nagyadam979/bee_scale/wireless_scaling/experiments/H2_hx711_power_path/meresi_setup.md

# H2 — Mérési setup (HX711 power-path / excitation-lekapcsolás)

Ez a doksi a **konkrét mérési elrendezést** írja le: bekötés, pinkiosztás, hol és hogyan
mérj, milyen alvariánsokat, és mit csinálj, ha túl nagy az áram / nem kapcsol le az
excitation. A firmware: lásd `main/h2_hx711_power_path.c` (a hangolható paraméterek a fájl
tetején). Eredmények: `mereseredmenyek.csv`. Cél/küszöbök: `README.md` pass/fail tábla.

> **A H2 LÉNYEGE — két mérés (lásd 3. szakasz):**
> **(A)** a HX711 modul nyugalmi árama a modul SAJÁT VCC ágában (NEM a teljes node tápjában!),
> **(B)** a load cell excitation feszültsége az E+/E− pontok között (alvásban cél ~0 V).
> A pass CSAK akkor áll, ha az áram < ~5 µA ÉS az excitation ~0 V ÉS nincs LED/szivárgás.

> **Pinout / modul-tények (webről ellenőrizve, 2026-06-28)** — források a 6. szakaszban:
> ESP32-C3 SuperMini pinout: espboards.dev / mozelectronics / lastminuteengineers. A
> klasszikus zöld/piros HX711 breakout-on **NINCS power/státusz LED**, és **NINCS külön
> LDO/regulátor** — a VCC közvetlenül a chipre megy (2.6–5.5 V), a hídgerjesztést a HX711
> **chipen belüli AVDD-regulátora** adja (a zöld boardon R12/R13 osztó állítja, gyárilag
> ~4.3 V, ami 5 V VCC-t feltételez; 3.3 V-ról kisebb E+, de jól megy). Datasheet power-down
> áram ~1 µA (akár ~70 nA a chipre). **A te darabodon ellenőrizd.**

---

## 1. Pinkiosztás

| Funkció | ESP32-C3 SuperMini | Megjegyzés |
|---|---|---|
| HX711 `PD_SCK` (SCK) | **GPIO5** | a firmware MAGASra húzza (power-down), alvás alatt GPIO-hold tartja HIGH-on |
| HX711 `DOUT` (DT) | **GPIO6** | a firmware bemenetnek hagyja, nem olvassa |
| HX711 `VCC` | 3V3 (LDO-ról szűrt 3.3V) | **a mérés alatt a modul VCC ágába kerül a DMM** sorba — lásd 3.(A) |
| HX711 `GND` | GND | közös föld |
| Load cell `E+` | HX711 `E+` | gerjesztés + (excitation, B mérés egyik pontja) |
| Load cell `E−` | HX711 `E−` | gerjesztés − (excitation, B mérés másik pontja) |
| Load cell `A+` | HX711 `A+` | jel + (itt nem olvassuk) |
| Load cell `A−` | HX711 `A−` | jel − (itt nem olvassuk) |
| Kék user LED | GPIO8 | a firmware kikapcsolva tartja (mérés alatt sötét) |
| Vörös power LED | — (nem GPIO) | a node „rejtett fogyasztója"; a HX711-modulon tipikusan NINCS LED |

A `PD_SCK`/`DOUT` GPIO-k a firmware tetején (`HX711_PD_SCK_GPIO`, `HX711_DOUT_GPIO`) — a
H1 pin-terv, NE változtasd. Strapping lábakat (GPIO2/8/9) kerülj általános IO-nak.

---

## 2. Bekötési diagram (ASCII)

Load cell 4 vezeték (HBS-SCL-50; a színek a cella adatlapja dönti el, de gyakorlatilag
univerzális): **piros=E+, fekete=E−, zöld=A+, fehér=A−** (sárga = árnyékolás, ha van).
A jel-vezetékek (zöld/fehér) felcserélése csak a mért érték előjelét fordítja.

```
              ESP32-C3 SuperMini                         HX711-M modul                 load cell
           +----------------------+                   +----------------+              (HBS-SCL-50)
           |                      |    (A) DMM uA      |                |
           |                  3V3 |---[ µA ]---------->| VCC            |
           |                  GND |------------------->| GND            |
           |   GPIO5 (PD_SCK) o---|------------------->| PD_SCK / SCK   |
           |   GPIO6 (DOUT)   o<--|-------------------| DOUT / DT      |
           |   GPIO8 (kek LED) .  |                   |                |
           |   [piros power LED]  |                   |  E+ ---------- piros  (E+)
           +----------------------+                   |  E- ---------- fekete (E-)
                                                       |  A+ ---------- zold   (A+)
           (A) µA a HX711 VCC agaban SOROSAN           |  A- ---------- feher  (A-)
                                                       +----------------+
                                                          ^   ^
                                                          |   |
                                          (B) DMM V ----[ V ]----  a load cell E+/E- koze
                                                  (excitation: ebren > 0 V, alvasban ~0 V = PASS)
```

A node kék LED (GPIO8) a firmware-ben kikapcsolva; a vörös power LED a SuperMinin tápra mindig
világít (a HX711-modulon tipikusan nincs LED). A két DMM-bekötést (A és B) **külön** mérd.

---

## 3. A KÉT MÉRÉS — ez a H2 lényege

### (A) HX711 modul nyugalmi árama — a modul SAJÁT VCC ágában

A DMM-et (DC áram, **µA tartomány**) **SOROSAN a HX711 modul VCC ága közé** kösd: a board
**3V3** lába és a modul **VCC** lába közé. **NEM** a teljes node tápjába!

> **Miért a modul VCC ágában, és nem a teljes node tápjában?** A node maga ~185 µA-t vesz fel
> (H1-ben mért alapszám: AMS1117 LDO + GPIO/RTC). E mellett a HX711 ~1–5 µA-ja
> **differenciál-méréssel** (teljes node HX711-gyel mínusz HX711 nélkül) elveszne a zajban
> (185 vs 186 µA — leolvashatatlan). Ezért a HX711-modul áramát **KÜLÖN**, a saját VCC
> ágában mérjük: így közvetlenül a modul nyugalmi árama jön ki, ez hasonlítható a < ~5 µA
> küszöbhöz.

- DMM-beállítás: DC áram, µA tartomány (auto-range esetén várj a stabil értékre). A piros
  vezeték a műszer **A/µA hüvelyébe** (külön bemenet az árammérésnek), különben rövidre zárod.
- Olvasd le a stabil deep-sleep értéket, és írd a CSV `hx711_aram_uA` oszlopába.

### (B) Excitation feszültség — a load cell E+/E− pontjai között

A DMM-et (**V tartomány**) a load cell **E+ és E−** pontjai közé kösd (a HX711 modul E+/E−
kivezetésére).

> **FONTOS — az "ébren" referencia kell:** a firmware alapból a boot legelején AZONNAL
> power-downba teszi a HX711-et, így nincs ablak, amikor a chip aktív. A puszta ~0 V alvásban
> egy szakadt/rosszul bekötött cellánál is teljesülne → az önmagában NEM bizonyít
> *lekapcsolást*. Ezért a (B) méréshez kell egy "be" referencia, amit az `EXCITATION_PROBE_MS`
> paraméter ad (lásd a firmware tetején). **A két mérés KÉT KÜLÖN flasheléssel történik:**
>
> - **(A) áram-mérés:** `EXCITATION_PROBE_MS = 0` (a tiszta, azonnali power-down).
> - **(B) excitation-mérés:** `EXCITATION_PROBE_MS = 30000` (30 s) — vagy amennyi a méréshez
>   kell —, majd **flashelj újra**. Boot után a firmware ennyi ms-ig AKTÍVAN tartja a HX711-et
>   (PD_SCK LOW, órajel-impulzus nélkül), és a logban kiírja:
>   `EXCITATION PROBE: HX711 AKTIV ... mERd most az E+/E-...`.

- **A probe-ablakban (HX711 aktív, a log jelzi):** a chip ad gerjesztést. 3.3 V-os VCC-nél a
  gyári R12/R13 osztóval kisebb (~2–3 V nagyságrend) — a lényeg, hogy **NEM nulla**. Ezt mérd
  az E+/E− között → ez a "be" referencia (> 0 V).
- **Alvásban** (a probe lejárt → power-down → deep sleep, PD_SCK magas): a chipen belüli
  AVDD-regulátor leáll → a cél **~0 V**. Mérd újra az E+/E−-t.
- **Várt eredmény:** probe-ablakban > 0 V, alvásban ~0 V → az excitation lekapcsol = **PASS**
  (a B feltétel). Az "ébren" (probe) mért E+/E− értéket a CSV `megjegyzes` oszlopába jegyezd fel.

---

## 4. Mérési menet

> **A két mérés két külön flashelés** (külön `EXCITATION_PROBE_MS` értékkel a firmware tetején):
> az (A) áram-méréshez `0`, a (B) excitation-méréshez `> 0` (pl. `30000`).

1. **Flashelés.** Állítsd be az `EXCITATION_PROBE_MS`-t az aktuális méréshez (lásd fent), majd
   `idf.py set-target esp32c3 && idf.py build`, és `idf.py -p <PORT> flash monitor` (vagy
   `pio run -t upload -t monitor`).
   - **Tartós deep sleepnél (`DEEP_SLEEP_WAKEUP_SEC` == 0):** a board alvásban NEM enumerál
     USB-n → nincs port. **Download mód kell:** BOOT gomb nyomva + USB ki/be (vagy reset) →
     download mód, majd BOOT elengedése, és flashelj.
   - Ciklikus méréshez `DEEP_SLEEP_WAKEUP_SEC` > 0 megkerüli (periodikusan ébred → enumerál).
2. **(A) áram-mérés — `EXCITATION_PROBE_MS = 0`.** A boot-log kiírja: `Deep sleepbe lepunk...`
   — **innentől** van a modul power-downban, a multiméter ettől mutat nyugalmi áramot. Olvasd
   le a HX711 VCC ágában (3.(A)), és írd a CSV `hx711_aram_uA` oszlopába. (A monitor
   lecsatlakoztatása nem ébreszti fel; tartós alvásnál csak RESET ébreszt.)
3. **(B) excitation-mérés — `EXCITATION_PROBE_MS = 30000`, újraflash.** Boot után a log kiírja:
   `EXCITATION PROBE: HX711 AKTIV ...` — **a probe-ablakban** (HX711 aktív) mérd az E+/E−-t
   (várt > 0 V = "be" referencia). Amikor a probe lejár és `Deep sleepbe lepunk...` jön
   (power-down → deep sleep), mérd újra az E+/E−-t (várt ~0 V) → a lekapcsolás igazolva.
   A "be" értéket a CSV `megjegyzes`-be, az alvásbeli ~0 V-ot az `excitation_V` oszlopba.

---

## 4b. Kiegészítő mérés: HX711 AKTÍV (üzemi) fogyasztás — aktív-ciklus mód

Az (A)/(B) a HX711 *nyugalmi* (power-down) oldalát méri. Ha a HX711 **aktív (powered-up)**
üzemi fogyasztására vagy kíváncsi (mennyit visz a modul mérés közben), a firmware
`H2_MEASURE_MODE = 1` (aktív-ciklus) módja erre való:

- Az **ESP ÉBREN marad** (NINCS deep sleep, NINCS USB-JTAG pad off → a soros log végig él,
  `pio device monitor`-ral nézhető), és a HX711-et a végtelenségig ciklusolja:
  **`HX711_POWERUP_MS`** (alap 10 000 ms) powered-up (PD_SCK LOW, excitation BE) →
  **`HX711_POWERDOWN_MS`** (alap 10 ms) power-down (PD_SCK HIGH).
- **Mérés:** a **teljes node-áramot** (overall fogyasztás) figyeld a szokásos táp-ágban
  (5V vagy 3V3). A powered-up ablakok idejére az áram megugrik; a **powered-up vs.
  power-down szint különbsége ≈ a HX711 aktív üzemi árama** (tipikusan ~1–1.5 mA).
- A 10 ms power-down ablak DMM-en **nem** olvasható le (csak gyors átkapcsolás). Ha a
  power-down szintet is stabilan le akarod olvasni, növeld a `HX711_POWERDOWN_MS`-t
  másodperces értékre, és fordíts/flashelj újra.
- Flashelés: ha a board épp a deep-sleep módban (MODE 0) alszik, előbb download mód
  (BOOT + USB ki/be). MODE 1-ben a board nem alszik → utána végig enumerál.

> A `H2_MEASURE_MODE = 0` adja vissza az alap deep-sleep/excitation mérést (A + B).
> A két mód KÜLÖN flasheléssel váltható (a paraméter a firmware tetején).

---

## 4c. Data-monitor mód (`H2_MEASURE_MODE = 2`) — bekötés-ellenőrzés / nyers ADC

Szanity-eszköz a HX711 + load cell bekötésének ellenőrzésére és a nyers mérleg-adat
monitorozására (NEM fogyasztás-mérés):

- Az **ESP ÉBREN**, a HX711 powered-up; a firmware `HX711_MONITOR_PERIOD_MS`-onként (alap 500 ms)
  kiolvassa a **nyers 24-bit ADC** értéket (bit-bang: vár a DOUT LOW-ra, 25 SCK-impulzus, A
  csatorna gain 128, `HX711_MONITOR_AVG` minta átlaga), és a soros logra írja: `HX711 raw=...`.
- **Nézés:** a saját termináldban `pio device monitor -p <PORT> -b 115200`. **Terheld a cellát** →
  a `raw` értéknek érdemben változnia kell. NINCS kalibráció → az érték nyers ADC, nem kg.
- **Hibajelek:** `HX711 DOUT timeout` → DOUT(GPIO6)/SCK(GPIO5) vagy a HX711 tápja; konstans
  telített érték (±teljes skála) → cella híd / E+/E−/A+/A− bekötés (pl. félhíd→teljes híd
  kiegészítés a 953R 0,1% ellenállásokkal). A HX711-olvasó kód az Sz1 / kalibráció alapja.

---

## 5. Hibakeresés (sorrendben — a modulcsere a VÉGE, nem az eleje)

1. **Áram 100+ µA ÉS a cellán nem 0 V → szinte biztos, hogy a `PD_SCK` nem marad magasan
   deep sleepben** (az ESP elengedte a lábat). Ez a leggyakoribb valós ok — **NEM modulhiba**
   (lásd kohacraft). Ellenőrizd, sorban:
   - (i) a boot-log kiírta-e: `GPIO hold: PD_SCK(GPIO5) HIGH es LED(GPIO8) megtartva...`?
   - (ii) mérd meg DMM-mel a `PD_SCK` (GPIO5) lábat **alvásban** — tényleg HIGH (~3.3 V)?
   - (iii) **biztonsági háló:** tegyél **10–50 kΩ felhúzót a PD_SCK-ra 3.3 V-ra**
     (a 47–50 kΩ energiatakarékosabb), hogy a láb akkor is magasan maradjon, ha a hold elengedne.
2. **Ha a `PD_SCK` bizonyítottan magasan van (>60 µs), de a modul mégis 100+ µA-t visz ÉS a
   cellán feszültség marad → atipikus modul** (rossz klón chip, vagy egy külön, mindig-
   bekapcsolt LDO a hídon, ami a chip power-downja ellenére táplálja). **EKKOR indokolt a
   modulcsere** ismert jó, dokumentált schematic-ú darabra (SparkFun / Soldered).
3. **LED.** Ha mA-es fogyasztást látsz: ellenőrizd, van-e LED a modulon. A tipikuson NINCS
   (SparkFun + Soldered nyílt referenciaterv LED nélküli). Ha mégis → atipikus/hibás variáns,
   modulcsere.
4. **3.3 V-os üzem megjegyzése.** A gyári R12/R13 osztó **5 V-ra** van hangolva → 3.3 V-on
   kisebb az E+ (ezért láthatsz ébren ~2–3 V-ot, nem ~4.3-at). A H2 méréshez ez **nem baj**
   (úgyis a *lekapcsolást* igazoljuk), de a HW-pontossághoz (Sz1, mérési pontosság) később
   **R12-csere** kellhet (Hackaday „Honeybee hive monitoring" R12/R13 módosítás).

---

## 6. Mérési napló — kitöltésre

> Ide a tényleges mérés napján írd be a setupot és az eredményt (modul, PD_SCK ellenőrzés,
> (A) áram, (B) excitation ébren/alvásban, pass/fail). A számokat a `mereseredmenyek.csv`-be is.

### 2026-06-28 — aktív-ciklus mérés (MODE 1)

ESP32-C3 SuperMini, HX711-M (olcsó breakout) + load cell (HBS-SCL-50) bekötve. Mérés a node
**overall áramában**, a HX711 tápjának le-/felvételével (differenciál). Először 10 s / 10 ms
ciklus (a power-down nem látszott — a 0,1% duty miatt a DMM átlagolta), majd **szimmetrikus
10 s / 10 s** ciklus → a leesés tisztán látszik.

| Lépés | Mérés | Érték | Megjegyzés |
|---|---|---|---|
| HX711+cella AKTÍV (PD_SCK LOW, powered-up) | overall áram / HX711-táp diff | **~5 mA** | a HX711 + load cell híd üzemi árama |
| HX711 POWER-DOWN (PD_SCK HIGH) | overall áram | **~0-ra esik** | a lekapcsolás IGAZOLVA aktív ESP mellett is |
| HX711 nyugalmi (deep-sleep, MODE 0, korábbi (A)) | overall node-áram | nincs észlelhető növekedés | a power-down áram elhanyagolható (< pár µA) |
| (B) excitation E+/E− [V] | — | (V-ben külön nem mérve) | közvetve igazolt: power-down ~0 mA → a híd nem kap gerjesztést |
| **Összesítés** | pass/fail | **PASS** | power-down ~0, nyugalmi elhanyagolható, nincs LED/szivárgás |

**Tanulságok:**
- A HX711 power-down (PD_SCK=HIGH) rendesen **~0-ra viszi** a modul+cella áramát — aktív ESP
  mellett is. A „nem kapcsol le" kezdeti észlelés a **10 ms / 10 s duty cycle műterméke** volt
  (a DMM a 0,1%-os power-down ablakot átlagolta); szimmetrikus 10 s / 10 s ciklusban már tiszta.
- A HX711+cella **aktív árama ~5 mA** — ennyit kell a node-nak adnia a tényleges méréskor;
  deep sleepben gyakorlatilag 0. A modulon nincs LED / szivárgó tápút (egybevág a kutatással).
- Az excitation feszültséget V-ben külön nem mértük; a power-down ~0 mA híd-áram közvetve
  igazolja, hogy a gerjesztés lekapcsol. (Ha explicit V-kontroll kell: MODE 0 + EXCITATION_PROBE_MS.)

---

## 7. Források (webről, 2026-06-28)

- **HX711 modul (LED, LDO, AVDD-regulátor, R12/R13):**
  Soldered HX711 hardware docs — https://docs.soldered.com/hx711/hardware/ ;
  SparkFun HX711 breakout (nyílt schematic, PowerTest 70 nA) ;
  Hackaday „Honeybee hive monitoring — Modifying the HX711 Breakout Board for 3.3V" (R12/R13).
- **Power-down áram / PD_SCK magasan tartás (a fő valós ok):**
  kohacraft — https://en.kohacraft.com/archives/esp32-reduced-current-consumption-during-deepsleep-by-putting-hx711-into-power-down-mode.html (~120 µA, fő ok: PD_SCK nem maradt magasan) ;
  Arduino Forum „Reducing current consumption of HX711" ; Hiveeyes community.
- **ESP32-C3 SuperMini pinout:** espboards.dev/esp32/esp32-c3-super-mini/ ;
  mozelectronics.com ; lastminuteengineers.com ESP32-C3 Super Mini pinout.
