nagyadam979/bee_scale/prototype/experiments/board_12/board_12.ino

#include <Arduino.h>
#include <HX711.h>
#include <Wire.h>
#include <Adafruit_AHTX0.h>
#include <Adafruit_BMP280.h>
#include <WiFi.h>
#include <ArduinoOTA.h>
#include <WiFiServer.h>
#include <WiFiClient.h>
#include <Preferences.h>
#include <time.h>

#include "secrets.h"
#include "config.h"
#include "rtdb_writer.h"

// Board "12" — MAC …31:50
// HW-csere után (2026-06-08): a régi board_12 HX711-e hibás volt (raw ~-1000 random
// zaj, majd a modul cseréje után raw=0 stuck). Végül TELJES csere: új ESP32-C3 + új
// HX711 → stabil raw ~-233k. Az új board bekötése DOUT=2/SCK=1 (= board_21 mappingje).
#define HX711_DOUT    2
#define HX711_SCK     1
// AHT20+BMP280 I2C busz (2026-06-08, board_12-re kötve). Az ESP32-C3 GPIO-mátrixa
// tetszőleges láboszt enged I2C-re; a HX711 a 2/1-en, az I2C az 5/6-on van.
#define I2C_SDA       6
#define I2C_SCL       5
#define BMP280_ADDR_A 0x76   // kínai AHT20+BMP280 kombómodulok tipikus címe
#define BMP280_ADDR_B 0x77   // Adafruit-breakout alapcím (fallback)
#define TELNET_PORT   23
#define STREAM_MS     500
#define TARE_SAMPLES  64    // ~6.4 s @ 10 SPS
#define CAL_SAMPLES   64

HX711          scale;
Adafruit_AHTX0 aht;     // hőmérséklet + páratartalom
Adafruit_BMP280 bmp;    // nyomás (+ hőmérséklet, nem használt)
bool           ahtOk = false;
bool           bmpOk = false;
WiFiServer  telnetSrv(TELNET_PORT);
WiFiClient  telnetClient;
Preferences prefs;

enum Mode { STREAM, MENU, CAL_INPUT };
Mode   tMode = STREAM;
String inputBuf;

// --- dual output ----------------------------------------------------------
static void out(const char* s) {
  Serial.print(s);
  if (telnetClient && telnetClient.connected()) telnetClient.print(s);
}
static void outln(const char* s = "") {
  Serial.println(s);
  if (telnetClient && telnetClient.connected()) {
    telnetClient.print(s); telnetClient.print("\r\n");
  }
}

// --- NVS ------------------------------------------------------------------
static void calibSave() {
  prefs.begin("hx711", false);
  prefs.putLong ("offset", scale.get_offset());
  prefs.putFloat("factor", scale.get_scale());
  prefs.end();
  outln(">> Mentve NVS-be.");
}
static void calibLoad() {
  prefs.begin("hx711", true);
  long  off = prefs.getLong ("offset", 0);
  float fac = prefs.getFloat("factor", 1.0f);
  prefs.end();
  scale.set_offset(off);
  scale.set_scale(fac > 0.0f ? fac : 1.0f);
  Serial.printf("[NVS] offset=%ld  factor=%.4f\n", off, fac);
}

// --- menü -----------------------------------------------------------------
static void showMenu() {
  char buf[48];
  outln("\r\n+---------------------------+");
  outln("|    bee_scale  12  menu    |");
  outln("+---------------------------+");
  snprintf(buf, sizeof(buf), "| offset=%-7ld  factor=%-6.1f|",
           scale.get_offset(), scale.get_scale());
  outln(buf);
  outln("+---------------------------+");
  outln("|  [t]  tara (nulláz)       |");
  outln("|  [c]  kalibráció (kg)     |");
  outln("|  [s]  aktuális érték      |");
  outln("|  [r]  raw ADC             |");
  outln("|  [e]  env (t/h/p)         |");
  outln("|  [b]  I2C busz scan       |");
  outln("|  [i]  info / IP           |");
  outln("|  [q]  vissza streamingbe  |");
  outln("+---------------------------+");
  out("> ");
}

static void doTare() {
  char buf[64];
  snprintf(buf, sizeof(buf), "\r\nTara (%d minta, ~%.0f s)...",
           TARE_SAMPLES, TARE_SAMPLES / 10.0f);
  outln(buf);
  scale.tare(TARE_SAMPLES);
  snprintf(buf, sizeof(buf), "Kész — offset=%ld", scale.get_offset());
  outln(buf);
  calibSave();
}

static void doCal(float kg) {
  char buf[80];
  snprintf(buf, sizeof(buf), "Kalibráció (%d minta, ~%.0f s)...",
           CAL_SAMPLES, CAL_SAMPLES / 10.0f);
  outln(buf);
  float val = scale.get_value(CAL_SAMPLES);
  if (val == 0.0f) { outln("!! Nulla tared érték — előbb tara!"); return; }
  float fac = val / kg;
  scale.set_scale(fac);
  snprintf(buf, sizeof(buf), "Kész — factor=%.4f  (%.3f kg)", fac, kg);
  outln(buf);
  calibSave();
}

static void handleMenuKey(char ch) {
  char buf[128];
  switch (ch) {
    case 't': doTare(); showMenu(); break;
    case 'c':
      outln("\r\nReferencia súly kg-ban (pl. 20.5), Enter:");
      out("> ");
      inputBuf = "";
      tMode = CAL_INPUT;
      break;
    case 's':
      if (scale.wait_ready_timeout(500)) {
        long  r  = scale.read();
        float kg = (float)(r - scale.get_offset()) / scale.get_scale();
        snprintf(buf, sizeof(buf), "\r\n  → %.3f kg  (raw=%ld)", kg, r);
        outln(buf);
      } else outln("\r\n  → HX711 TIMEOUT");
      showMenu();
      break;
    case 'r':
      if (scale.wait_ready_timeout(500)) {
        long r = scale.read();
        snprintf(buf, sizeof(buf),
                 "\r\n  raw=%ld  offset=%ld  tared=%ld  factor=%.4f  => %.3f kg",
                 r, scale.get_offset(), r - scale.get_offset(),
                 scale.get_scale(),
                 (float)(r - scale.get_offset()) / scale.get_scale());
        outln(buf);
      } else outln("\r\n  → HX711 TIMEOUT");
      showMenu();
      break;
    case 'e': {
      Reading re;
      uint32_t ep = (uint32_t)time(nullptr);
      if (readEnv(ep, re)) {
        snprintf(buf, sizeof(buf),
                 "\r\n  t=%.2f °C  h=%.2f %%RH  p=%.2f hPa", re.t, re.h, re.p);
      } else {
        snprintf(buf, sizeof(buf),
                 "\r\n  env olvasás SIKERTELEN (AHT20=%s BMP280=%s)",
                 ahtOk ? "ok" : "fail", bmpOk ? "ok" : "fail");
      }
      outln(buf);
      showMenu();
      break;
    }
    case 'b': {
      outln("\r\nI2C scan (0x08..0x77)...");
      int found = 0;
      for (uint8_t addr = 0x08; addr <= 0x77; addr++) {
        Wire.beginTransmission(addr);
        if (Wire.endTransmission() == 0) {
          snprintf(buf, sizeof(buf), "  found 0x%02X", addr);
          outln(buf);
          found++;
        }
      }
      snprintf(buf, sizeof(buf), "  osszesen: %d eszkoz", found);
      outln(buf);
      showMenu();
      break;
    }
    case 'i':
      snprintf(buf, sizeof(buf),
               "\r\n  IP=%s  RSSI=%ddBm\r\n  offset=%ld  factor=%.4f\r\n  rtdb pending=%u",
               WiFi.localIP().toString().c_str(), WiFi.RSSI(),
               scale.get_offset(), scale.get_scale(),
               (unsigned)rtdbPending());
      outln(buf);
      showMenu();
      break;
    case 'q':
      outln("\r\nStreaming... (bármely billentyű = menü)");
      tMode = STREAM;
      break;
    default: showMenu(); break;
  }
}

static void handleCalInput(const String& line) {
  float kg = line.toFloat();
  if (kg > 0.0f) {
    doCal(kg);
    tMode = MENU;
    showMenu();
  } else {
    outln("Érvénytelen — próbáld újra (pl. 20.5):");
    out("> ");
    inputBuf = "";
  }
}

// --- RTDB mintavétel ------------------------------------------------------
// 5 percenként (és az első érvényes NTP-időnél azonnal) átlagolt kalibrált
// súlymintát vesz, és a FIFO-ba teszi. NEM blokkol (millis()-alapú), és a
// telnet módtól FÜGGETLENÜL fut (a loop a streaming early-return ELŐTT hívja).
static uint32_t g_lastSampleMs    = 0;
static bool     g_firstSampleDone = false;

static bool timeValid(uint32_t &epochOut) {
  const time_t now = time(nullptr);
  if ((uint32_t)now < VALID_EPOCH_MIN) return false;  // óra még nincs szinkronban
  epochOut = (uint32_t)now;
  return true;
}

// AHT20 (t,h) + opcionálisan BMP280 (p) → env Reading. Az AHT20 a kötelező mag:
// ha az nincs / nem ad adatot → nincs env minta (false). A nyomás OPCIONÁLIS —
// ha a BMP280 nem elérhető vagy hibázik, p = NAN, és a push kihagyja a p mezőt.
static bool readEnv(uint32_t epoch, Reading &r) {
  if (!ahtOk) return false;                      // AHT20 nélkül nincs env minta
  sensors_event_t hum, tmp;
  if (!aht.getEvent(&hum, &tmp)) return false;
  r.ts   = epoch;
  r.type = REC_ENV;
  r.t    = tmp.temperature;                      // °C
  r.h    = hum.relative_humidity;                // %RH
  r.p    = NAN;                                  // nyomás csak ha a BMP280 él
  if (bmpOk) {
    const float pa = bmp.readPressure();         // Pa
    if (pa > 0.0f) r.p = pa / 100.0f;            // hPa
  }
  return true;
}

static void sampleMaintain() {
  uint32_t epoch;
  if (!timeValid(epoch)) return;   // ts nélkül nem tűzünk rekordot

  const bool due = !g_firstSampleDone ||
                   (millis() - g_lastSampleMs >= SEND_INTERVAL_MS);
  if (!due) return;

  if (!scale.is_ready()) return;   // ha az ADC nem kész, később újrapróbáljuk

  Reading rw;
  rw.type = REC_WEIGHT;
  rw.ts   = epoch;
  rw.w    = scale.get_units(WEIGHT_AVG_SAMPLES);  // átlagolt kg: (avg-offset)/scale
  rtdbEnqueue(rw);

  // Env minta ugyanabban az ütemben (külön RTDB ágra). Ha a szenzor nem elérhető,
  // a súly attól még megy — az env egyszerűen kimarad ebből a ciklusból.
  Reading re;
  if (readEnv(epoch, re)) {
    rtdbEnqueue(re);
    Serial.printf("[SAMPLE] ts=%lu w=%.2f t=%.2f h=%.2f p=%.2f (pending=%u)\n",
                  (unsigned long)epoch, rw.w, re.t, re.h, re.p,
                  (unsigned)rtdbPending());
  } else {
    Serial.printf("[SAMPLE] ts=%lu w=%.2f env=SKIP (pending=%u)\n",
                  (unsigned long)epoch, rw.w, (unsigned)rtdbPending());
  }

  g_lastSampleMs    = millis();
  g_firstSampleDone = true;
}

// -------------------------------------------------------------------------
void setup() {
  Serial.begin(115200);
  delay(500);
  Serial.println("\n[bee_scale] board-12  HX711+AHT20+BMP280+WiFi+OTA+Telnet");

  scale.begin(HX711_DOUT, HX711_SCK);
  calibLoad();
  Serial.println("[HX711] OK");

  // I2C környezeti szenzorok (AHT20 + BMP280) — SDA=6, SCL=5.
  Wire.begin(I2C_SDA, I2C_SCL);
  ahtOk = aht.begin(&Wire);
  Serial.printf("[AHT20] %s\n", ahtOk ? "OK" : "FAIL");
  // A kombómodulok 0x76-on, az Adafruit-breakout 0x77-en ül — mindkettőt próbáljuk.
  bmpOk = bmp.begin(BMP280_ADDR_A) || bmp.begin(BMP280_ADDR_B);
  if (bmpOk) {
    // Időszakos, alacsony zajú mérés: ×2 hőm, ×16 nyomás oversampling, IIR ×16.
    bmp.setSampling(Adafruit_BMP280::MODE_NORMAL,
                    Adafruit_BMP280::SAMPLING_X2,
                    Adafruit_BMP280::SAMPLING_X16,
                    Adafruit_BMP280::FILTER_X16,
                    Adafruit_BMP280::STANDBY_MS_500);
  }
  Serial.printf("[BMP280] %s\n", bmpOk ? "OK" : "FAIL");

  WiFi.mode(WIFI_STA);
  WiFi.setAutoReconnect(true);
  WiFi.persistent(true);
  WiFi.begin(WIFI_SSID, WIFI_PASSWORD);
  Serial.printf("[WiFi] %s", WIFI_SSID);
  for (int i = 0; i < 40 && WiFi.status() != WL_CONNECTED; i++) {
    delay(500); Serial.print(".");
  }
  Serial.println();

  if (WiFi.status() != WL_CONNECTED) {
    Serial.println("[WiFi] FAIL");
    return;
  }
  Serial.printf("[WiFi] OK  IP=%s  RSSI=%ddBm\n",
                WiFi.localIP().toString().c_str(), WiFi.RSSI());

  // NTP-szinkron (UTC, offset 0) + Firebase RTDB init — WiFi UTÁN.
  configTime(0, 0, "pool.ntp.org");
  Serial.println("[NTP] time sync requested");
  rtdbBegin();

  ArduinoOTA.setHostname("bee-scale-12");
  ArduinoOTA.setPassword(OTA_PASSWORD);
  ArduinoOTA.onStart([]()   { Serial.println("[OTA] start"); });
  ArduinoOTA.onEnd([]()     { Serial.println("[OTA] kész"); });
  ArduinoOTA.onProgress([](unsigned int p, unsigned int t) {
    Serial.printf("[OTA] %u%%\r", p * 100 / t);
  });
  ArduinoOTA.onError([](ota_error_t e) { Serial.printf("[OTA] hiba %u\n", e); });
  ArduinoOTA.begin();

  telnetSrv.begin();
  telnetSrv.setNoDelay(true);
  Serial.printf("[Telnet] →  nc %s %d\n", WiFi.localIP().toString().c_str(), TELNET_PORT);
}

static uint32_t lastStreamMs = 0;

void loop() {
  ArduinoOTA.handle();

  if (!telnetClient || !telnetClient.connected()) {
    WiFiClient nc = telnetSrv.available();
    if (nc) {
      telnetClient = nc;
      tMode = STREAM;
      inputBuf = "";
      outln("bee_scale-12  —  bármely billentyű = menü");
    }
  }

  while (telnetClient && telnetClient.available()) {
    char ch = (char)telnetClient.read();
    if (tMode == STREAM) {
      if (ch == '\r' || ch == '\n') continue;
      tMode = MENU;
      showMenu();
    } else if (tMode == MENU) {
      handleMenuKey(ch);
    } else if (tMode == CAL_INPUT) {
      if (ch == '\n' || ch == '\r') {
        if (inputBuf.length()) handleCalInput(inputBuf);
      } else if (ch == 127 || ch == 8) {
        if (inputBuf.length()) { inputBuf.remove(inputBuf.length() - 1); out("\b \b"); }
      } else {
        inputBuf += ch; char e[2] = {ch, 0}; out(e);
      }
    }
  }

  // RTDB feltöltés + mintavétel: MINDEN loopban, a telnet módtól FÜGGETLENÜL
  // (a streaming early-return ELŐTT) — különben menü módban leállna a feltöltés.
  rtdbLoop();
  sampleMaintain();

  if (tMode != STREAM) return;
  if (millis() - lastStreamMs < STREAM_MS) return;
  lastStreamMs = millis();

  if (!scale.is_ready()) return;
  long  r  = scale.read();
  float kg = (float)(r - scale.get_offset()) / scale.get_scale();
  char  buf[32];
  snprintf(buf, sizeof(buf), "%.3f kg\r\n", kg);
  out(buf);
}
