nagyadam979/bee_scale/wireless_scaling/firmware/master/main/wifi_config.example.h

#pragma once

/* A helyi statusz oldalhoz hasznalt WiFi. Ez a fajl szandekosan nem tartalmaz
 * Firebase vagy mas felho-konfiguraciot. Masold wifi_config.h neven, es azt
 * ne commitold. A router 2.4 GHz-es csatornaja egyezzen MASTER_ESPNOW_CHANNEL-lel. */
#define MASTER_WIFI_SSID "my-wifi-ssid"
#define MASTER_WIFI_PASS "my-wifi-password"
