nagyadam979/bee_scale/wireless_scaling/firmware/master/main/cloud_config.example.h

#pragma once

#define MASTER_WIFI_SSID "my-wifi-ssid"
#define MASTER_WIFI_PASS "my-wifi-password"

#define MASTER_FIREBASE_API_KEY "firebase-web-api-key"
#define MASTER_FIREBASE_DATABASE_URL "https://project-default-rtdb.region.firebasedatabase.app"
#define MASTER_FIREBASE_EMAIL "esp32@beescale.local"
#define MASTER_FIREBASE_PASSWORD "device-user-password"
#define MASTER_FIREBASE_HIVE_ID "hive1"
