nagyadam979/bee_scale/(commit log)

2026-05-31 feat(firmware): ESP32→Firebase RTDB súly-feltöltő modul (Feladat 01) + éles teszt
    MI KÉSZÜLT
    - Arduino-ESP32 firmware kommunikációs modul, ami 5 percenként egy súlymérési
    rekordot tölt fel a Firebase RTDB-be, hitelesítve és hibatűrően.
    - Fájlok:
    - firmware/bee_scale_rtdb/bee_scale_rtdb.ino — fő sketch: WiFi, NTP, 5 perces
    millis()-mintavétel (nem delay), orchestráció.
    - config.h — nem-titkos konfig (HIVE_ID, intervallum, buffer-cap, backoff, NTP).
    - secrets.h.example — titok-sablon; a valós secrets.h GITIGNORE-olt (nincs commitolva).
    - weight_source.h — getWeights() → {w_total, w1, w2} absztrakció.
    - weight_source_mock.cpp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
2026-05-31 feat(web): read-only kaptármérleg dashboard (Firebase Hosting + RTDB) — Feladat 02
    MIT
    - Statikus, build-lépés nélküli web app a public/-ban: index.html + app.js + style.css.
    Firebase JS SDK 12.4.0 (modular, gstatic CDN) + Chart.js 4.4.6 + chartjs-adapter-date-fns 3.0.0 (jsDelivr CDN).
    - Login gate (Firebase Auth email/jelszó), kijelentkezés gomb. onAuthStateChanged vezérli a nézetváltást.
    - Adatlekérés indexelt query-vel: ref('hives/hive1/readings') + orderByChild('ts') +
    startAt(now - ablak) ill. "összes"-nél limitToLast(ALL_LIMIT=10000). SOHA nem húzza le a teljes ágat.
    - Élő frissítés: onChildAdded startAt(betöltési baseline)-nal → csak az ÚJ pushokra t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
2026-05-31 feat(web): bejelentkezés nélküli dashboard — anonim Firebase Auth (login gate kivezetve)
    - A korábbi email/jelszós login gate helyett az app most ANONIM Auth-tal csatlakozik
    automatikusan (signInAnonymously az onAuthStateChanged null-ágában).
    - index.html: a #login-view (email/jelszó form) helyett egyszerű "Csatlakozás…" splash
    (#splash-view) hibaüzenet-mezővel; a topbarból kivettem a user-email + Kilépés gombot.
    - app.js: signInWithEmailAndPassword/signOut import → signInAnonymously; showLogin→showSplash,
    showDashboard már nem kér user-emailt; barátságos splash-hibaüzenet operation-not-allowed esetén.
    - README: viewer-user szekció helyett "Anonymous A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
2026-06-07 chore(experiments): experiments/ mappa létrehozva — firmware újraírás sandbox
    Mit: Üres experiments/ mappa (.gitkeep) a repo gyökerében.
    Miért: Az HX711 valós olvasó firmware fejlesztéséhez elkülönített munkakörnyezet,
    hogy a meglévő firmware/bee_scale_rtdb/ (kommunikációs modul + mock) érintetlen maradjon
    a kísérletek alatt.
    Branch: dev_01 (main-ből leágaztatva).
    Nyitott: experiments/ belső struktúra (projekt mappa neve, .ino / platformio.ini)
    még nem döntött — következő lépésben.
2026-06-07 fix(experiments): HX711 pin definíciók javítva — GPIO2 DT, GPIO1 SCK
    Mit: HX711_DATA_PIN_A 0→2, HX711_DATA_PIN_B 2→4, HX711_SCK_PIN marad 1.
    Miért: GPIO0 ESP32-C3-on boot-strapping pin → nem megbízható DOUT-nak.
    A bekötött HX711 DOUT=GPIO2, SCK=GPIO1 → ez lett az "A" csatorna.
    DATA_PIN_B=4 placeholder a második HX711-nek (még nincs bekötve);
    ha B bekötésekor timeout-ol, az várható és helyes viselkedés.
    Tesztelve: még nem (fordítás + valós hw szükséges) — következő lépés.
    [hx117_exp.cpp]
2026-06-07 feat(experiments): hx711_exp sketch — single HX711 probe, GPIO2/GPIO1, CDCOnBoot
    Mit: Egyszerzős HX711 probe sketch (experiments/hx711_exp/hx711_exp.ino).
    Érintett fájlok: hx711_exp.ino (új), hx117_exp.cpp (pin javítás korábban).
    Miért: Az eredeti dual-HX711 kód scaleB.set_gain() hívása (GPIO4, bekötetlen)
    blokkolva tartotta a setup()-ot → Serial output sosem jött ki.
    A bogde HX711 lib begin()/set_gain() belsőleg wait_ready()-t hív, ami végtelen
    ciklus, ha a DOUT nem húz le. Megoldás: egyetlen HX711 (A, GPIO2), B elhagyva.
    CDCOnBoot=cdc: az arduino-esp32 3.x esp32c3 target alapból UART0-ra
    (GPIO20/21) rakja a Serial-t, nem a USB-JTAG bridge-re. CDCOnBoot=cdc
    átirán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
2026-06-07 fix(experiments): DOUT/SCK felcserélve — GPIO1=DOUT, GPIO2=SCK, valós raw értékek
    Mit: HX711_DATA_PIN_A 2→1, HX711_SCK_PIN 1→2. Banner dinamikus printf-re cserélve.
    Miért: GPIO2=DOUT / GPIO1=SCK kiosztásnál TIMEOUT jött (DOUT soha nem ment LOW).
    Felcserélve (DOUT=GPIO1, SCK=GPIO2) azonnal valós értékek jöttek.
    Mi működött (valós hw log):
    HX711 begin done → raw értékek: -2972 → ... → ~1700 (stabilan)
    Nem-nulla, zajló értékek = HX711 él, load cell olvas.
    Nyitott: tara + scale_factor kalibráció, majd dual HX711 visszaadása.
    [hx711_exp.ino]
2026-06-07 fix(experiments): HX711 probe működik — DOUT=GPIO2, SCK=GPIO1, raw ~358k stabil
    Mit: Diagnosztika eltávolítva (gpioReport() setup()-ból), pinek visszaállítva
    DOUT=GPIO2, SCK=GPIO1. Sketch letisztítva.
    Gyökérok a raw:0 hibára: a gpioReport() hívás begin() UTÁN mindkét pint
    INPUT módba állította — ezzel az SCK pin OUTPUT módja elveszett, a HX711
    nem kapott órajelet, 24 db 0-t olvasott a lib → raw = 0.
    Diagnosztikából tanult: HX711 DOUT a GPIO2-n van (INPUT_PULLUP=0 mutatta),
    GPIO1 az SCK. Fordított kiosztás (GPIO1=DOUT) a második gpioReport() nélkül
    megzavarta volna az SCK-t is.
    Mi működött (valós hw log, load cell bekötve):
    raw: 358271 / 358304 / 358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
    [hx711_exp.ino]
2026-06-08 feat(experiments): WiFi + OTA + Telnet + tara/kalibráció hozzáadva
    Mit: hx711_exp.ino teljes átírás, új fájlok: secrets.h.example, MEMORY.md update.
    Érintett modulok: hx711_exp sketch, NVS (Preferences), ArduinoOTA, WiFiServer (Telnet).
    Funkciók:
    - WiFi (WIFI_STA, auto-reconnect, 20s timeout)
    - OTA: ArduinoOTA, hostname=bee-scale-exp, jelszóvédett (secrets.h)
    - Telnet szerver (port 23): dual output Serial+Telnet, nem-blokkoló char-by-char input
    - HX711 tara: scale.tare(10), offset NVS-be mentve
    - Kalibráció: cal <kg> → scale_factor számítás + NVS mentés
    - Parancsok: tare | cal <kg> | factor <val> | raw | info | save | help
    Perzisztencia: Preferences (NVS) — offset +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
2026-06-08 feat(experiments): Telnet menü UI — streaming / menu mód váltás
    Mit: hx711_exp.ino — interaktív Telnet UI állapotgéppel.
    Érintett: hx711_exp.ino (sketch), nincs más változás.
    - STREAM mód: folyamatos "xx.xxx kg" output, bármely bil. → menübe lép
    - MENU mód: keretezett menü, egyérintéses parancsok (t/c/s/r/i/q)
    [t] tara (10 minta, NVS-be ment)
    [c] kalibráció — sub-prompt kg értékért, backspace támogatás, NVS mentés
    [s] azonnali egyedi mérés a menüből
    [r] raw + offset + tared + factor + kg kiírás
    [i] IP + RSSI + kalibráció info
    [q] vissza streaming módba
    - CAL_INPUT mód: char-by-char echo, backspace, Enter → doCal()
    - Álla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
2026-06-08 fix(experiments): q után ghost \r\n visszadobta streaming → menu módba
    Gyökérok: handleMenuKey('q') → tMode=STREAM, de a while loop
    következő iterációjában a 'q'+Enter miatti \r vagy \n olvasódott,
    ami STREAM módban menu-triggert okozott → sosem maradt STREAM-ben.
    Javítás: \r és \n ignore STREAM módban (continue).
    [hx711_exp.ino]
2026-06-08 feat(experiments): board-12 pinout — DOUT=GPIO1, SCK=GPIO2
    Board "12" (MAC …31:50) felflashozva.
    Pin csere: HX711_DOUT 2→1, HX711_SCK 1→2.
    Boot log: IP=192.168.1.111, RSSI=-59dBm, HX711 olvas, WiFi+OTA+Telnet OK.
    Tara/kalibráció még szükséges (NVS üres, factor=1.0).
2026-06-08 feat(experiments): board_21 + board_12 önálló kódbázisok, 64 mintás tara/cal
    Mit: experiments/board_21/board_21.ino + experiments/board_12/board_12.ino
    (+ secrets.h.example mindkettőhöz). hx711_exp/ megmarad legacy-ként.
    Különbségek a két kódbázis között:
    - board_21: HX711_DOUT=2, HX711_SCK=1, hostname=bee-scale-21
    - board_12: HX711_DOUT=1, HX711_SCK=2, hostname=bee-scale-12
    Közös változtatás: TARE_SAMPLES=64, CAL_SAMPLES=64 (~6.4 s @ 10 SPS),
    a korábbi 10 mintás átlag helyett. Menüben kiírja a várható időt is.
    Flash: mindkét board OTA-val felflashozva:
    - board_21 → 192.168.1.110 (bee_scale-21)
    - board_12 → 192.168.1.111 (bee_scale-12)
    Mindkettő fut, T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
2026-06-08 fix: wait_ready_timeout(400) → is_ready() — OTA broken pipe javítva
    Gyökérok: a blokkoló wait_ready_timeout(400ms) megakadályozta hogy
    ArduinoOTA.handle() időben lefusson → OTA sender timeout → broken pipe.
    is_ready() non-blokkoló: ha nincs kész minta, loop() azonnal visszatér,
    ArduinoOTA.handle() minden iterációban meghívódik.
    HX711 10 SPS-en, STREAM_MS=500ms → kihagyott minta nem okoz gondot.
    [board_12.ino, board_21.ino]
2026-06-08 feat(experiments): Firebase RTDB feltöltés board_21 + board_12 firmware-be
    - Beemeltem a bizonyított RTDB feltöltő modult (firmware/bee_scale_rtdb)
    mindkét éles boardba, a HX711+WiFi+OTA+Telnet funkciók megtartásával.
    Boardonként ÖNÁLLÓ feltöltés, nincs board-közi kommunikáció.
    - Új fájlok boardonként: rtdb_writer.{h,cpp} (auth + szinkron/await push +
    retry/backoff + 64-es FIFO ring buffer) és config.h.
    * Reading struct egyszerűsítve: { uint32_t ts; float w; } — boardonként
    EGYETLEN súlyérték (nem w_total/w1/w2).
    * tryPushFront() most { "ts": <szám>, "w": number_t(w,2) } JSON-t push-ol.
    * Az írási út config.h-ban, board-specifikus READIN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
2026-06-08 feat(firebase): rods/{w1,w2} RTDB rules élesítve + database deploy-target
    - firebase.json: hozzáadott "database" szekció (rules: firebase/database.rules.json),
    enélkül a `firebase deploy --only database` nem találja a szabályfájlt.
    - database.rules.json: eltávolítva a "//" JSON-kulcsos kommentek — az RTDB rules
    parser nem string-értékű kulcsokat vár ("Expected '{'" deploy-hiba), child-node-ként
    értelmezte őket. A szabály-logika változatlan (régi /readings + új /rods/$rod/readings).
    MIÉRT
    - A két board ÖNÁLLÓAN tölt fel a /hives/hive1/rods/w1 (board_21) és /w2 (board_12)
    ágba; a deploy nélkül a régi rules elutasította volna az írást a rods á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
2026-06-08 feat(web): dashboard a rods/{w1,w2} {ts,w} modellre — w_total párosítással
    - public/app.js adatréteg átírva: a régi egy-ágas /hives/hive1/readings
    {w_total,w1,w2} helyett MINDKÉT rúd-streamet olvassa:
    /hives/hive1/rods/w1/readings (board_21)
    /hives/hive1/rods/w2/readings (board_12)
    rekord-séma {ts, w}.
    - Két külön pont-Map (w1/w2), párhuzamos query (Promise.all), rúdankénti
    indexelt ts-query + startAt, két live onChildAdded listener.
    - w_total: legközelebbi-szomszéd párosítás kétmutatós merge-dzsel, ±180s
    toleranciával (a két board külön millis-fázisban mintáz → fix epoch-bin
    szétvágná a párokat; a nearest-neighbor robusztusabb)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
2026-06-08 fix(board_12): HW-csere — új ESP32-C3 + új HX711, pinout DOUT=2/SCK=1
    Mi: a board_12 (192.168.1.x) HX711 láncának hibakeresése és HW-csere
    utáni firmware-igazítás. Pinout: DOUT=GPIO1/SCK=GPIO2 → DOUT=GPIO2/SCK=GPIO1.
    Érintett: experiments/board_12/board_12.ino (HX711_DOUT/SCK + komment).
    Miért / tünet→gyökérok→megoldás:
    - Tünet: tara/kalibráció után is értelmetlen, random kg (±néhányszáz),
    raw ~-1000 körül véletlenül ugrált; tara sosem állt be (offset -653→-779→
    -710 minden 64-mintás átlagnál más) → nincs valódi differenciális jel.
    - Diagnózis: a HX711 KOMMUNIKÁLT (is_ready ok, 24-bit szót adott), de a
    raw nullához közeli zaj volt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
    [board_12.ino]
2026-06-08 feat(board_12): AHT20+BMP280 I2C env-szenzor + /hives/hive1/env RTDB ág
    - board_12-re fizikailag bekötve egy AHT20+BMP280 I2C szenzor: SDA=6, SCL=5
    (a HX711 a 2/1-en marad; az ESP32-C3 GPIO-mátrixa szabad lábkiosztást enged).
    - Hőm/pára/nyomás KAPTÁR-szintű (nem rúd-specifikus) adat → külön RTDB ág:
    /hives/hive1/env/readings: { ts, t, h, p } (°C, %RH, hPa).
    Ugyanaz az 5 perces ütem, FIFO és retry/backoff, mint a súlynál.
    HOGYAN (érintett fájlok)
    - config.h: ENV_READINGS_PATH "/hives/hive1/env/readings".
    - rtdb_writer.h: Reading struct bővítve RecType {REC_WEIGHT, REC_ENV} típussal +
    t/h/p mezőkkel. A két típus EGY közös FIFO-ban utazik, beérkezé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
2026-06-08 feat(board_12): [b] I2C busz-scan menüpont + HW-diagnózis: BMP280 nincs a buszon
    - Új [b] telnet-menüpont: végigpásztázza a 0x08..0x77 I2C címtartományt és
    kiírja az élő eszközöket (Wire.beginTransmission/endTransmission == 0).
    Diagnosztikai eszköz a BMP280=FAIL kivizsgálásához.
    - Az előző OTA után az env olvasás SIKERTELEN volt: AHT20=ok, BMP280=fail.
    Tisztázni kellett, hogy chip-ID gond (pl. BME280 0x60 a panelen), rossz cím,
    vagy fizikai hiány. A busz-scan ezt egyértelműen eldönti.
    MI MŰKÖDÖTT / MI NEM (élő teszt, OTA flash 192.168.1.116)
    - Fordítás OK (flash 95%, 1245775 B). OTA sikeres (a vég flaky: 'Unexpected
    response 736' wa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
    [board_12.ino]
2026-06-08 feat(board_12,firebase): env feltöltés nyomás nélkül — p opcionális (AHT20-only)
    - A BMP280 fizikailag nincs a buszon (lásd ef6be82), de a hőm+pára (AHT20)
    értékes. Ezért az env feltöltés mostantól nyomás (p) NÉLKÜL is felmegy:
    a p OPCIONÁLIS mező lett, a kötelező mag {ts,t,h}.
    HOGYAN
    - board_12.ino readEnv(): a feltétel ahtOk||bmpOk helyett CSAK ahtOk (AHT20 a
    kötelező mag). p = NAN alapból; ha a BMP280 él és érvényes, p = pa/100 (hPa).
    Vagyis ha a BMP280 később bekerül, a p magától visszajön — kódváltás nélkül.
    - rtdb_writer.cpp tryPushFront() REC_ENV ág: ha isnan(r.p) → {ts,t,h} (3 mező),
    különben {ts,t,h,p} (4 mező). NaN-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
2026-06-08 feat(web): env (hőm/pára) megjelenítés — fejléc-chip + külön env-chart
    - A dashboard mostantól olvassa és megjeleníti a /hives/hive1/env/readings ágat
    ({ts,t,h[,p]}), a board_12-re kötött AHT20[+BMP280] adatát.
    - Fejléc-chip (kék, a kg-érték mellett): aktuális t/h (+ p ha van) + időbélyeg.
    - Külön "Hőmérséklet / páratartalom" Chart.js panel a súly-chart alatt: t a bal
    (°C), h a jobb (%RH) Y-tengelyen — a kg-skálát nem zsúfolja.
    - index.html: topbar-meta wrapper (env-chip + súly-latest); env-chart canvas +
    section-title + env-empty-state.
    - style.css: .topbar-meta (margin-left:auto a régi .latest helyett), .env-chip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
2026-06-08 fix(web): no-cache Cache-Control header a Hostingra — friss deploy azonnal látszik
    TÜNET
    - A felhasználó böngészőjében a frissített dashboard (env hőm/pára) "nem jelent
    meg", miközben a friss app.js/index.html bizonyítottan kint volt élesben.
    GYÖKÉROK
    - A firebase.json semmilyen Cache-Control-t nem állított → a böngésző heurisztikusan
    cache-elte a korábbi (env nélküli) app.js-t, és a régit szolgálta ki.
    BIZONYÍTÉK (headless Playwright/chromium, friss cache nélküli session, élő URL)
    - súly-chip: -0.40 kg (w1+w2); env-chip: 31.2 °C · 30 %; env-empty-state: rejtve.
    - console hibák: NINCS. Screenshot: mindkét chart renderel — a súly reális ská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
2026-06-08 feat(board_21): DS18B20 OneWire kaptár-hőmérő (GPIO4) + /hives/hive1/temp ág
    Mit: a board_21-re kötött DS18B20 OneWire hőmérő (DQ=GPIO4) integrálása a
    firmware-be, a board_12 env-mintázatát követve. A kaptár belső hőmérséklete
    KAPTÁR-szintű adat → külön RTDB ágra megy, nem a rúd-súly ágba.
    Változások:
    - config.h: TEMP_READINGS_PATH = /hives/hive1/temp/readings (új ág).
    - rtdb_writer.h: RecType enum {REC_WEIGHT, REC_TEMP} + Reading bővítve type+t
    mezővel (a board_12 REC_WEIGHT/REC_ENV megoldásának tükre). Egy közös FIFO,
    típus szerint dől el a célútvonal és a JSON-payload.
    - rtdb_writer.cpp: tryPushFront() típus-szerinti elágazás — REC_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
2026-06-08 feat(firebase,web): kaptár-hőm (/hives/hive1/temp) Rules + dashboard-megjelenítés
    Mit: a board_21 DS18B20 új /hives/hive1/temp/readings ágához backend-szabály
    és frontend-megjelenítés. (A firmware-oldal külön commitban: f37ffba.)
    Security Rules (firebase/database.rules.json):
    - Új "temp" ág az "env" mintájára: olvasás auth != null, írás csak a
    esp32@beescale.local device-user. .indexOn ["ts"]. Validáció: {ts,t}
    kötelező (ts > 1700000000 epoch-guard), minden más gyerek tiltva ($other).
    Dashboard (public/app.js):
    - TEMP_PATH konstans + tempPoints Map + tempLiveQuery.
    - Az env-chart kap egy 3. dataset-et ("Kaptár-hőm (szonda, °C)", piros) a bal
    (°C) tengelye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
2026-06-08 feat(board_21): DS18B20 GPIO4→GPIO3 + [w] 1-wire busz-diagnosztika
    Mit:
    - ONEWIRE_PIN 4 → 3 (a szenzor fizikailag a GPIO3-on van, nem a 4-en).
    - Új [w] menüpont: teljes 1-Wire busz-diagnosztika reboot nélküli újra-
    detektálással (frissíti a dsOk-t is, így huzalozás-javítás után azonnal
    visszajelez, OTA/reboot nélkül). Lépései:
    0) idle-vonalszint: INPUT (lebegő) és INPUT_PULLUP (belső ~45k) olvasás —
    megkülönbözteti a "vonal szabad / hiányzó külső felhúzó" (pullup=1) és a
    "GND-re húzva / rövidzár / parazita-terhelés" (pullup=0) hibamódot.
    1) reset/presence pulzus (oneWire.reset()).
    2) ROM-search: family-kód + CRC eszköz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
    [board_21.ino]
2026-06-11 docs(memory): hiányzó projekt-memóriafájlok pótlása (boards + wifi)
    Mit: a MEMORY.md két nem létező fájlra hivatkozott — most létrehozva.
    - project_boards.md: board_21 (w1, DS18B20 GPIO3) és board_12 (w2, AHT20 I2C
    6/5) MAC, pinout, RTDB-ágak, HW-történet. Rögzíti, hogy a "21"/"12" név a
    HX711 EREDETI DOUT/SCK sorrendjéből ered, de a board_12 HW-cseréje (2026-06-08)
    óta MINDKÉT board DOUT=2/SCK=1 — a "12" név csak történeti azonosító.
    - project_wifi_test.md: AMS-TP-2.4GHz teszt-háló (SSID, sáv, jelleg). Titok
    NÉLKÜL — a credentialök a gitignore-olt secrets.h-ban; itt csak a struktúra.
    Miért: a MEMORY.md 8. szakasza lógó linkekre mutatott;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
2026-06-11 docs(wifi): telephelyi háló TP-Link_4448-ra állítva (secrets.h)
    Mit: mindkét board secrets.h-jában WIFI_SSID/WIFI_PASSWORD átírva a telephelyi
    TP-Link_4448 (2.4 GHz) hálózatra. A project_wifi_test.md megjegyzése frissítve:
    a teszt-háló (AMS-TP-2.4GHz) már csak historikus referencia.
    Miért: kitelepítés előtti fő nyitott pont volt a helyszíni WiFi (MEMORY 5/#... +
    kitelepítési checklist). A telephelyi háló és jelszó megvan.
    Mi nem: a secrets.h gitignore-olt → a tényleges credential NEM kerül a repóba
    (ellenőrizve: git check-ignore mindkét fájlra illeszkedik, status tiszta).
    Nyitott: a credential fordítási idejű → mindkét boardot ÚJRA KELL FLASHELNI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
2026-06-22 feat(enclosure): parametrikus vízálló ház build123d-vel + ocp-vscode élő nézet
    MIT:
    - wireless_scaling/enclosure.py: parametrikus, ~IP65 kültéri ház a méhkaptár-mérleg
    node-hoz (ESP32-C3 SuperMini + HX711 + DS18B20 + 18650). build123d 0.11.0 algebra API.
    3 nyomtatandó alkatrész: housing, bottom_lid, battery_door. Minden méret a fájl tetején,
    kommentált modul-szintű változó. Futáskor STL + STEP export (export/) + assembly.step.
    - watch.py: mentésre újrafuttatja a modellt (subprocess, hibatűrő) → ocp-vscode viewer frissül.
    - requirements.txt, README.md (VS Code/ocp-vscode setup lépések), .gitignore (.venv, export, __pycache__).
    ARCHITEKTÚRA-DÖNTÉSEK (k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
2026-06-22 feat(enclosure): valós alkatrész-méretek átvezetése (PCB szorítóbordák, 18650 holder, DS18B20)
    MIT: web-kutatással (5 párhuzamos ágens, forrásolt) megszerzett fizikai paramétereket
    vezettem át az enclosure.py-ba, a felhasználói döntések szerint.
    VÁLTOZÁSOK:
    - PCB-rögzítés ÚJRAGONDOLVA: a korábbi heat-set standoff-koncepció helyett SZORÍTÓBORDÁS,
    csavar nélküli fészkek (pcb_nests). Ok: a SuperMini és a TP4056 furat NÉLKÜLI panel, a
    HX711 sarokfurat-osztása klón-/gyártófüggő és bizonytalan → mindhárom panelt becsúsztatós
    sarok-oszlopok (oldalfogás) + sarok-padok (forrasztás-hézag) közé fogjuk.
    Valós befoglalók: HX711 34x21, ESP32-C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
2026-06-22 docs(enclosure): node-koncepció tisztázás + teljes alkatrész-spec + HANDOFF doksi
    - HANDOFF.md: átfogó tervezési státusz + átadási dokumentum a wireless_scaling node-házhoz.
    Tartalom: tisztázott node-koncepció, forrásolt alkatrész-specifikációk (mind a 6 kutatás),
    mérőcella szerelési elv, jelenlegi modell-állapot, döntések, nyitott pontok, következő lépések.
    - datasheets/cell_SC902/: a négyzetes fél-hidas mérőcella datasheet-rajzai (plan/side/mech),
    a scratchpadből a repóba mentve (furat-középvonal + offset szerelés referenciája).
    TISZTÁZOTT KONCEPCIÓ (felhasználói input, 2026-06-22):
    - 1 node = 1 önálló egység (1 négyzetes fél-hida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
2026-06-22 feat(enclosure): 1-node dobozméret + besüllyesztett mérőcella + 3-furatos furatkép
    - Dobozméret újrahangolva 1-node-ra: inner_x=60 (rövid, X), inner_y=80 (hosszú, Y),
    inner_z=45. Koordináta-konvenció kommentben rögzítve: a 18650 holder (74.5) ∥ Y a
    hosszú él mentén; a két HOSSZÚ fal (±X) hordozza majd az akku-ajtót (+X) és az USB-C-t (−X).
    - Tető: a régi MEGEMELT pad + 2×2 single-point furatkép HELYETT BESÜLLYESZTETT cella-pocket
    (cell_size_xy=34, cell_recess_d=2.5 a perem vastagsága) + 3 furat egy középvonalon (X mentén):
    1 nagy KÖZÉP terhelő (átmenő, a dóm/terhelt vég szabad hajlásterének) + 2 kis FIX (M4 heat-set),
    a fix furatokhoz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
2026-06-22 feat(enclosure): süllyesztett (flush) akku-ajtó a +X hosszú falon
    - A két HOSSZÚ fal (±X) külön vastagsága: long_wall_th=5.0 (a rövid ±Y falak maradnak wall=3).
    A doboz KIFELÉ nő X-ben (outer_x = inner_x+2*long_wall_th = 70), a belső holder-strip
    VÁLTOZATLAN (a 2.5 mm X-tartalék megmarad). Frissítve: outer_x, groove_half_x.
    - Akku-ajtó overlap→SÜLLYESZTETT (flush): a +X külső falba rebate-pocket (bat_recess_d=door_th=3
    mély) → az ajtó síkban ül a fallal; a rebate-fenéktől átmenő nyílás a kavitásba; 4 sarok-boss
    + heat-set betét a rebate-fenéktől befelé.
    - Nyílás: bat_open_y 50→68 (> 18650 cella 65, hogy kivehető legyen), bat_open_z 24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
2026-06-22 feat(enclosure): süllyesztett USB-C ×2 a −X falon + fejléc-dok frissítés
    - 2 KÜLÖN süllyesztett USB-C port a −X HOSSZÚ falon (TP4056 töltés + SuperMini firmware/töltés).
    Portonként: (1) rebate-pocket a −X külső faltól befelé (usb_recess_d=2) a vízálló dugónak/
    sapkának (flush); (2) átmenő nyílás a rebate-fenéktől a kavitásba a csatlakozóhoz.
    - Új paraméterek (mind a fájl tetején, PLACEHOLDER-rel jelölve): usb_open_w/h, usb_recess_w/h/d,
    usb_ports lista (y,z pozíciók a SuperMini/TP4056 fészkek felé igazítva, y=±26).
    - A dugó maga off-the-shelf szilikon bung / kis nyomtatott sapka → geometriát nem modellezünk
    hozzá (kommentben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
2026-06-22 feat(enclosure): USB-C nyílás a connector VALÓS stadion-profiljához igazítva
    - Új stadium_x(depth,width,height) helper: STADION (obround) keresztmetszet a Y–Z síkban,
    X mentén extrudálva — két teljes körív-vég (sugár=height/2) + középső egyenes. Ez az USB-C
    connector valódi profilja (nem a korábbi durva négyszög).
    - Az USB-portok átmenő nyílása + recess-pocketje a négyszög helyett STADION-alakú lett.
    - A nyílás mérete az USB-IF Type-C spec R2.0 (2019) plug-kótáihoz igazítva:
    plug fém héj ~8.4 SZÉLES × 2.56 MAGAS, lekerekített végek (sugár ≈ 1.28).
    → usb_open_w=9.0 (8.4 + ~0.3/oldal), usb_open_h=3.0 (2.56 + hézag), végsugár h/2=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
2026-06-22 feat(enclosure): PCB-fészkek a bottom_lid-ről a housing-ba (tető alá lógatva) + boardok beljebb
    - A szorítóbordás PCB-fészkek (sarok-oszlop + támasztópad) átkerültek a build_bottom_lid-ből a
    build_housing-ba: a panelok a TETŐ PLATÓ ALÁ lógatva ülnek (a lid csak zár). A bottom_lid
    ezzel SÍK záró lap lett (csak a 4 sarok csavarfurattal), vastagsága/bbox 11→3 mm.
    - A fészkek Z-szintje úgy hangolva, hogy NE ütközzön a tető alatti elemekkel:
    board felső lapja pcb_seat_z=32 → a board ~z[26..32] sávban van, ami a merevítő BORDÁK
    (z=33..45) és a CELLA-FIX-BOSSOK (z≈38.5..49.5) ALÁ, a fő-fedél SAROK-BOSSOK (z≤22) FÖLÉ esik.
    Új paraméte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
2026-06-22 feat(enclosure): cella-furatok a süllyesztésen kívülre + gland-lyukak törlése
    MIT (mind user kérés):
    - A cella POCKET alól eltávolítva a 3 furat: a nagy KÖZÉP terhelő furat + a 2 kis FIX furat
    + a hozzájuk tartozó lefelé lógó bossok. A pocket FENEKE most TÖMÖR → felülről teljesen vízálló.
    - Helyettük 2 db M4 heat-set rögzítőfurat a süllyesztésen KÍVÜL, a HOSSZÚ (Y) középvonalon (x=0),
    a recess pereme mellett cell_screw_clearance=3 mm-re (furat-közép y=±23.25). FELÜLRŐL BLIND
    (a lefelé lógó boss tömör anyagba zárja a furat fenekét → vízálló marad). Ide egy áthidaló
    leszorító bracket csavarozható, ami a cellát a pocketben ta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
2026-06-22 fix(enclosure): PCB-boardok középre húzva (Y-ban a HX711 köré, szoros réssel)
    - SuperMini és TP4056 Y-pozíciója ±28 → ±21, szorosan a középen lévő HX711 fölé/alá
    (~1.5 mm rés). Az USB-portok y-ja utánuk igazítva (±28 → ±21).
    MIÉRT:
    - User: "a boardok még mindig a szélén vannak, tedd középre őket (ne érjenek egybe)."
    A korábbi ±28 fölöslegesen nagy (8.5 mm) hézagokat hagyott a Y-szélek felé. Behúzva a stack
    most ±30 mm-en belül van (a 3 board össz-magassága 21+18+17.3 ≈ 56 mm ezt fizikailag adja).
    - X-ben már középen vannak: a +X felet az akku foglalja (strip x>6), így az elektronika a
    x[−30,6] sávba esik (közép ~−12),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
2026-06-22 feat(enclosure): teljes magasság minimalizálva (inner_z 45→36, kívül 52→43)
    - inner_z 45 → 36 (külső magasság housing_h 52 → 43, −9 mm).
    - Függő magasság-paraméterek a minimumra húzva:
    * boss_h (alsó-fedél sarok-boss) 22 → 14 (= M5 insert_depth 9 + tartalék).
    * bat_open_z 22 → 20 (18650 Ø18.5 + 1.5 kivételi hézag).
    * pcb_seat_z 32 → 22 (a tető alá lógatott boardok a bordák z=24 / cella-boss z=25 ALATT).
    * usb_ports z 29 → 19 (az új, lejjebb lévő board-szinten).
    MIÉRT / A KÖTŐ KORLÁT (ezért nem lehet még alacsonyabb az OLDALAJTÓVAL):
    - A legmagasabb fix alkatrész a 18650 holder = 17.7 mm, de NEM ez a korlát.
    - Az oldalsó AKKU-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
2026-06-22 refactor(enclosure): falak a spec-minimumra vékonyítva + merevítő bordák eltávolítva
    KONTEXTUS: a user végzi a statikai tervezést → a házból minden TISZTÁN-MEREVÍTŐ (nem
    funkcionális) tömeg eltávolítva, a falak a spec-feature minimumára húzva, a funkcionális
    geometria (tömítés, rebate, pocket, bossok, portok, fészkek, válaszfal) SÉRTETLEN.
    - MEREVÍTŐ BORDÁK ELTÁVOLÍTVA: rib_x_positions / rib_y_positions → üres lista (a build_housing
    rib-ciklusai nem adnak hozzá semmit). Tisztán merevítő, nem spec → kivéve.
    - top_th 7 → 3.5 (a cella-pocket 2.5 + ~1 fenék minimuma). A fölös load-merevítő vastagság kivéve.
    - long_wall_th 5 → 4 (az a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
2026-06-22 feat(enclosure): akku-ajtó csavarozás kivéve — marad a sima süllyesztett fedő
    MIT (user kérés):
    - Eltávolítva az akku-ajtó CSAVAR-rendszere:
    * a házból a 4 sarok-boss + heat-set betétfurat (a +X rebate mögül),
    * az ajtóból (battery_door) a 4 sarok csavar-clearance furat.
    - MEGMARAD: a süllyesztett rebate-pocket + az átmenő nyílás a házon, és a sima fedőlap +
    a tömítőhorony az ajtóban ("csak a fedő maradjon, a hátlap mint eddig").
    - bat_boss_inset így használaton kívül (a geometriából kikerült).
    MI MŰKÖDÖTT (validate.py + python enclosure.py):
    - Mindhárom part 1 összefüggő solid; külméret változatlan (68×86×39.5); export lefut.
    NYITO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
2026-06-22 feat(layout): alkatrész-pakolás vizualizáció (layout.py) a dobozon belül
    - Új layout.py: az enclosure.py build-függvényeit újrahasználva betölti a HÁZAT (átlátszón),
    az alsó fedelet, az akku-ajtót, ÉS az alkatrész-maketteket színes blokként az ocp-vscode
    viewerbe (port 3939, headless is fut).
    - Alkatrész-makettek valós befoglaló méretekkel (HANDOFF/MEMORY spec):
    HX711 34×21, SuperMini 24×18, TP4056 29×17.3, DS18B20 TO-92 4.6×4.6×3.9, 18650 holder
    21.5×74.5×17.7, 18650 cella Ø18.5×65, mérőcella 34×34×7.8.
    - A pozíciók a COMPONENTS táblában PAKOLHATÓK (pos/axis); a defaultok a jelenlegi enclosure-
    elrendezéshez igazítva (panelok a tet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
2026-06-22 fix(layout): panelok az alaplap-vastagsággal (PCB_TH=1.6) a komponens-burok helyett
    - Bevezetve PCB_TH=1.6 (FR4 alaplap). Mindhárom panel (HX711, SuperMini, TP4056) magassága
    a korábbi becsült komponens-burok (12/6/5) helyett a PCB-vastagság 1.6.
    - A panelok a FELSŐ lapjukkal SEAT_Z=22-n maradnak → z[20.4, 22.0].
    - User: "a HX711 nem ilyen vastag, számoljunk mindegyik boardnál az alaplap-vastagsággal."
    MEGJEGYZÉS:
    - A komponensek (header, USB-C, HX711 sorkapocs) kilógása NINCS modellezve — ha a pakolásnál
    számolni kell vele, panelenként külön hozzáadható.
    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
2026-06-22 fix(layout): 18650 holder a TETŐ ALÁ lógatva (le a bottom_lid-ről) — kikerüli a sarok-csavarokat
    - A 18650 holder + cella mockja átkerült a bottom_lid-ről (z[0,17.7]) a TETŐ ALÁ lógatva:
    felső lapja az inner_z-n → z[18.3, 36]. Így a sarok-csavar-bossok (z[0,14]) FÖLÖTT van.
    - STRIP_CX a válaszfal UTÁNI hasznos strip-középre igazítva (partition_th figyelembevételével)
    → holder x[8.0, 29.5], elválik a válaszfaltól (x≤7.5) és a +X faltól (x=30).
    - Komment: a holder NYITOTT/behelyező oldala a +X akku-ajtó felé (kifelé) néz.
    - A +X stripben az alján a holder (74.5 ∥ Y) ütközött a sarok-lid-csavar-bossokkal (y=±31),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
2026-06-22 fix: valós panel-méretek — TP4056 18×14, SuperMini 24×18.4 (user-mért)
    - TP4056: 29×17.3 → 18×14; ESP32-C3 SuperMini: 24×18 → 24×18.4 (user lemérte).
    - Frissítve mindkét helyen: layout.py COMPONENTS (makettek) + enclosure.py pcb_nests
    (a szorítóbordás fészkek mérete → a klampek a valós panelre passzolnak).
    MI MŰKÖDÖTT (validate.py + layout.py):
    - Mindhárom part 1 solid; külméret változatlan; komponens-átfedés nincs.
    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
2026-06-22 feat(layout): HX711 élére forgatva (vertikális, slotba) + a másik 2 board beljebb
    MIT (user, packing):
    - HX711 a hosszanti (X) tengelye körül 90°-kal elforgatva → ÁLLÓ panel (34 X × 1.6 Y × 21 Z),
    z[6, 27]: alatta 6 mm hézag (NEM ér le az aljáig), egy kis slotba csúszna.
    - SuperMini y 21 → 11, TP4056 y −21 → −9 (beljebb húzva; a HX711 most vékony Y-ban, így van hely).
    MI MŰKÖDÖTT (layout.py):
    - Nincs komponens-átfedés. HX711 (y≈0, vékony) és a két flat panel (y=11 / −9) elválik.
    NYITOTT (enclosure.py-ba átvezetendő, ha a pakolás végleges):
    - A HX711-hez a házban SLOT (vezető-horony / sín-pár) kell a mostani szorítóbordás fészek helyett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
2026-06-22 feat(layout): USB-C connectorok a panelokra + nagyobb hézag a HX711-től
    MIT (user):
    - SuperMini y 11→13, TP4056 y −9→−11 → ~3 mm hézag a vertikális HX711-től mindkét oldalon
    (előbb csak ~1 mm volt).
    - USB-C connector makett (7×9×3.2) hozzáadva mindkét panel −X éléhez, a −X fal felé kilógva
    (z[17.2,20.4], a panel alatt) → látszik, merre néz és hova kell a fali port.
    MI MŰKÖDÖTT (layout.py): nincs komponens-átfedés; a HX711–panel hézag ~3 mm.
    NYITOTT: az enclosure.py usb_ports (most y=±21, z=29) a connectorokhoz resyncelendő
    (y=+13 / −11, z≈18.8) a házba átvezetéskor.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
2026-06-22 fix(enclosure): USB-C fali LYUKAK a connectorok alá igazítva (y=−11/+13, z=18.8)
    - usb_ports átrakva a régi (y=±21, z=29) helyről a tényleges USB-C connector-pozíciókhoz:
    TP4056 y=−11, SuperMini y=+13, mindkettő z≈18.8 (a layout.py board/connector elrendezése).
    - A connector-maketteket a layoutban már áthelyeztem, de a HÁZ stadion-nyílásai a régi helyen
    maradtak → a lyuk nem a connector előtt volt. Most igazodnak.
    MI MŰKÖDÖTT: a −X falban mindkét port-helyen van nyílás (ellenőrizve); mindhárom part 1 solid;
    layout átfedés-mentes.
    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
2026-06-22 docs(handoff): HANDOFF.md felülírva a FRISS állapottal
    - A HANDOFF.md (eddig a session előtti, elavult állapotot írta: 100×80×55, single-point cella,
    2×2 furatkép, PG7 gland, PCB a bottom_lid-en) teljesen átírva a mostani állapotra:
    60×80×36 külső 68×86×39.5; vékonyított falak (spec-minimum) + bordák kivéve; besüllyesztett
    cella tömör fenékkel + külső M4 rögzítés; csavar nélküli süllyesztett akku-fedő; stadion USB-C
    nyílások az új pozíción; PCB-k a tető alá lógatva; layout.py pakoló-eszköz.
    - Kiemelve a fő nyitott munka: enclosure.py ↔ layout.py eltérés (HX711 vertikális slot,
    SuperMini/TP4056 y=+13/−11, holder-clamp a tet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
2026-06-22 feat(enclosure): cella-pocket sekélyebb (recess 2.5→1.0) + PCB-tartók kivéve
    Két user-döntés ebben a commitban (mindkettő az enclosure.py-t érinti):
    1) CELLA-POCKET — cell_recess_d 2.5 → 1.0 mm.
    MIÉRT: a SC902 cella csak ~1 mm-re süllyedjen a tető plató pocketjébe. Mellékhatás:
    a TÖMÖR FENÉK 3.5−1.0=2.5 mm-re vastagszik (eddig 1.0 mm) → erősebb teherbevivő fenék.
    HATÁS: load_cell makett z[37.0,44.8] → z[38.5,46.3] (magasabb pocket-fenéken ül).
    2) PCB-TARTÓK ELTÁVOLÍTVA a build_housing-ból (szorítóoszlopok + támasztópadok).
    MIÉRT: user minden komponenst EGY közös alaplapra forraszt, a board-tartást ő oldja meg.
    A régi tartók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
2026-06-22 feat(enclosure): sarokcsavar M5 sárgaréz heat-set → M2.5 önmetsző MŰANYAG, betét nélkül
    MIT: a fő (alsó) fedél 4 sarok-rögzítése átállítva. M5 sárgaréz heat-set betét + fém
    csavar HELYETT M2.5 önmetsző MŰANYAG (nylon) csavar, heat-set betét NÉLKÜL.
    - heat-set betét ELHAGYVA → a bossba ÖNMETSZŐ PILOT furat megy (nem betétfurat)
    - insert_dia 6.4 / insert_depth 9.0 → pilot_dia 2.1 / pilot_depth 6.0
    - screw_clear_dia 5.5 → 2.9 (M2.5 átmenő a fedélben)
    - boss_dia 11.6 → ~5.8 (pilot+2×1.85 fal) ; boss_h 14.0 → 7.0 (mind ~FELE)
    - új: screw_nom_dia=2.5 (M2.5 névleges)
    MIÉRT (user): fele átmérőjű/hosszúságú MŰANYAG csavar. A nylo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
2026-06-22 fix(enclosure): tömítőhorony szélesség 2.5→2.0 — egységesen ~2 mm körbe (ajtó + fő zárás)
    MIT: gasket_groove_w 2.5 → 2.0. A tömítőhorony így 2.0 (szél) × 2.0 (mély), egységes
    ≤2 mm körbe — a battery_door hornyán ÉS a fő (alsó) ZÁRÁS körbefutó hornyán is (közös param).
    MIÉRT (user): az akku-ajtó tömítőhornya túl nagynak tűnt; "mindenhol ~2 mm max, egységesen".
    ELLENŐRIZVE: a door horony a modellben MÁR egyenletes volt (2.5 körbe, szimmetrikus, perem→
    horony táv 1.45 mm felül=alul=oldalt — számszerűen igazolva) → a "felső szakasz magasabb"
    benyomás render-perspektíva, nem geometria. A valós túlméret a 2.5 szélesség volt →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
2026-06-22 fix(enclosure): sarok-boss gusset csak a ±Y falhoz — nem lóg az akku-ajtó rebate-be
    TÜNET (user, képpel): a +X fő-fedél sarok-csavar boss GUSSETJE belógott az akku-ajtó
    rebate terébe / az ajtó tömítőhornyának síkjába.
    GYÖKÉROK: a gusset eddig MINDKÉT belső falig nyúlt (X és Y), boss_dia/2 ráhagyással
    (L-blokk). A +X (hosszú) falban viszont az akku-ajtó REBATE van (bat_recess_d=3 mély),
    így a fal a rebate mögött csak ~1 mm tömör → a gusset X-ága átlógott a rebate-be (a régi
    +X gusset max X≈31.45 > rebate-határ 31). A −X falban USB recess van (ugyanaz a kockázat).
    MEGOLDÁS: a gusset CSAK a ±Y (rövid) fal felé nyúlik, a boss szélességében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
2026-06-22 feat(enclosure): sarok-bossok kivíve a szélre — boss széle 2 mm a falsíktól (corner_inset 9→4.9)
    MIT: corner_inset 9.0 → boss_dia/2 + 2.0 (=4.9). A 4 fő-fedél sarok-boss közelebb a sarokhoz:
    közép (±25.1, ±35.1), boss SZÉLE 2 mm-re a belső falsíktól mindkét irányban. Több szabad
    belső tér középen (a user közös alaplapjának).
    MIÉRT (user): "kijjebb viheted majdnem egészen a szélére (2mm elég)".
    MI MŰKÖDÖTT (számszerű ellenőrzés): boss széle X=±28 / Y=±38 → falsíktól 2.00 mm hézag;
    a TÖMÍTŐHORONY belső élétől X=3.00 mm, Y=2.50 mm → a boss/gusset NEM éri a hornyot (IP65
    a z=0 peremen sértetlen). Bónusz: a +X boss y=±35.1 most az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
2026-06-22 feat: magasság 39.5→33.5 (−6mm) — akku-rekesz a bossok fölé, ajtó a sávhoz igazítva, 1mm karima
    MIT (user kérés): a doboz ~6 mm-rel alacsonyabb. Az akku-rekesz (18650 holder+cella) a sarok-
    bossok TETEJE fölé ült, az akku-ajtó/nyílás EHHEZ a felső sávhoz igazodik (nem a doboz közepéhez),
    a karima 1 mm-re csökkent.
    VÁLTOZÁSOK (enclosure.py):
    - inner_z 36 → 30 (ház 39.5 → 33.5).
    - új: holder_gap=2.0 (boss teteje → akku-rekesz alja hézag), batt_z0=boss_h+holder_gap=9.
    - bat_open_z 20 → 19.5 (18650 Ø18.5 + 1 hézag, oldalra húzás; holder 17.7 is átfér).
    - bat_open_y 68 → 76 (a HOLDER hossza 74.5 is bedugható az ajtón, nem csak a cella).
    -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
2026-06-22 feat(enclosure): akku-ajtó LE majdnem az aljáig — ajtó alja z=5.3 ("fél centi" perem)
    TÜNET (user): az akku-ajtó nem ért le, alatta ~7-8 mm tömör fal maradt (ajtó alja z≈7.8).
    MIT: a nyílás aljat leengedtem, hogy az AJTÓ alja ~5 mm-re ("fél centi") legyen a doboz aljától,
    csak annyi perem maradjon alul, amennyi az alsó körbefutó tömítőhoronynak (z[0,2]) kell.
    - új: bat_floor_margin=5.0 (ajtó alja a doboz aljától) → bat_open_z0 = margin+karima = 6.0.
    - bat_open_z 19.5 → 22.0 (a nyílás teteje változatlanul a 18650 tetejét fedi, z=28; csak az
    alja ment lejjebb). bat_cz 18.25 → 17.0.
    MIÉRT MEHET LE: a sarok-bossok (z[0,7]) X-ben BELJEBB vannak (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
2026-06-22 feat(enclosure): válaszfal 2mm hátrébb + 1mm vastagabb; load-cell csavar = alsó (M2.5 műanyag)
    KÉT user-kérés:
    1) AKKU-REKESZ HÁTFALA (válaszfal): 2 mm-rel hátrébb + 1 mm-rel vastagabb.
    - bat_w 24 → 26 (a válaszfal belső lapja x=6 → x=4, azaz 2 mm −X = nagyobb rekesz).
    - partition_th 1.5 → 2.5.
    - Eredmény: a rekesz hasznos szélessége a vastagabb fal mellett is 23.5 mm (volt 22.5) →
    a 18650 holder (21.5) kényelmesen befér; az elektronika-tér x<4-re szűkült (user az alaplapon).
    2) LOAD-CELL rögzítőcsavarok = "olyan mint az alján": M2.5 ÖNMETSZŐ MŰANYAG, pilot furat,
    heat-set betét NÉLKÜL (eddig M4 sárgaréz heat-set volt a tetőn).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
2026-06-22 feat: akku-ajtó TÖRÖLVE (alulról szervizelhető) + 8 fedél-csavar (4 sarok L-gusset + 4 oldal-közép)
    USER-DÖNTÉS: "hagyjuk a battery doort, úgyse cseréljük sűrűn; csak az alján lesz nyílás".
    1) AKKU-AJTÓ TELJESEN ELTÁVOLÍTVA:
    - build_battery_door() + a build_housing rebate/nyílás szekció törölve → a +X HOSSZÚ FAL TÖMÖR
    (vízálló). A 18650-hez ALULRÓL (bottom_lid levételével) férsz hozzá; az alja amúgy is nyitott.
    - bat_open_*/bat_door_overlap/bat_floor_margin/door_th/bat_recess_d/bat_boss_inset/bat_cz törölve.
    MARADT: bat_w, partition_th, bat_cable_dia (válaszfal+rekesz), holder_gap, batt_z0.
    - main/layout/validate: már csak 2 par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
2026-06-22 feat(enclosure): cella-támasztás (karima + dent a lehajláshoz) + válaszfal kivéve
    USER: a fél-hidas mérőcella terhelés alatt LEHAJLIK — a SZÉLE megtámasztva, a KÖZEPE szabadon
    hajlik le. Ehhez karima (megvastagított talp) + középső dent (üreg) kell. Plusz a válaszfal ki.
    1) KARIMA a cella-pocket alá (+5 mm körbe, 3 mm-rel lejjebb):
    - új param: cell_flange_margin=5, cell_flange_drop=3.
    - a pocket alatti fenék 34.8→44.8 négyzetre szélesítve ÉS a fenék alja inner_z(30)→27-re
    lelógatva a kavitásba → a cella alatti teherviselő talp 2.5 → 5.5 mm vastag.
    2) DENT a cella KÖZEPE alá (a lehajláshoz):
    - új param: cell_dent_margin=3 (a pocketn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
2026-06-22 feat(enclosure): cella-karima −1mm + Y-alakú támasztó OSZLOP a hosszanti középvonalon
    USER kérések a cella-platformhoz:
    1) KARIMA −1 mm: cell_flange_margin 5 → 4 ("majdnem túl sok, vegyél vissza 1mm-t"). A
    megvastagított talp most 42.8×42.8 (volt 44.8).
    2) CELLA-TÁMASZTÓ OSZLOP a hosszanti (Y) középvonalon (x=0):
    - Y-ban a platform teljes hosszán fut (42.8), a 2 cella-fix csavar (y=±21.4) köti a végeit.
    - Lefelé "Y" FORMÁBA szélesedik: SZÁR cell_col_w_top=8 mm (X) felül (z[14,29.5]), lefelé
    a TALP cell_col_w_base=12 mm-re szélesedik (z[0,14]). (Plane.XZ Polygon + extrude.)
    - Z: a platform aljától (a dent feneke, z=29.5) a doboz aljáig (z=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
2026-06-22 fix(enclosure): cella-támasztó oszlop ÁLLÓ Y-ra fordítva (a két ág FELÜL, egyesül alul)
    TÜNET (user): az előző oszlop FORDÍTVA volt — felül keskeny szár, lefelé szélesedő talp (fordított
    Y / V). A user ÁLLÓ Y-t kért: "fentről indul a két ág a load cell ágyától, és lefelé az alján
    csatlakozik".
    JAVÍTÁS: a Plane.XZ Polygon profil áttervezve igazi ÁLLÓ "Y"-ra:
    - a két ÁG FELÜL, a load-cell ágy (pocket) két szélén indul (x=±arm_out=±17.4, z=col_top=29.5),
    ág-vastagság cell_col_w_top=8 mm (arm_in=9.4);
    - lefelé a két ág a V-CSÚCSBAN egyesül (cell_col_junction_z=14, x=0);
    - onnan közös SZÁR/TALP a doboz aljáig (z=0), szélesség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
2026-06-22 revert(enclosure): cella-támasztó oszlop TÖRÖLVE (rossz orientáció — másik agent építi újra)
    A user szerint az oszlop orientációja rossz volt (az "Y" 90°-kal elforgatva kellene: a két ág a
    HOSSZANTI/Y irányban szétnyílva, X-ben vékonyan a középvonalon — különben az ágak (x±17.4) az
    akku-holderbe (x≥7.5) érnek, "el se fér"). A user másik agenttel építteti újra.
    TÖRÖLVE: a build_housing 3) oszlop-szekciója, a cell_col_* paraméterek, a Polygon/extrude/Plane
    import. MARADT (a user nem kifogásolta): cella-pocket, KARIMA (margin 4, drop 3), DENT (3×3mm),
    a 2 cella-fix csavar (M2.5 önmetsző).
    validate.py: mindkét part 1-1 solid, ház 68×86×33.5. enc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
2026-06-22 feat(enclosure): cella-támasztó ÁLLÓ "Y" OSZLOP a HOSSZANTI (Y-Z) síkban — orientáció javítva
    MIT: a tetőplató cella-platformja alá teherviselő ÁLLÓ "Y" oszlop, az X-középvonalon (x=0). A két ÁG
    FELÜL a cella-ágy (pocket, ±17.4) Y-szélein indul a dent fenekétől (z=col_top=29.5), lefelé a V-csúcsban
    (jz=14) egyesül, onnan közös szár/talp a doboz aljáig (z=0). Érintett: enclosure.py — import (Polygon/
    extrude/Plane), param-blokk (cell_col_w_top/_w_base/_junction_z + ÚJ cell_col_thick_x), build_housing 3) szekció.
    MIÉRT / ORIENTÁCIÓ (két korábbi agent ezt rontotta el):
    - A 40f73cf profil JÓ volt, de Plane.XZ-ben → a két ág X-ben nyílt szét (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
2026-06-22 feat(enclosure): fedél-bossok félkör (D) collar-ra cserélve + furatok közelebb a falhoz
    MIT (user kérés): "hozzuk közelebb a falhoz a csavar furatokat, csak egy félkör merevítés kelljen
    köréjük". A 8 fedél-rögzítő boss (4 sarok + 4 oldal-közép) körüli téglalap-GUSSET (sarkon L-alak)
    lecserélve FÉLKÖR (D) merevítő COLLAR-ra. Érintett: enclosure.py — boss param-blokk + build_housing
    boss-szekció.
    HOGYAN:
    - corner_inset 3.0 → 2.8: a boss-közép közelebb a falhoz, a boss SZÉLE épp a falsíkba ér
    (x_edge=30.1 / y_edge=40.1). KORLÁT: a +Y fal tömítőhornya (belső él 40.5) pinneli a ~2.8 minimumot
    — ennél közelebb a horony sérülne (IP65)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
2026-06-22 feat(enclosure): fedél-furatok a falhoz húzva (egyenletes rés) + ±Y fal 4mm-re (befelé) + kisebb ráhagyás
    MIT (user, 4 kérés egy körben):
    1) "a furat majdnem érintse a falat" → a boss-behúzást NEM fix számra állítjuk, hanem a boss SZÉLÉT a
    tömítőhorony belső éle elé húzzuk groove_clear=0.3 réssel. Eredmény: a pilot-furat széle 0.5 mm-re
    a belső falsíktól (volt ~1.75). A behúzás SZÁRMAZTATOTT (inset_x/inset_y), fal-típusonként számolt.
    2) "kisebb ráhagyás körülötte" → boss_wall 1.85→1.2 (boss Ø5.8→4.5); collar_ring 1.6→0.8 (collar Ø→6.1).
    3) "nem egyenletes körben a távolság" → GYÖKÉROK: a ±Y fal (3 mm) vékonyabb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
2026-06-22 feat(enclosure): +X oldali 3 fedél-csavar KÜLSŐ FÜLRE — a holder helyét felszabadítja
    MIT (user): "a csavarokat kívülre" a +X oldalon — a holder nem fért el a +X belső sávban a 3 fedél-boss
    miatt (a középső y=0 pont az akku közepe alatt). A 3 +X boss (2 sarok + 1 oldal-közép) helyett most
    KÜLSŐ FÜL (lug): a +X külső falsíkról kifelé lógó tömör fül (z[0,boss_h]), alulról pilot furattal; a
    fedél egy-egy nyúlvánnyal ér ki alá + clearance furat. A többi 5 csavar BENT marad (−X 2 sarok +
    −X/+Y/−Y oldal-közép), félkör-collarral. Érintett: enclosure.py — ear param-blokk, derived (corner/
    side_positions a +X kivéve + ext_ear_positions), build_h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
2026-06-22 feat(enclosure): doboz alacsonyítva −5mm + cella-fix boss tail levágva + Y-oszlop középcsavar (1/2)
    Több részes user-kérés ELSŐ fele (a fedél megemelt rács a 2. commitban jön):
    1) ALACSONYÍTÁS (user: "egy jó fél centivel"): inner_z 30→25. Lehetővé tette, hogy a +X bossok kikerültek
    a holder alól (előző commit) → a holder lejjebb ülhet: batt_z0 9→3 (decoupled a boss_h-tól). A 18650
    (Ø18.5) teteje így ~21.5 < inner_z=25 (≥3 mm margó). housing_h 33.5→28.5. bbox Z 33.5→28.5.
    2) CELLA-FIX BOSS TAIL LEVÁGVA (user: "a furaton túlnyúló szegmenst levágni"): cell_fix_boss_h
    9.0 → cell_fix_depth−top_th+1 = 3.5. A boss eddig 6.5 mm tömör tai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
2026-06-22 feat(enclosure): bottom_lid megemelt belső DUGÓ — perem tömör + diagonális rács (2/2)
    MIT (user, a többrészes kérés MÁSODIK fele): a fedél belső része ~1 mm-rel megemelve, hogy a doboz
    NYÍLÁSÁBA illeszkedjen (centrálás + labirintus-szigetelés a gasket-en belül → jobb illeszkedés/tömítés).
    A megemelt réteg PEREME TÖMÖR keret (egy falvastagság), KÖZEPE DIAGONÁLIS (45°) négyzetrács (anyagspórlás
    + merevítés). Érintett: enclosure.py — lid-dugó param-blokk + build_bottom_lid.
    - dugó-footprint = inner_x−2*lid_plug_gap × inner_y−2*lid_plug_gap (59.4×77.4) → 0.3 mm rés a
    kavitásfalhoz (csúszó illesztés). Magasság lid_rise=1.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
2026-06-22 feat(enclosure): nyomtatás-erősítő él-kezelés — nem-kontakt élek lekerekítve/kónuszolva
    MIT (user): "az összes sarkot, élet, ami nem kontakt illesztés ... kónuszosíts, kerekíts, hogy a 3D
    nyomtatást erősítsük". A nem-kontakt éleket lágyítjuk (kevesebb feszültséggyűjtő, jobb rétegtapadás,
    nincs sérülékeny éles sarok); a KONTAKT felületek ÉLESEK maradnak.
    ÉLESEN HAGYVA (kontakt/illesztés, szándékosan NEM érintve): USB-nyílások, furatok belseje (pilot/
    clearance), cella-ágy (pocket/dent/karima), fedél↔ház érintkező felület + tömítőhorony, a fedél tető-
    síkja (z=0) és a megemelt dugó (nesting).
    LEKEREKÍTVE / KÓNUSZOLVA (most):
    - H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
2026-06-22 feat(enclosure): agresszív kónusz a csavar-foglalatok körül — fokozatos besüllyedés a falba
    MIT (user): "a csavar foglalat körívek körül sokkal agresszívebb kónusz kell, főleg a külsőknél, sokkal
    fokozatosabban süllyedjen a falba — oldalirányban és felfelé is". A korábbi kis (0.8) fül-kónusz helyett
    a fül↔fal CSATLAKOZÁST rámpázzuk meg, és a belső collarok tetejét is kónuszoljuk.
    HOGYAN (enclosure.py, build_housing él-kezelő szakasz + param-blokk):
    - KÜLSŐ FÜLEK (a +X lugok), a falba-süllyedés két irányban:
    * FELSŐ csatlakozó él (z=boss_h, falsík, Y-mentén) → chamfer ear_wall_cham_top=3.5 → rámpa FELFELÉ
    a falba (a fü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
2026-06-22 feat(enclosure): Y-oszlop nem-kontakt profil-sarkai lekerekítve (weak-point megszüntetés)
    MIT (user, rajzzal): "ahol nincs érintkezés valamivel, ne maradjon éles sarok, mert az csak weak-point" —
    a Y-oszlop profil-sarkaira berajzolt ívekkel. A két ÁG-TŐ (±wb, jz) és a V-CSÚCS (0, jz) lekerekítve.
    HOGYAN: a fillet a 2D PROFILON (Polygon vertices), MIELŐTT extrudálnánk — robusztus (az OCCT a 2D-sarkot
    megbízhatóan kerekíti; az extrude hengeres átmenetet ad X-ben). 3D-él vágás helyett. col_fillet_r=4.0.
    ÉLESEN marad (kontakt): a TETŐ (col_top, a karimával fúzió, teherbevitel) és az ALJ (z=0, fedél-kontakt
    + középcsavar). Csak a z=jz szintű, szabad belső s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
2026-06-22 feat(enclosure): karima-lightening a cella-fix bossok körül — felesleges anyag kivágva
    MIT (user, rajzzal + választással): "a cella-fix boss környékét nagyon le kéne gyalulni, csak zabálja a
    filamentet de semmit nem tesz hozzá". Felmérés: a KARIMA (42.8×42.8 tömör talp, z[22,25]) a cella-
    felfekvésen (pocket-perem, ±17.4) KÍVÜL nem támaszt cellát — a cella-fix bossok (y=±21.4) ott ülnek,
    a karima ott csak őket tartja. Ezt a PEREMET (teljes ±X/±Y keret a felfekvésen túl) kivágtuk.
    MEGTARTVA (érintetlen): a belső cella-támasztó négyzet (±band_in = ±17.9: a felfekvő gyűrű 14.4–17.4 +
    tartalék) + az oszlop-út (közép) + a 2 cella-fix boss körül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
2026-06-23 docs(handoff): HANDOFF.md lerövidítve + frissítve + munkafolyamat-tanulságok dokumentálva
    MIT (user): rövidebb hand-off a következő ágensnek, a munkafolyamattal; nem dokumentált tanulságok rögzítése.
    A régi HANDOFF.md ELAVULT volt (session előtti állapot: battery_door, M4 heat-set, inner_z=36, már
    megoldott layout↔enclosure eltérések). Teljesen átírva, rövidebbre, FRISS állapotra.
    ÚJ TANULSÁGOK (eddig sehol nem voltak leírva, a session során derültek ki):
    1. A viewer NEM frissül magától → layout.py/enclosure.py futtatása kell a push-hoz (a user többször
    emiatt "nem látott változást"; validate.py/inline szkript NEM pushol).
    2. A layout.py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
2026-06-23 feat(enclosure): cella-ágy teherúti ÍVEK — dent felfekvés-perem + karima alsó él FILLET-elve
    MIT: a cella-ágy alatti két éles, derékszögű átmenetet körívvel (fillet) váltottam ki,
    hogy a teherelosztás folytonos görbületű legyen.
    * DENT: a kivágó test FELSŐ pereme fillet-elve (cell_dent_fillet_r=1.5) → kivonás után a
    felfekvő gyűrű HOMORÚ körívvel megy az üregbe. A gyűrű FELSŐ SÍKJA (cella-felfekvés) ÉLES marad.
    * KARIMA: a hozzáadott talp ALSÓ KÜLSŐ pereme fillet-elve (cell_flange_fillet_r=1.5) → a lelógó
    perem folytonos görbülettel olvad a kavitás-térbe (nincs alávágott éles él).
    Új hangolható paraméterek: cell_dent_fi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
2026-06-23 tooling(preview): GYORS vizuális ellenőrző eszköz (preview.py) — vak iteráció megszüntetése
    MIT: új `preview.py` — egyetlen paranccsal, STL-EXPORT NÉLKÜL (közvetlenül a build123d testből
    tessellate-tel) PNG-t ír (export/preview.png): perspektív nézet (izo + felül) + tetszőleges X-síkú
    VALÓDI TÖMÖR KERESZTMETSZETEK (housing ∩ sík → tessellált Face-ek → 2D fill, mint az ocp-vscode Clip).
    python preview.py # alap: X=0, X=11
    python preview.py 0 6 11 -7.9 # tetszőleges metsző-síkok
    HANDOFF frissítve: preview.py beemelve a parancslistába + az 1. tanulság átírva ("ne dolgozz vakon").
    MIÉRT (user-visszajelzés a workflow-ról): "iszonyat s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
2026-06-23 chore(wireless_scaling): felesleges fájlok törlése — README, watch.py, layout.py
    MIT: 3 trackelt, a munkafolyamathoz nem szükséges fájl eltávolítva (user-döntés):
    - README.md: elavult (battery_door/válaszfal/PCB-standoff mind törölve a designból), a HANDOFF.md
    átfedi. A nulláról-setup (venv, pip, ocp-vscode) átmentve a HANDOFF 0. szakaszába → a HANDOFF
    mostantól az EGYETLEN belépő doksi.
    - watch.py: élő auto-frissítő viewer — redundáns (senki nem szerkeszt élőben most; a preview.py +
    enclosure.py push fedi a vizuális igényt).
    - layout.py: alkatrész-pakolás + viewer push — a COMPONENTS már csak akku+cella, a viewer-push az
    enclosure.py-ban meg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
2026-06-23 docs(handoff): token-takarékos DELEGÁLÁS szakasz — geom. munka izolált al-ágenssel
    Mit: új "1b. DELEGÁLÁS" szakasz a HANDOFF.md-ben — az orchestrátor a jól
    körülhatárolt geometriai változásokat az `enclosure-builder` al-ágensnek delegálja
    (friss/izolált kontextus), és csak a végeredményt + a végső preview.png-t ellenőrzi.
    Miért: a 3D iterációs hurok (szerkesztés → validate.py → preview.py → Read PNG → újra)
    sok tokent égetett, mert minden kör PNG-t + validate-dumpot + diffet hagyott a fő
    beszélgetésben. Izolált al-ágensnél a köztes hurok NÁLA marad, csak a tömör záró
    üzenet jön vissza → a fő kontextus tiszta marad.
    Kapcsolódó (N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
2026-06-23 revert(enclosure): cella-ágy teherúti ÍVEK visszavonva — vissza derékszögű lépcsőkre
    MIT: a 4ddc255 ("cella-ágy teherúti ÍVEK") által hozzáadott KÉT fillet teljes
    visszavonása. Az enclosure.py cella-plató szekciója visszaáll a 4ddc255 ELŐTTI,
    tiszta derékszögű lépcsős formára:
    * KARIMA (1b): a `flange` round_edges-hívás törölve → újra sima, egyenes Box.
    * DENT (1c): a `dent_cutter` round_edges-hívás törölve → újra sima, egyenes Box.
    * A két paraméter (cell_dent_fillet_r, cell_flange_fillet_r) + a hozzájuk tartozó
    komment-blokkok eltávolítva.
    Visszaállítás módja: `git checkout 4ddc255~1 -- enclosure.py` (a fájlhoz 4ddc255 óta
    senk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
2026-06-23 feat(enclosure): gasket-horony eltávolítása a housing alsó zárásáról → SÍK felfekvő perem
    MIT: a build_housing alsó (z=0) zárásán futó körbefutó tömítőhorony
    (groove_out − groove_in; `housing -= ...`) faragása kiiktatva (kikommentelve).
    Az alsó felfekvő perem így teljesen SÍK (lapos).
    MIÉRT: user-döntés — az alsó zárás IP65-je tudatosan feladva (a kaptár alatt,
    felülről zárt; a felfekvő perem sík illesztése egyszerűbb + a következő lépésben
    a lid külső kontúrja flush-ra kerül a házzal).
    KORLÁT TARTVA: csak a housing alsó hornya érintve. A lid_plug megemelt dugó,
    fit_gap/lid_plug_gap illesztés, bossok/collarok, fülek érintetlenek.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
2026-06-23 feat(enclosure): bottom_lid külső kontúr "tükrözése" a házhoz — flush footprint + sarok-fillet + 1.0 alsó chamfer
    A gasket nélküli (sík peremű) aljat referenciának véve a lid külső kontúrját a housing
    KÜLSŐ footprintjéhez igazítja, hogy összeszerelve folytonos, lekerekített doboz legyen.
    MIT (3 rész):
    (a) FLUSH külső footprint: a lid fő doboz-teste `Box(outer_x-2*fit_gap, outer_y-2*fit_gap)` helyett
    `Box(outer_x, outer_y)` → a korábbi ~0.3 mm körbefutó behúzás feladva. A fül-nyúlvány
    referenciája `lid_edge_x = outer_x/2 - fit_gap` → `outer_x/2` (flush a ház falsíkjával).
    A BELSŐ illesztő dugó (lid_plug) ÉRINTETLEN: továbbra is l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
2026-06-23 feat(enclosure): cella-fix boss-fül "kerek fej + EGYENES nyak" — homorú Pac-Man ívek kiváltva
    MIT: a 2 cella-fix boss (x=0, y=±21.4) karima-lightening füle a band_in négyzet élével eddig
    HOMORÚ ("Pac-Man") íveket adott, mert a megtartott collart egy sima Cylinder definiálta, ami
    nagyrészt a band él KÍVÜLI oldalán állt ki és csak egy keskeny húrnál csatlakozott. A user kérése:
    "kerek fej + egyenes nyak". A megtartott-anyag profilját átépítettem KÖR (fej) + KÉT ÉRINTŐ-EGYENES
    (nyak) formára.
    HOGYAN (enclosure.py):
    - import: + Circle, + math.
    - ÚJ paraméter (param-blokk, ~154. sor): cell_flange_neck_halfw = 4.0 [mm] — a nyak fél-szélessége
    a band_in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
2026-06-23 fix(enclosure): cella-fix boss-fül nyak — szélesedő trapéz-gusset (érintő-logika kidobva)
    MIT: a cell_flange_lighten blokk boss-fül nyak-profilját átépítve. Az előző
    érintő-egyenes számítás (ang_pc/ang_off/rtan=max(...)) TELJESEN kidobva — az
    befelé szűkülő hegyes csúcsot és aszimmetriát adott (a user elutasította).
    Helyette egyszerű, szigorúan szimmetrikus trapéz: KÖR (center 0,cy_b; collar_r)
    ∪ NYAK-TRAPÉZ, felső sarkok a kör OLDALSÓ pontjai (±collar_r, cy_b), alsó sarkok
    a plató-élen SZÉLESEBBEN (±nbase, band_edge). A két oldalél KIFELÉ dől a platform
    felé (szélesedő gusset), nincs homorú ív, nincs hegyes csúcs.
    PARAM: cell_flange_n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
2026-06-23 feat(lid): +X fül-nyúlványok sarok-kezelése a housing fülek TÜKRE (ear_chamfer + lid_bottom_chamfer)
    - build_bottom_lid(): a 3 +X fül-nyúlvány eddig ÉLES derékszögű Box volt (sem a 4-sarok 2D-profil
    fillet, sem a length>20 alsó-perem chamfer nem érte el) → a housing fülei alól élesen kiállt.
    - Most a fül-nyúlványok felveszik a housing +X fülek sarok-kezelésének TÜKÖRKÉPÉT:
    * KÜLSŐ (faltól távoli, x>ox+2) függőleges sarkok → ear_chamfer (=0.8), a housing :607-609 tükre,
    * a fül ALSÓ (z=−lid_th) perem-élei → lid_bottom_chamfer (=top_chamfer=1.0).
    - ÚJ paraméter NINCS: a meglévő ear_chamfer / lid_bottom_chamfer értékeket használja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
2026-06-25 feat(dashboard): median_k5 zajszűrés a render-pipeline-ban (HW-tüskék levágása)
    Mit: a public/app.js redraw() rúdankénti CENTRÁLT gördülő mediánt (k=5) futtat a
    sortedRows eredményén, a pairTotal párosítás ELŐTT. Új MEDIAN_K konstans (0/1 =
    kikapcsolva) + medianSmooth(rows,k) (ts-megőrző, edge-clamp). A fejléc
    (updateLatest) is a szűrt sorokat kapja, így a "latest kg" sem ugrik tüskére.
    Miért: a HX711/mechanikai eredetű 1-2 mintás kiugró tüskék (±pár kg) csúnyán
    ugráltak az össz-súly görbén. Több szűrőt összevetve (experiments/filtering) a
    median_k5 a legegyszerűbb, ami tisztán levágja a tüskét a valós trend + finom
    dinamika megőrzése me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
2026-06-25 chore(experiments): szűrő-összehasonlító eszközök + adat-snapshot (filtering)
    Mit: experiments/filtering/ — pair_export.py (RTDB rods/w1+w2 -> párosított
    össz-súly CSV, az app.js párosítási logika tükre), filter_compare.py (8 szűrő
    összevetése: ma/median/hampel/diff_clip/diff_mad/spike_io/hampel+ma3 + statisztika
    + static ábrák), make_explorer.py (interaktív Plotly HTML: zoom/pan/legend-toggle).
    bee_weights.csv: a kísérlet bemenő adat-snapshotja (3846 párosított minta,
    2026-06-12..06-25). .gitignore: a generált kimenetek (filtered.csv, 2 png,
    explorer.html) kizárva — a *.py-ból reprodukálhatók.
    Miért: a median_k5 választás bizonyítéka + a jövőbeli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
2026-06-26 feat(wireless_scaling): 2. fázis untracked forrásfájlok mentése — _zsection.py + enclosure-builder agent
    Mit: a wireless_scaling (2. fázis, 3D ház) két eddig sehol nem
    commitolt forrásfájlja kerül git alá a dev_3d branchen:
    - wireless_scaling/_zsection.py — célzott Z-metszet vizualizáló
    (build123d): a ±Y bossokat külön, nagyítva, a -Y-t tükrözve
    rajzolja, hogy a nyak-trapéz forma + a +Y/-Y szimmetria
    egyértelmű legyen. `import enclosure as E` → az enclosure.py
    mellé tartozik, ezért a wireless_scaling/ mappába.
    - wireless_scaling/agents/enclosure-builder.md — az enclosure-builder
    al-ágens definíciója (a geom. iterációt izolált kontextusban fut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
2026-06-26 refactor(struktura): fazis-alapu mappastruktura a main-hez
    Mit: az 1. fazis osszes kodja a prototype/ ala kerul (git mv =
    rename-history megtartva), a wireless_scaling/ (2. fazis) a gyokerben
    marad. A kozos meta (CLAUDE.md, MEMORY.md, project_boards.md,
    project_wifi_test.md, .gitignore) a gyokerben marad.
    Athelyezve a prototype/ ala: firmware, experiments, public, firebase,
    tasks, firebase.json, .firebaserc.
    Miert: a ket fejlesztesi fazis (1=meres/dashboard/firmware,
    2=wireless_scaling 3D haz) mappa-szinten is elkulonuljon a main-en,
    a branch-history (dev_01 27 + dev_3d 83 commit) megtartasaval.
    Megj.: a firebase deploy ezutan a prototype/ alol futtatando.
2026-06-26 refactor(struktura): kozos meta is a prototype/ ala (1. fazis)
    A CLAUDE.md, MEMORY.md, project_boards.md, project_wifi_test.md a
    gyokerbol a prototype/ ala kerul (git rename, history megtartva) — a
    teljes 1. fazis a dokumentaciojaval egyutt a prototype/ alatt el.
    A gyoker ezzel tisztan a ket fazis-mappat (prototype/, wireless_scaling/)
    es a .gitignore-t tartja.
2026-06-26 refactor(wireless_scaling): hosszú távú mappastruktúra — experiments / firmware / enclosure / docs / agents
    Mit: a lapos wireless_scaling/ átszervezve kategóriánkénti mappákba
    (git mv, rename-history megtartva):
    - enclosure/ — 3D modellezés: enclosure.py + validate/preview/_zsection
    (EGYÜTT, mert import enclosure) + datasheets/ + export/ + requirements.txt
    - docs/ — new_base_components.md + alkatreszek.csv (BOM, eddig untracked)
    - experiments/ — node-kísérletek (placeholder .gitkeep)
    - firmware/ — kiérlelt node-kód (placeholder .gitkeep)
    - agents/ — változatlan (enclosure-builder.md)
    - CLAUDE.md + MEMORY.md — a gyökérben (belépő), az új st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
    [alkatreszek.csv]
2026-06-28 docs(wireless_scaling): rendszerarchitektúra véglegesítése papíron + BOM bővítés + enclosure/README
    - MEMORY.md: új "7. Rendszerarchitektúra (firmware/elektronika) — papíron eldöntve"
    szekció (topológia, master vételi pipeline producer/consumer, payload_t formátum,
    perzisztencia, felhőzés, uplink, master táp 2 üzemmód, boardok) + 4 nyitott
    architektúra-kérdés. A régi "7. Mappastruktúra" -> "8.". Fejléc-dátum frissítve.
    - docs/new_base_components.md: projektösszefoglaló -> teljes projektdokumentáció.
    Kommunikációs protokollok (ESP-NOW app-ack vs. tűzz-és-felejts), adattárolás
    (PSRAM ~40 nap puffer + AT24C256 EEPROM checkpoint, SD ELHAGYV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
    [alkatreszek.csv]
2026-06-28 docs(experiments): validációs feladatbontás projektesítése — 10 chunk-mappa + index README (kód nélkül)
    - experiments/README.md: áttekintő index. Setup-szintek (0/1/2/2.5/3), három
    bizonytalanságforrás (A elektromos, B rádiós, C flotta), teljes chunk-térkép
    linkekkel, kritikus út diagram (H1→H2→Sz0→Sz1→Sz2→Sz3; drift-ág Sz3→M1→Sz4;
    Sz5 párhuzamos), iterálhatósági elvek.
    - 10 chunk-almappa, mindegyik egy README-vel, egységes sablon szerint (cél,
    setup-szint, függőségek, bemenet, megvalósítási vázlat KÓD NÉLKÜL, deliverable,
    számszerű pass/fail tábla, nyitott kérdések, hivatkozások):
    - Hardver: H1_node_board_prep (deep-s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
2026-06-28 feat(H1): node deep-sleep áram-mérő firmware + mérési setup + eredmény-CSV
    - experiments/H1_node_board_prep alá ESP-IDF projekt (ESP32-C3 target) +
    mérési dokumentáció. A H1 chunk implementációja: a node nyers nyugalmi
    (deep-sleep) áramának kiméréséhez szükséges minimális firmware és setup.
    - Új fájlok:
    - CMakeLists.txt (gyökér) + main/CMakeLists.txt + main/h1_node_board_prep.c
    - sdkconfig.defaults (kompakt log/boot, RTC-RC default meghagyva)
    - meresi_setup.md (bekötés ASCII, pinout, hol/hogyan mérj, alvariánsok, hibakeresés)
    - mereseredmenyek.csv (kézi kitöltésű eredmény-tábla a README küszöbeivel, 2 PÉLDA sor)
    - .gitignore (IDF buil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
2026-06-28 fix(H1): ESP32-C3 deep-sleep GPIO hold javítás (rtc_gpio_* nem létezik C3-on) + hiányzó esp_rom include
    - experiments/H1_node_board_prep/main/h1_node_board_prep.c:
    - `#include "driver/rtc_io.h"` ELTÁVOLÍTVA, helyette `#include "esp_rom/esp_rom_sys.h"`.
    - hold_critical_gpios_for_sleep(): a `rtc_gpio_is_valid_gpio()`/`rtc_gpio_hold_en()`
    ág kiváltva `gpio_hold_en(PD_SCK)` + `gpio_hold_en(USER_LED)` + a meglévő
    `gpio_deep_sleep_hold_en()` párossal. A LED off-szintje is befagyasztva alvásra.
    - A kommentek pontosítva (RTC GPIO hold -> GPIO hold) a HX711-leírásban, a PD_SCK
    paraméternél és a függvény fejlécében.
    Miért (gyökérok):
    - Az eredeti H1-fi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
    [h1_node_board_prep.c]
2026-06-28 build(H1): PlatformIO (framework=espidf) build hozzáadva + 2 fordítási hiba javítva — sikeres build
    - experiments/H1_node_board_prep/platformio.ini (ÚJ): PlatformIO build a tiszta ESP-IDF
    projekthez. `framework = espidf`, `board = esp32-c3-devkitm-1` (generikus C3, RISC-V
    toolchain), `src_dir = main` -> a natív ESP-IDF layout (gyökér CMakeLists.txt + main/
    komponens) változatlanul marad, a projekt idf.py-vel ÉS pio-val is fordul.
    - main/h1_node_board_prep.c: az include `esp_rom/esp_rom_sys.h` -> `esp_rom_sys.h`
    (az esp_rom komponens INCLUDE_DIRS-e már tartalmazza az esp_rom-ot; a path-prefix hibás volt).
    - sdkconfig.defaults:
    - `CONFIG_ESP_CONSOLE_USB_SERIAL_JTAG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
2026-06-28 chore(H1): a generált sdkconfig.<env> kivétele a trackingből + gitignore
    - experiments/H1_node_board_prep/.gitignore: `sdkconfig.*` ignorálva, `!sdkconfig.defaults`
    kivétellel (a defaults a FORRÁS, marad trackelve).
    - A PlatformIO/IDF által generált `sdkconfig.esp32-c3-supermini` (2225 sor) eltávolítva a
    git trackingből (git rm --cached).
    Miért:
    - A board-specifikus sdkconfig generált artefakt, a `sdkconfig.defaults`-ból bármely build
    újraállítja. A projekt elvével konzisztens (forrás = kommentált defaults; generált kimenet
    gitignore-olt, mint az enclosure export/). Az előző commitba (659ddb2) tévedésből bekerült.
    Mi működött / mi nem:
    - Tisztán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
2026-06-28 fix(H1): USB-Serial-JTAG pad lekapcsolása deep sleep előtt — 731 µA -> ~185 µA (mérve)
    - main/h1_node_board_prep.c: deep sleep előtt (a log kiírása UTÁN) meghívjuk az IDF
    `sleep_console_usj_pad_backup_and_disable()` helperét (esp_private/sleep_console.h),
    ami lekapcsolja a USB-Serial-JTAG padot. Új include: soc/soc_caps.h + a private header;
    a hívás `#if SOC_USB_SERIAL_JTAG_SUPPORTED` guard alatt. A záró log a pad-off ELŐTT megy ki.
    Miért (tünet -> gyökérok -> megoldás):
    - TÜNET: 3.3V-ról táplált board deep sleepben 1 mA, a power-LED ellenállás leszedése után
    ~731 µA — a cél <50 µA. Domináns rejtett fogyasztó.
    - GYÖKÉROK: a korábban ál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
    [h1_node_board_prep.c]
2026-06-28 docs(H1): mérési eredmények + napló rögzítése (731→185 µA), elavult log-hivatkozás javítva
    - mereseredmenyek.csv: a 2 PÉLDA sor lecserélve a 2026-06-28-i VALÓS mérésekre
    (ESP32-C3 SuperMini, 3.3V a 3V3 lábra, HX711 modul nélkül):
    1 mA (eredeti fw, LED-del) -> 731 µA (LED leszedve) -> 185 µA (USB-JTAG fw fix).
    - meresi_setup.md:
    - Hibakeresés #2: elavult log-szöveg javítva ("RTC hold" -> "GPIO hold: PD_SCK(GPIO5)
    HIGH ... megtartva"), összhangban a C3-ra átírt gpio_hold_en megoldással.
    - Új hibakeresési pont (#7): USB-Serial-JTAG pad deep-sleep fogyasztása + a fw-fix.
    - Új "6. Mérési napló — 2026-06-28": lépésenkénti áram-tábla +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
2026-06-28 docs(MEMORY): node deep-sleep alapszám felvétele (H1) — új 8. szakasz
    - MEMORY.md új "8. Kísérleti eredmények / mérések" szakasz: a H1 node deep-sleep
    alapszáma (~185 µA elérve), a USB-JTAG pad fix (731→185), a maradék ~185 µA ≈
    AMS1117 LDO + GPIO/RTC, és a döntés (LDO-leszedés prodra halasztva). Firmware-stack
    (ESP-IDF + PlatformIO) és HX711 pin-terv (SCK=GPIO5, DT=GPIO6) rögzítve.
    - A korábbi "8. Mappastruktúra" -> "9."; az experiments/ leírás frissítve (már nem üres,
    chunk-struktúra + H1 kész). Fejléc-dátum 2026-06-28.
    - A felhasználóval egyeztetve (orchestrátor frissíti a MEMORY.md-t). A node-energiamérleg
    alapszáma tart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
2026-06-28 feat(H2): HX711 power-path mérő firmware + setup/CSV (ESP-IDF, build zöld)
    A H2 chunk (HX711 power-path / excitation-lekapcsolás) teljes anyaga az
    experiments/H2_hx711_power_path/ mappába, a kész H1 chunk mintájára:
    - main/h2_hx711_power_path.c — ESP-IDF firmware (a H1 firmware átirata): a HX711-et
    power-downba teszi (PD_SCK=GPIO5 HIGH + GPIO-hold), a kék LED-et kikapcsolja, a
    USB-Serial-JTAG padot deep sleep előtt lekapcsolja, majd esp_deep_sleep. TAG="H2".
    - main/CMakeLists.txt, CMakeLists.txt (project h2_hx711_power_path), platformio.ini,
    sdkconfig.defaults, .gitignore — mind a H1 mintára, H2-re hangolt kommentekkel.
    - meresi_setup.md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
2026-06-28 feat(H2): aktív-ciklus mérési mód — HX711 üzemi (powered-up) fogyasztás
    A H2 firmware-be egy H2_MEASURE_MODE kapcsoló került (a paraméter-blokk tetején), ami két
    mérési üzemmódot választ:
    - H2_MEASURE_MODE == 0 : az eddigi DEEP-SLEEP mód — HX711 power-down + (opc. excitation-
    probe) + tartós deep sleep. Az (A) nyugalmi áram + (B) excitation-lekapcsolás mérése.
    - H2_MEASURE_MODE == 1 : ÚJ AKTÍV-CIKLUS mód — az ESP ÉBREN marad (nincs deep sleep, nincs
    USB-JTAG pad off → a soros log végig él), és a HX711-et a végtelenségig ciklusolja:
    HX711_POWERUP_MS (alap 10 000 ms) powered-up (PD_SCK LOW, excitation BE) → HX711_POWERD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
2026-06-28 test(H2): HX711 power-down IGAZOLVA — aktív ~5 mA, power-down ~0 (mért, 2026-06-28)
    A H2 aktív-ciklus mérés lefutott; az eredmény rögzítve a mereseredmenyek.csv-be és a
    meresi_setup.md mérési naplójába (## 6, 2026-06-28). A firmware HX711_POWERDOWN_MS 10 -> 10000
    (szimmetrikus 10 s / 10 s ciklus), hogy a power-down leesés a DMM-en is látható legyen.
    MÉRÉSI EREDMÉNY (ESP32-C3 SuperMini + HX711-M olcsó breakout + HBS-SCL-50 cella;
    overall node-áram, a HX711 tápjának le-/felvételével mért differenciál):
    - HX711+cella AKTÍV (PD_SCK LOW, powered-up): ~5 mA — a HX711 + load cell híd üzemi árama.
    - HX711 POWER-DOWN (PD_SCK HIGH): ~0-ra esik -> a lek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
2026-06-28 docs(MEMORY): H2 chunk lezárása — HX711 power-path eredmény a 8. szakaszba
    A MEMORY.md 8. szakaszába bekerült a H2 alapszám (a H1 mintájára), a 9. szakasz
    "H2 kész" jelölése, és az "Utolsó frissítés" fejléc frissítve. A felhasználóval
    egyeztetve, a H2 fázis lezárásakor.
    H2 RÖGZÍTETT TÉNYEK
    - HX711 power-down (PD_SCK=HIGH) ténylegesen lekapcsol: a modul+cella árama ~0-ra esik;
    a deep-sleep nyugalmi áram az overall node-fogyasztásban elhanyagolható (< pár µA).
    - HX711+cella AKTÍV árama ~5 mA (HX711 ~1.5 mA + cella híd ~3.3 mA @ 3.3V).
    - A firmware két módú (H2_MEASURE_MODE): 0 = deep-sleep/excitation, 1 = aktív-ciklus.
    A forrás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
2026-06-28 feat(H2): MODE 2 data-monitor — HX711 nyers 24-bit ADC olvasás (bekötés-ellenőrzés)
    Harmadik üzemmód a H2 firmware-be (H2_MEASURE_MODE == 2): az ESP ébren marad, a HX711-et
    powered-up állapotban tartja, és HX711_MONITOR_PERIOD_MS-onként (alap 500 ms) kiolvassa a
    nyers 24-bit ADC értéket bit-bang protokollal (vár a DOUT LOW-ra = adat kész, 25 SCK-impulzus
    MSB-elöl, A csatorna gain 128, 24-bit 2's complement -> előjeles 32-bit), HX711_MONITOR_AVG
    (alap 4) minta átlagával, és a soros logra írja: "HX711 raw=...". Új függvények: hx711_read_raw(),
    hx711_monitor_loop() (#if H2_MEASURE_MODE == 2 alatt -> nincs -Wunused-function). app_main:
    #elif H2_MEASURE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
2026-06-28 feat(Sz2): ESP-NOW alacsony szint — node TX + master RX + közös header, build zöld (mindkét target)
    Az Sz2 chunk (ESP-NOW send/recv callback-fegyelem) teljes firmware-e, két önálló
    PlatformIO/ESP-IDF projekt egy közös headerrel, a H1/H2 sablonra:
    experiments/Sz2_espnow_low_level/
    common/sz2_protocol.h — KÖZÖS packed wire-formátum (mindkét firmware includolja)
    node/ — TX, ESP32-C3 SuperMini (board esp32-c3-devkitm-1, USB-JTAG konzol)
    master/ — RX, classic ESP-WROOM-32 (board esp32dev, UART0 konzol)
    meresi_setup.md — 2-board flashelés + teszt-menet + PASS-feltétel + hibakeresés
    mere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
2026-06-28 fix(Sz2): C3↔classic-ESP32 ESP-NOW néma-bug — PHY-protokoll/ráta fix; 2-board teszt PASS (padon)
    A node→master ESP-NOW kommunikáció beüzemelése padon (ESP32-C3 node + classic ESP-WROOM-32
    master), a néma-vétel bug megtalálása és javítása, majd a 1000-csomag stressz-teszt PASS-ig
    vitele. Érintett: node/master wifi_espnow_init (fix), master diagnosztika + opcionális sniffer,
    doksik (meresi_setup.md 7. szakasz, README Eredmény), mereseredmenyek.csv (valós PASS-sor).
    A BUG (tünet → gyökérok → fix)
    - TÜNET: a master egészségesen elindult ("Master kesz, varja a csomagokat"), de 0 csomagot
    vett, miközben a node a saját logja szerint hibátlanul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
2026-06-28 feat(M1): drift-mérő scaffolding — node deep-sleep beacon + master logger + offline analizátor (build zöld, offline ön-teszt PASS; HW-futás hátravan)
    Az M1 chunk (node belső RC slow-clock deep-sleep DRIFT-jének hosszútávú kimérése)
    teljes mérő-apparátusa, két függetlenül implementált félből egy BEFAGYASZTOTT
    wire/log-kontraktusra építve. Új könyvtár: experiments/M1_drift_guard_window/
    - common/sz2_protocol.h az Sz2 header SZÓ SZERINTI másolata (wire-formátum változatlan)
    - node/ (m1_node_beacon.c) ESP32-C3 SuperMini deep-sleep beacon (TX)
    - master/ (m1_master_logger.c) classic ESP-WROOM-32 passzív vevő + grep-elhető logger (RX)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
    [log_master.py, m1_drift_analyze.py]
2026-06-28 fix(M1): logger no-auto-reset on open (blob 2.5MB→6KB) + meresi_setup csatorna-define javítás
    - log_master.py: a soros portot NYITATLANUL hozzuk létre, a DTR/RTS-t False-ra (deasszertált)
    állítjuk az open() előtt és után is (a CP2102/CH340 auto-reset elkerülésének bevett receptje:
    EN magas + IO0 magas = normál futás, nincs reset/download-mód).
    - meresi_setup.md: a hibakeresés tévesen `M1_CHANNEL`-t írt; a firmware `SZ2_CHANNEL`-t használ
    (a fájl tetején, alap 1) — javítva.
    MIÉRT (smoke-teszt tanulság, padon mérve 2026-06-28)
    A 2-board smoke-teszt során kiderült: a logger port-nyitása DTR/RTS-en RESETELI a master ESP-t,
    ami (a) az esp_t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
    [log_master.py]
2026-06-29 feat(M1): drift-mérés LEZÁRVA — node deep-sleep óra-drift +0,60% (nyers) / +0,29% (tiszta RC), guard ~260 s/12h; eredmény + CSV/JSON + MEMORY
    Az M1 chunk lezárása a 2-board éjszakai (~6 órás) futás eredményével. Új/frissített:
    - log.txt a nyers master-log (host-időbélyeggel; reprodukálhatóság-bizonyíték)
    - m1_drift.csv per-cycle tábla (88 sor) az analizátorból (pandas/Excel)
    - m1_drift.json strukturált eredmény (meta/drift/temperature/packet_loss/guard_window/samples)
    - m1_to_json.py ÚJ: a CSV-t strukturált JSON-ná alakítja + újraszámolja az összegzőt (kereszt-ellenőrzés)
    - mereser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
    [m1_to_json.py]
2026-06-29 feat(M1b): STANDALONE off-grid hő-drift mérő — node FW (deep-sleep + I2C DS3231/AT24C32 + HX711 nyers + EEPROM-log + dump) + offline Python; build ZÖLD, önteszt + end-to-end kontraktus PASS (HW-futás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
    MIT / MIÉRT
    Az M1 (szobahős óra-drift, master-referencia) hő-MEREDEKSÉGGEL (ppm/°C) való
    kiegészítése: egy ESP32-C3 SuperMini node-ot nagy power bankról hűtőbe/napra
    kiviszünk — se master, se PC, se rádió. Minden deep-sleep ébredéskor PERZISZTENSEN
    (AT24C32 EEPROM) logol: (1) a saját RC slow-clock óra-driftjét egy DS3231 (±2 ppm,
    hőkompenzált) referenciához, és (2) a mérőcella+HX711 nyers olvasatát (konstans
    terhelés -> a cella+HX711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
    [m1b_node.c]
2026-06-29 fix(M1b): I2C pin-illesztés az éles bekötéshez — SDA GPIO3->GPIO4, SCL GPIO10->GPIO3
    A ZS-042 (DS3231+AT24C32) tényleges bekötése a node-on: SDA=GPIO4, SCL=GPIO3
    (a felhasználó igazolta, hogy ez a busz működik). A scaffolding-default
    (SDA=GPIO3, SCL=GPIO10) a tervezett, de nem a beépített kiosztás volt -> a két
    M1B_I2C_*_GPIO define + a fejléc-komment átírva az élesre. Mindkét láb szabad,
    ADC-képes, nem ütközik (HX711=5/6, USB=18/19, UART=20/21, strapping=2/8/9).
    MI MŰKÖDÖTT
    - pio run: SUCCESS (esp32-c3-supermini, espidf 5.5.3), változatlan méret.
    - Csak pin-konstans + komment módosult; a logika/kontraktus érintetlen.
    NYITOTT
    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
    [m1b_node.c]
2026-06-30 fix(M1b): HX711 deep-sleep GPIO-hold bug (timer-wake-en hx=0) + DIAG-mód — HW-en validálva (padi próba)
    TÜNET (padi próba, ESP32-C3 SuperMini + ZS-042 + HX711, T=10 s)
    Az ERASE+START után dumpolva: a cold-boot rekord (idx=0) HX711 értéke JÓ (hx=-44920),
    de MINDEN timer-wake rekordban hx=0. Ráadásul a ciklus-idő ~15 s volt 10 s helyett.
    Az enter_deep_sleep() a HX711 PD_SCK-t (GPIO5) gpio_hold_en()-nel HIGH-on (power-down)
    befagyasztja, hogy alvás alatt a cella-excitation lekapcsolva maradjon. Ébredés után
    (deep sleep = teljes reboot a C3-on) a hold MÉG AKTÍV, ezért a hx711_gpio_setup()
    gpio_set_level(GPIO5, 0) (power-up) hívása NEM hatott -> a HX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
    [m1b_node.c]
2026-06-30 feat(M1b): awake_ms a kontraktusba — a drift awake-overhead korrekciója (FW + Python szinkron); önteszt PASS
    MIÉRT (a HW-próba leletéből)
    A T=10 s padi futás dump-ja: T_meas=11,38 s/cycle, azaz a nyers "drift" +13,76% volt —
    ez NEM óra-drift, hanem az awake (a ~1,4 s mérés-idő): a ds_unix-különbség minden ciklusban
    = awake + period×(1+drift). Az awake a 60 s periódusnál is ~2,3%, ami elfedi a valódi
    ~0,3-0,6% óra-driftet. A DS3231 ráadásul 1 s felbontású. Döntés (a felhasználóval):
    az awake mérése + logolása, és a Python levonja (az M1 m1_to_json.py avg_awake-mintája).
    KONTRAKTUS-BŐVÍTÉS (régi -> új)
    Dump-sor: M1B idx=.. cycle=.. ds_unix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
    [m1b_node.c]
2026-06-30 chore(M1b): awake_ms HW-validálva + éles mérés period 300 s-re állítva (nap-éj sweep)
    awake_ms HW-VALIDÁCIÓ (T=10 s padi próba, awake_ms-es FW, ERASE+START + dump)
    - A node valós awake_ms-t ír: idx=0 (cold boot) 1156 ms, timer-wake-ek konzisztens
    1262-1264 ms — pontosan ennyivel hosszabb a ~11,4 s-os ciklus a 10 s periódusnál.
    - A 16 B rekord írása/olvasása HW-en helyes (idx 0..15, minden mező épségben).
    - Python awake-korrekció HW-dumpon: nyers drift +14,19% -> awake-korrigált +1,63%
    (avg_awake 1256 ms). A korrekció a műdrift dominánsát leveszi; a maradék +1,63%
    period-független ~163 ms overhead (boot ~100 ms, esp_timer-rel nem mérhető, + a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
    [m1b_node.c]
2026-06-30 feat(M1b): éles hő-drift mérés EREDMÉNYE + recovery-mód — cella hődrift 1031 counts/°C (R²=0,97); modul lezárva
    ÉLES FUTÁS (HW, 2026-06-30, power bankról off-grid, T=300 s)
    7,35 óra, 89 érvényes rekord, DS3231 ambiens hő-tartomány 11,75..36,00 °C (span 24,25 °C).
    EREDMÉNYEK
    - Mérőcella+HX711 hő-drift: 1031 counts/°C, R²=0,974 (hx-span ~27 300 counts a 24 °C-on) —
    tiszta, erős lineáris jel. EZ az M1b fő célja, teljesült.
    - Óra-drift (RC slow-clock): awake-korrigált -2482 ppm (-8,94 s/óra), R²~1,0 (nyers +1838 ppm,
    avg_awake 1296 ms levonva). NB: ellentétes előjelű az M1 szobahős +2920 ppm-jéhez képest —
    a drift hő- és darabf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
    [m1b_node.c]
2026-07-02 docs(BOM): 3D nyomtatott ház felvétele az alkatrészlistába
    Mit: az alkatreszek.csv BOM új sorral bővül:
    casing, "3D nyomtatott ház", 3000 HUF Ntt, node=3, master=1
    Miért: az enclosure/ (build123d) ház immár a node BOM tényleges tétele,
    eddig hiányzott a költség-/darabszám-nyilvántartásból. A becsült
    3000 HUF/db anyag+nyomtatási költség 3 node-ra + 1 masterre könyvelve
    (a master is kap házat), így a node teljes anyagköltsége reálisabb.
    Mi működött / mi nem: tisztán adatsor-bővítés, nincs futtatható hatás.
    A CSV oszlop-szerkezet (név, funkció, ár, node, master) változatlan,
    a sor illeszkedik a formátumhoz.
    Nyitott pont: a 3000 HUF becs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
    [alkatreszek.csv]
2026-07-02 fix(M1b): HX711 pin-átkötés a casing-routing miatt (SCK->GPIO4, DT->GPIO3) + I2C csere
    Mit: a m1b_node.c pin-kiosztása a TÉNYLEGES fizikai bekötéshez igazítva:
    - HX711: PD_SCK/SCK GPIO5 -> GPIO4, DOUT/DT GPIO6 -> GPIO3
    - I2C: SDA GPIO4 -> GPIO5, SCL GPIO3 -> GPIO6
    Frissült a HARDVER/BEKÖTÉS fejlécblokk és mindkét #define-csoport (a régi
    értékek [korábban GPIOx] jelöléssel megőrizve a kommentben).
    Miért: a felhasználó a nyomtatott házba (casing) való beépítésnél a mérleg-
    erősítő SCK-t GPIO4-re, a DT-t GPIO3-ra kötötte át, hogy minden elektronika
    beférjen. Ez épp az I2C (DS3231/AT24C32) eddigi SDA/SCL lábaira esett, ez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
    [m1b_node.c]
2026-07-02 docs(M1b): I2C pin-hely NYITOTT — az 5/6 csak ideiglenes placeholder, nem végleges
    Mit: a m1b_node.c I2C kommentjeit pontosítottam. Az előző commit (1a925a5)
    'tiszta csere' feltételezéssel az I2C-t GPIO5/6-ra tette; a felhasználó jelezte,
    hogy az I2C NEM ide fog menni — a végleges helye még nincs kitalálva.
    - Header BEKÖTÉS-blokk és mindkét M1B_I2C_*_GPIO #define kommentje átírva:
    az 5/6 mostantól IDEIGLENES, ütközésmentes PLACEHOLDER-ként van jelölve
    (nem tényleges bekötés).
    - A #define ÉRTÉKE változatlan (GPIO5/GPIO6): a HX711 által felszabadított,
    ütközésmentes lábak, csak hogy a build érvényes maradjon.
    Miért: ne állítson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
2026-07-02 revert(M1b): a pin-átkötést visszavonom — M1b csak drift-mérés, a pinek a PROD kódba tartoznak
    Mit: visszavonom a b55814f és 1a925a5 commitokat -> a m1b_node.c bittre az
    eredeti (9fad4f3/77e5cbb) állapotba áll vissza:
    HX711 PD_SCK=GPIO5, DOUT=GPIO6 (változatlan)
    I2C SDA=GPIO4, SCL=GPIO3 (változatlan)
    Miért: az M1b modul KIZÁRÓLAG a hő-drift / delay-mérés kísérlete volt (lezárva),
    a kísérleti kód maradjon ÉRINTETLEN. A casing-routing miatti tényleges
    pin-átkötés (HX711 SCK=GPIO4, DT=GPIO3; I2C helye még nyitott) a most készülő
    PROD firmware-t (firmware/, jelenleg üres) fogja érinteni, NEM ezt a kísérletet.
    Ott lesz átvezetv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
    [m1b_node.c]
2026-07-02 feat(H4): master deep-sleep áram-mérő firmware (ESP32-S3-Zero) — a H1 master-párja
    - Új experiments chunk: experiments/H4_master_deep_sleep — minimál ESP-IDF firmware a
    végleges master (ESP32-S3-Zero, Waveshare) nyers deep-sleep áramának kiméréséhez.
    Fájlok: main/h4_master_deep_sleep.c, main/CMakeLists.txt, CMakeLists.txt,
    platformio.ini (board=esp32-s3-devkitc-1), sdkconfig.defaults, .gitignore, README.md.
    - A H1 (node C3 deep-sleep, ~185 µA) mintáját újrahasználja az S3-ra igazítva:
    1) USB-Serial-JTAG pad explicit lekapcsolása alvásra (sleep_console_usj_pad_backup_and_disable);
    2) WS2812 fedélzeti RGB LED data-láb (GPIO21) LOW + gpio_hold_en / gpio_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
2026-07-02 fix(H4): flash-méret 4 MB kikényszerítése upload/build szinten — boot loop javítva (éles S3-on)
    TÜNET (éles ESP32-S3-Zero-n, flashelés után)
    - A firmware boot loopolt, az app_main SOSEM futott le. Soros log:
    E spi_flash: Detected size(4096k) smaller than the size in the binary image
    header(8192k). Probe failed.
    assert failed: __esp_system_init_fn_init_flash startup_funcs.c:118 (flash_ret == ESP_OK)
    -> RTC_SW_CPU_RST reboot loop, végtelen. (A USB-JTAG minden reboot-ciklusban újra-enumerált,
    ezért a host-oldali port NEM tűnt el — ez volt a tünet első jele.)
    - Az S3-Zero az ESP32-S3FH4R2-t használja: 4 MB flash (+ 2 MB PSRAM). A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
2026-07-02 feat(H4): WS2812 fedélzeti LED szoftveres kioltása deep sleepre — éles S3-on igazolva SÖTÉT
    - A fedélzeti WS2812 RGB LED (GPIO21) deep sleep előtti kioltása: ws2812_off() fekete (0,0,0)
    frame-et küld az espressif/led_strip RMT-driverével (led_strip_clear -> refresh), majd
    led_strip_del + ws2812_data_low (GPIO21 OUTPUT LOW) + gpio_hold. Új managed comp függőség:
    main/idf_component.yml (espressif/led_strip ^3.0.0).
    - Debug-kapcsolók a fájl tetején (mind 0 = éles), a jövőbeli hibakereséshez megtartva:
    DEBUG_KEEP_USB_ALIVE (pad-off kihagyása -> stabil USB-log ciklikus ébredésnél),
    DEBUG_LED_BLINK (WS2812 piros<->sötét villogtatás -> a driver+pin él-te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
2026-07-02 docs(pivot): master board ESP32-S3-Zero → ESP32-C3 SuperMini — minden érintett doksi átírva
    - A master board a bizonyított node-boardra (ESP32-C3 SuperMini) vált, elvetve az
    eredetileg tervezett ESP32-S3-Zero-t. 8 doksi átírva:
    - MEMORY.md: 4. (frissítés-dátum + pivot-jelzés), 7. rendszerarchitektúra
    (vételi pipeline egymagosra, perzisztencia PSRAM→EEPROM, táp-módok, boardok-sor,
    nyitott kérdés #2), 8. új H4-eredmény-blokk, 8./M1 anomália-sor „végleges HW".
    - docs/new_base_components.md: Master BOM board-sora; „PSRAM mint tömeg-puffer"
    szekció → „Napi puffer az EEPROM-ban"; EEPROM-checkpoint tartalom (napi puffer is);
    master táp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
    [alkatreszek.csv]
2026-07-02 feat(RG): esőmérő reed-impulzus kísérlet-mappa (WH-SP-RG tipping bucket) — buildel MODE0+MODE1
    MIT: új experiments/RG_rain_gauge_pulse/ periféria-szenzor kísérlet a WH-SP-RG
    (MS-WH-SP-RG) önkiürülő billenővödör esőmérő reed-impulzusainak kiolvasásához/
    számlálásához a node-on (ESP32-C3 SuperMini). A H1/H2 firmware-mintát követi:
    - main/rg_rain_gauge_pulse.c — két mérési mód (RG_MODE), paraméterek a fájl tetején
    (RG_PIN=GPIO4, RG_DEBOUNCE_MS=150, RG_MM_PER_TIP=0.2794, RG_TIP_WINDOW_MS=200):
    MODE 0 = padi kalibráló/bounce (GPIO-él-ISR + SW-debounce, élő TIP-log)
    MODE 1 = deep-sleep wake-on-tip (RTC_DATA_ATTR számláló, level-LOW gpio_wakeu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
2026-07-02 feat(RG): MODE 0 „csak kiírás" első kör — éles C3-on igazolva bootol + helyes pin-szint
    MIT: a RG_MODE 0 leegyszerűsítve/finomítva az első körre (a user kérése: egyelőre
    semmi más, csak írja ki serialre amit mér). run_calibration_mode -> run_print_mode:
    - induláskor: setup-log + a pin KEZDŐ szintje (gpio_get_level), hogy a bekötés azonnal látszik
    - minden billenés: "TIP #n +0.2794 mm -> össz X mm (pin, t=uptime s)"
    - ~10 s-onként ÉLETJEL ("...figyelek, pin=1, eddig n tip"), hogy billenés híján is lásd: fut
    A GPIO-él-ISR + 150 ms SW-debounce változatlan. Deep-sleep MODE 1 érintetlen (későbbre).
    MIÉRT: billenés nélkül a régi MODE 0 néma volt -> nem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
2026-07-03 docs(pivot-revert): master HÁLÓZATI TÁP → S3-Zero visszaáll (dual-core) + always-on architektúra átvezetve
    - A 2026-07-02-i C3-pivot (97e5b3e) VISSZAVONVA: a master board újra ESP32-S3-Zero
    (dual-core + 2 MB PSRAM). git revert 97e5b3e + rárakott always-on réteg, 10 fájlon.
    - Új hard-döntés: a master HÁLÓZATI TÁPOT kap → always-on (sosem alszik), folyamatos
    WiFi + ESP-NOW. Ennek átvezetése:
    - MEMORY.md 7.: pipeline always-on note, perzisztencia (PSRAM most már csak
    felhő-kimaradás elleni tartalék), táp = HÁLÓZATI (az akkus B-mód elesik), boardok-sor,
    ÚJ bullet a timing-réteg egyszerűsödéséről; nyitott kérdés #2 tárgytalan, #4 tűzz-és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
    [alkatreszek.csv]
2026-07-03 docs(D1-D4): egyidejű WiFi/ESP-NOW üzem + Sz2b chunk + tiszta hálózati táp + hibrid mérő-master
    MIT (2026-07-03-i döntések átvezetése 7 fájlon + 1 új chunk)
    - D1: a master egyidejű WiFi STA + ESP-NOW üzeme a terv (validálandó, fallback ablakos).
    - D2: az M1 87,9% csomagvesztés-anomália kivizsgálása → új Sz2b chunk.
    - D3: master TISZTA hálózati táp (5V adapter → 5V→3.3V konverter, akkus áthidalás NINCS).
    - D4: master HIBRID — maga is mér (saját unit_id); a DS3231 RTC-modul törölve.
    MEMORY.md
    - Fejléc: D1–D4 tömör összefoglalója.
    - 1. + 7. felütés: „a kód még előttünk áll" / „Kód még nincs" javítva a valós állapotra
    (H1/H2/Sz2/M1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
    [alkatreszek.csv]
2026-07-03 feat(firmware/node): node-firmware VÁZ felállítva — fordul (RAM 3.0% / Flash 17.2%)
    Az első node teljes firmware-vázának felállítása a firmware/ alatt (eddig üres volt).
    17 fájl, tiszta ESP-IDF layout, PlatformIO-val fordítva (board=esp32-c3-devkitm-1,
    framework=espidf). Modulszerkezet:
    common/protocol.h — az Sz2 wire-szerződés (sz2_payload_t + CRC16-CCITT) 1:1
    átvéve; BEFAGYASZTOTT kontraktus, a master ugyanezt olvassa.
    node/CMakeLists.txt, platformio.ini, sdkconfig.defaults — M1 node build-mintából.
    node/main/node_config.h — ÖSSZES hangolható paraméter egy helyen: NODE_PROFILE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
2026-07-03 fix(firmware/node): HX711 pin-korrekció a casing tényleges bekötésére (SCK 5->4, DT 6->3)
    A casingbe beépített mérleget fizikailag NEM lehetett a H1/H2 tervezett GPIO5/6 lábakra
    kötni; a tényleges huzalozás: HX711 SCK=GPIO4, DT(DOUT)=GPIO3. A node_config.h ezt vezeti át.
    Mindkét láb a VDD3P3_RTC tartományban (GPIO0..5) -> a PD_SCK deep-sleep HIGH-hold (gpio_hold)
    továbbra is működik.
    KÖVETKEZMÉNY — vbat ADC áthelyezés: a vbat ADC eddig GPIO4-en volt, ami most a HX711 SCK ->
    ütközés. Az ADC1 lábak (GPIO0..4) közül GPIO4(SCK)/GPIO3(DT) foglalt, GPIO2 strapping ->
    a vbat ADC GPIO1-re (ADC1_CH1) került. A vbat-osztó fizikailag még nin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
    [node_config.h]
2026-07-03 fix(firmware/node): vbat ADC GPIO1 -> GPIO0 (a 0-4 oldalon ez a fizikailag elérhető láb)
    A 0-4-es board-oldal fizikailag rosszul hozzáférhető; ebből GPIO0 az, amit a user még elér.
    A vbat ADC kényszerűen a 0-4 oldalra esik: a C3-on CSAK az ADC1 (GPIO0..4) megbízható —
    az egyetlen 5..10 oldali ADC-láb a GPIO5 (ADC2_CH0), de az ADC2 oneshot módban a C3-on
    HW-korlátos ("no longer supported"), WiFi-vel ütközik, errata "may not work correctly"
    (Espressif ESP-IDF dok). Ezért éles vbat-hoz ADC1 kell. GPIO4/3 (HX711) és GPIO2 (strapping)
    foglalt/kizárt -> marad GPIO0.
    A NEM-ADC új elemek az elérhető 5..10 oldalon: vbat NPN-kapcsoló=GPIO7, DS18B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
    [node_config.h]
2026-07-03 tweak(firmware/node): vbat osztó 100k/100k -> 10k/10k, 100nF kondi elhagyva, settle 30->10 ms
    A vbat feszültségosztó ellenállásai 100k/100k helyett 10k/10k. Indok: az osztót az NPN
    KAPCSOLJA (alvásban 0 szivárgás mindkét értéknél), így a "nagy R a nyugalmi szivárgás ellen"
    érv tárgytalan -> a kisebb R jobb ADC-pontosságot ad. 10k/10k -> Thévenin 5 kΩ, ami az
    Espressif ~10 kΩ forrásimpedancia-ajánlás ALATT van -> az ADC S/H kondenzátor gyorsan
    feltöltődik, pontos mérés KONDI NÉLKÜL is. A mérés-alatti ~210 µA elhanyagolható a node
    aktív fogyasztásához (HX711 ~5 mA, rádió tíz-mA) képest.
    100 nF ADC-puffer ELHAGYVA: (1) a Th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
2026-07-03 tweak(firmware/node): vbat NPN-kapcsoló GPIO7 <-> DS18B20 GPIO10 csere (bekötés-kényelem)
    A vbat NPN-kapcsoló és a DS18B20 1-Wire lába felcserélve: NPN GPIO7 -> GPIO10,
    DS18B20 GPIO10 -> GPIO7. A fizikai bekötés így kényelmesebb a usernek.
    Technikai akadály nincs: mindkét láb sima általános digitális IO a C3-on, egyik sem
    strapping (GPIO2/8/9), egyik sem ADC (ADC1=GPIO0..4). Az NPN-nek csak digitális HIGH/LOW
    kell (alvás/reset input-default -> NPN magától zár -> osztó lekapcsol), a DS18B20 open-drain
    1-Wire + felhúzó bármelyik szabad GPIO-n megy.
    Végleges node pin-terv: HX711 SCK=GPIO4/DT=GPIO3, vbat ADC=GPIO0 + NPN=GPIO10,
    DS18B20=GP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
    [node_config.h]
2026-07-03 feat(firmware/node): valódi HX711 + vbat + ESP-NOW driverek (stubok lecserélve) + mért adat a logra
    - sens_hx711.c: valódi bit-bang olvasás + power-path a H2 (DATA-MONITOR) / M1b éles-mért
    kódjából portolva, a firmware pin-tervére igazítva (PD_SCK=GPIO4, DOUT=GPIO3). power_up/down,
    read_raw (25 SCK, A/gain128, 2's complement), read_weight (HX711_SAMPLES átlag, kalibrálatlan).
    Deep-sleep GPIO-hold: power_down HIGH-hold, init() a hold feloldása (M1b tanulság a timer-wake utáni beragadásra).
    - sens_vbat.c: valódi adc_oneshot (ADC1, GPIO0, 12 dB) + curve-fitting kalibráció + NPN-kapcsoló
    (GPIO10), enable->settle->N átlag->*ratio->disable. Kalibráció-hiba eset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
2026-07-04 fix(firmware/node): hx711_power_up() GPIO-hold feloldás — power_down→power_up reboot nélkül is működik
    MIT: a sens_hx711.c hx711_power_up() elejére bekerült a gpio_hold_dis(HX711_PD_SCK_GPIO)
    + gpio_deep_sleep_hold_dis() páros.
    MIÉRT (tünet → gyökérok → megoldás):
    - Tünet: a BENCH fázis-szekvencer 6. fázisában (ESPNOW_TX — friss mérés power_up-pal a
    broadcast előtt) a HX711 olvasás DOUT-timeouttal 0-t adott, pedig a 2. fázisban (HX711)
    még jól mért.
    - Gyökérok: a hx711_power_down() GPIO-holdot tesz a PD_SCK-ra (HIGH-ban fagyasztja — ez
    AKTÍV, ébren módban is fogja a lábat, nem csak deep sleepben). A holdot eddig CSAK a
    hx711_init() oldotta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
    [sens_hx711.c]
2026-07-04 docs(MEMORY): BENCH — első fogyasztásmérés a TELJES node-elektronikán + TPS63000-M PFM-fix (alvóáram 3,2 mA → 750 µA)
    MIT: a MEMORY.md 8. szakaszába új BENCH-blokk a 2026-07-04-i mérési eredményekkel;
    fejléc-dátum frissítve; az elavult „firmware/ még üres" állítások (1., 7., 9. szakasz)
    a tényleges állapotra igazítva (firmware/node áll, master-firmware hiányzik).
    MÉRÉS (első a teljes, összeszerelt elektronikán, akkuról):
    - Setup: 18650 → TP4056 → TPS63000-M buck-boost → 3,3 V; DMM az akku + ágában,
    log nélkül (stopper + áram-lépcsők, BENCH fázis-szekvencer 20 s-os fázisai).
    - Lépcsők: baseline 20 mA; HX711 24,6 mA (+4,6 mA — egybev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
2026-07-04 fix(experiments/H1): a TELJES node extra lábai alvásra — vbat NPN(GPIO10) LOW+hold, DS18B20(GPIO7) input
    - A H1 deep-sleep váz eddig CSAK a HX711-et (PD_SCK=GPIO4, DOUT=GPIO3) és a user LED-et
    (GPIO8) konfigurálta — mert eredetileg a csupasz boardot mérte. A node_config.h szerinti
    TOVÁBBI aktív lábak (vbat-osztó NPN-kapcsoló, DS18B20) definiálatlanul maradtak, pedig
    most a teljes, összeszerelt elektronikán fut ez a deep-sleep kód.
    - Új #define-ok (a firmware/node/main/node_config.h-val egyezően): VBAT_SW_GPIO=GPIO10,
    DS18B20_GPIO=GPIO7.
    - Új extra_peripherals_sleep_safe(): a vbat-osztó NPN bázisát (GPIO10) EXPLICIT LOW-ra hajtja
    (output), a DS18B20 adat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
    [h1_node_board_prep.c]
2026-07-05 feat(experiments/Sz6): ébredés→megszólítás→átadás protokoll bench — v1 firmware + USB-tooling
    MIT: új Sz6_wake_handoff kísérlet, tisztán az ESP-NOW master↔node kommunikációra
    (semmi periféria, mérés szimulálva, RÖVIDÍTETT 12 s-os alvásciklus):
    - node/ (ESP32-C3 SuperMini, env node1/node2 -DSZ6_NODE_ID-vel): deep sleep ébredés →
    pre-TX jitter → DATA (broadcast discovery → ACK-ból tanult master MAC-re unicast,
    RTC-ben őrizve) → app-ACK várás (120 ms timeout, 5 próba, retry-jitter, 2 unicast
    után broadcast-fallback) → gép-grep-elhető "SZ6 CYCLE" sor → deep sleep (±1 s jitter).
    seq/boot_id RTC_DATA_ATTR — a seq sikertelen ciklusnál IS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
    [catch_bootloader.py, serial_logger.py]
2026-07-05 fix+diag(experiments/Sz6): reset-mentes soros logger + node2 RF-diagnosztika (RX ép, TX degradált)
    - tools/serial_logger.py — RESET-MENTES port-nyitás (az esp-idf-monitor --no-reset receptje):
    nyitás előtt DTR=RTS=assert /az (1,1) sosem resetel/, nyitás után ELŐSZÖR RTS, majd DTR
    elengedés — így sosem megyünk át a (DTR=0,RTS=1) reset-állapoton. + csak átmenet-log
    (a sikertelen újranyitási próbák nem spammelik a logot).
    - node: SZ6_RXTEST build-mód (env node2rx) — promiscuous sniffer diagnosztika (Sz2-minta);
    SZ6_TX_POWER build-flag (node2: 34 = 8,5 dBm teszt); a SZ6 CYCLE sor 3× ismételve a
    linger-ablakban (a USJ-konzol host-open előtti kimenete el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
    [serial_logger.py]
2026-07-05 feat(experiments/Sz6): PASS — megbízható wake→megszólítás→átadás protokoll validálva (2 node, ~2 h, 0 vesztés)
    - node2 TX-power fix: SZ6_TX_POWER=34 (8,5 dBm) a node2 env-ben — a 21 dBm-es adás a
    példány antenna-illesztési hibája miatt torzított (~4% kézbesítés), 8,5 dBm-en 100%.
    - Node linger 700 ms → 2000 ms + CYCLE sor 5× ismételve (SZ6_CYCLE_LOG_REPEAT): a macOS
    USB-enumeráció ~1 s a wake után, a host-logger csak utána nyithat — így a node-log
    reset nélkül, élőben elkapható (igazolva). Éles profilban majd radikálisan csökken.
    - serial_logger.py: 50 ms-es port-felbukkanás poll (az awake-ablak korai elkapása).
    - README: teljes proto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
    [serial_logger.py]
2026-07-05 Minimalis KiCad IPC API csatlakozas-teszt.
2026-07-05 feat(experiments/Sz2b): v1 firmware — csatorna-scan discovery (node) + WiFi STA réteg (master)
    MIT: az Sz6 PASS-kód (wake→megszólítás→átadás) adaptációja az Sz2b koegzisztencia-benchhez,
    az experiments/Sz2b_coexistence_packet_loss/ alá:
    - node/main/sz2b_node.c: az Sz6 node + ÚJ csatorna-követő réteg. A master STA-üzemben az AP
    csatornáján ül (1..13, előre nem ismert) -> a node RTC-ben cache-eli a talált csatornát
    (rtc_channel, deep sleepet túléli, power-on nulláz), és ha (a) nincs cache vagy (b)
    SZ2B_RESCAN_AFTER_FAILS=2 egymást követő ciklus ACK nélkül zárult, akkor MÉG UGYANABBAN
    a ciklusban 1..13 csatorna-scant futtat (csatornánként broadca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
2026-07-05 refactor(modeling): enclosure áthelyezés modeling/ alá + gitignore path-frissítés
    Mit: a wireless_scaling/enclosure/ teljes tartalma átkerült a
    wireless_scaling/modeling/enclosure/ alá (git rename-ként detektálva, 10 fájl:
    kód, README, datasheet PNG-k, requirements). A .gitignore path-jai igazítva az
    új struktúrához.
    Miért: a felhasználó átrendezte a projekt mappastruktúráját — a modellezési
    munka (enclosure CAD + a KiCad PCB projekt) egy közös modeling/ gyökér alá
    kerül.
    .gitignore változás:
    - enclosure/export/ -> modeling/enclosure/export/ (a generált CAD export
    ~6 MB STL/STEP/PNG/FCStd — az enclosure.py reprodukálja, nem verziózzuk; a
    régi sza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
2026-07-05 feat(tools/kicad_ipc): perfboard generátor IPC API-n + a generált PCB_layout projekt
    Mit: make_perfboard.py — a futó KiCad PCB Editor nyitott board-jára az IPC
    API-n (kipy) keresztül legenerál egy szokásos 2,54 mm raszterű, átmenő furatos
    (PTH) próbapanelt. Paraméterezhető (--w --h --pitch --pad --drill --margin),
    idempotens (induláskor törli a board footprintjeit és rajzolt alakzatait, majd
    újraépít). Mellette a legenerált PCB_layout KiCad projekt (60x40 mm, 22x14 =
    308 furat, 4 kontúr-szakasz az Edge.Cuts-on).
    Miért: proof-of-concept — igazolni, hogy a kipy IPC-n át nem csak csatlakozni,
    hanem PCB-t szerkeszteni is tud a KiCad 10.0.4-ben. Kiegészíti a korábbi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
    [PCB_layout.kicad_pcb, PCB_layout.kicad_sch]
2026-07-05 docs(PCB_modeling): útmutató ágenseknek a KiCad IPC API-s (kipy) tervezéshez
    Mit: wireless_scaling/modeling/PCB_modeling/README.md — részletes, akcióképes
    belépő a következő ágenseknek a programozott KiCad-szerkesztéshez. Tartalom:
    környezet (venv, kipy 0.7.1, egységek), a csatlakozás előfeltételei, API-alapok,
    az élesben tapasztalt buktatók táblázata, PTH-pad/footprint/Edge.Cuts recept,
    ajánlott munkamódszer-hurok, KiCad projektfájl-kezelés (bázisnév-egyezés, git),
    ismert korlátok, eszközök.
    Miért: a session-ben szerzett, dokumentálatlan tapasztalatok rögzítése, hogy a
    következő ágens ne fusson bele ugyanabba (nyitott-szerkesztő követelmény,
    kö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
2026-07-05 feat(PCB_modeling): node premade modulok footprint-generatora (kipy IPC)
    Mit: uj tool `wireless_scaling/tools/kicad_ipc/make_node_modules.py`, ami a
    node-panel 4 premade breakout-moduljanak footprintjet rakja a nyitott KiCad
    PCB Editor-ba, elrendezes-tervezeshez ("pakolashoz"). Minden modul egy
    FootprintInstance: fizikai kontur = BoardRectangle a F.Silkscreen-en (a
    modullal egyutt mozog), a labak PTH padek a valos funkcionevekkel.
    Modulok + meret-forras (webkutatas 2026-07 + docs BOM):
    - ESP32-C3 SuperMini 18x22,5 | 2x8 @2,54, sortav 15,24 -> MAGAS biztonsag
    - HX711-M (piros) 16x24 | 6+4 @2,54, sortav ~13 -> kontur kozepes, geom. becsult
    - TP4056-PROT-USB-C 17,3x29 | NEM r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
2026-07-05 feat(PCB_modeling): meretaranyos 3D board-blokkok a node-modulokra (kipy IPC)
    Mit: uj tool `attach_module_models.py` + 4 generalt STEP-blokk
    (`modeling/PCB_modeling/3dmodels/`). A script build123d-vel legyart minden
    node-modulhoz egy meretaranyos teglatestet (kontur Sz x H x becsult magassag,
    z=0..H a board fole), majd a MAR felrakott footprintekre koti oket Footprint3DModel-lel.
    A KiCad 3D nezeteben (Alt+3) a modulok igy valodi magassaggal latszanak.
    Miert igy (user-valasztas): a "konkret board"-ra a meretaranyos blokk lett a
    donteshozott irany (gyors, garantalt, nem kell login-falas community 3D modell).
    A blokkok magassaga becsult, tolomeros bemeres utan finomitando:
    ESP32-C3 4,5 | HX7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
2026-07-05 feat(PCB_modeling): furatos 3D blokkok + kozos def + koordinata-fix
    Mit: a 3D board-blokkokra RAKERULNEK a furatok (atmeno lyukak a lab-
    poziciokban), garantalt szinkronban a hordozo-PCB padjaival, ES javitva egy
    rejtett koordinata-hiba a footprint-generatorban.
    1) KOZOS DEFINICIO (uj `node_modules_def.py`): a modul-meretek, magassagok es
    furatok EGY helyen. Hasznalja a footprint-generator (make_node_modules.py)
    es a 3D-blokk-generator (attach_module_models.py) is -> a PCB-pad es a
    3D-furat mindig ugyanabbol a koordinatabol jon. Furat-tipus: "solder"
    (forrpont -> PCB pad + 3D furat) vs "mount" (mechanikai -> CSAK 3D furat,
    a hordozo-PCB-re NEM kerul). Ez a felhasznaloi kikote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
2026-07-05 test+fix(experiments/Sz2b): 3. fázis soak — WiFi/forgalom PASS, node1 dup/miss-vihar → gyökérok: teljes TX-power torzítás
    MIT (P3 soak kiértékelés, 12:12:26–13:15:00, master p3-sta-traffic, logs/master_p3.log):
    - KOEGZISZTENCIA-METRIKÁK (a D1 kérdés magja) — MIND PASS:
    WiFi 1 órán át megszakítás nélkül asszociált (disconn=0), gateway HTTP GET 748/748 =
    100% (~16-21 ms), q_drop=0, len_bad=0, ver_bad=0. A master 4,6 h uptime-nál is stabil
    (gw_ok=3294, gw_fail=2 = 99,94%).
    - node2 (8,5 dBm): 263 ciklus, MISS=0, DUP=0, 100% try=1, RSSI -39 → -57..-62 (a délután
    folyamán távolabb került) — VÉGIG HIBÁTLAN. Ez a bizonyíték, hogy a WiFi-forgalom NEM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
2026-07-05 fix+test(experiments/Sz2b): scan-fix (max-RSSI csatornaválasztás) + TX34 igazolás + 4. fázis PASS (master-reboot, 0 vesztés)
    1) SCAN-FIX (node/main/sz2b_node.c): a csatorna-scan az első ACK-nál NEM áll meg — a teljes
    1..13 sweep-et végigméri, ACK-onként rögzíti az RSSI-t (recv_cb-be új s_ack_rssi), és a
    sweep végén a LEGERŐSEBB ACK-jú csatornát cache-eli. Csatornaváltáskor a szemafor ürítése
    (elkésett ACK ne számítson bele a következő csatorna ablakába). MIÉRT: a P3-ban a node1
    bizonyítottan a ch7-et tanulta ("scan OK: csatorna=7"), mert a master ch8-as ACK-ja a
    szomszéd csatornán is dekódolható volt — a valódi csatornán az ACK s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
2026-07-06 test(experiments/Sz2b): ✅ D1 VALIDÁLVA — záró soak PASS (0 gap, 0 dup, 5,7 h) + README-összefoglaló + C3-sniffer env
    1) ZÁRÓ SOAK (18:32–19:38, 66 perc, javított firmware: TX34 mindkét node + max-RSSI
    scan-fix): node1 276, node2 278 ciklus — 0 gap, 0 dup, 100% try=1; WiFi 0 disconnect;
    gateway HTTP GET 791/796 = 99,4%; q_drop=0. A node1 átlag -84 dBm-en (min -90!) is
    hibátlan — a protokoll a vételi küszöb közelében is stabil.
    KITERJESZTETT FUTÁS (estig, 23:07-ig, 4,6 h): node1 1162 / node2 1172 ciklus,
    TOVÁBBRA IS 0 gap, 0 dup; 0 disconnect; GET 3284/3293 = 99,7%.
    -> MINDEN PASS-KRITÉRIUM TELJESÜL. D1 lezárva: az egyidejű WiFi STA + ESP-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
2026-07-06 feat(experiments/Sz2b): rssi_probe — 1-boardos antenna-diagnosztika telnet/UDP RSSI-riporttal
    MIT: új rssi_probe alprojekt (közös forrás, két env: s3zero / c3super) + tools/rssi_listen.py
    host-oldali UDP-hallgató. A firmware STA-ként a dlink-EDA4-re csatlakozik (a master gitignorolt
    creds.ini-jét húzza be extra_configs-szal, SZ2B_WIFI_SSID/PASS — nincs creds-duplikáció), és
    másodpercenként greppelhető 'PROBE ...' sort küld három csatornán: soros konzol, telnet (:23,
    max 4 kliens), UDP-broadcast (:5005). Csúszóablakos avg10/min10/max10 (10 minta), disc-számláló,
    DISCONNECTED-re azonnali reconnect (backoff nélkül — a probe-ot szándékosan visszük jel-határig).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
2026-07-06 docs(experiments/Sz2b): S3-Zero antenna-gyanú MEGDŐLT — rssi_probe távolság-mérés
    MIT: a README 4. tanulságát (S3-Zero link-budget deficit, NYITOTT) átírtam a rssi_probe
    kontrollmérés eredményére, és a Nyitott pontoknál a C3↔C3 sniffer-tételt lezártam
    (másképp, egyszerűbben elvégezve).
    MIÉRT: a P3-ban ~30-40 dB deficit gyanúja merült fel az S3-Zero kerámia-antennájára, ami
    külső antennás master-boardot (u.FL) indokolt volna az egész csillagra. A node↔master
    mérésben azonban KÉT ismeretlen antenna van; a rssi_probe ezt kizárja: mindkét board
    STA-ként ugyanahhoz a routerhez (dlink-EDA4) mér.
    MÉRT ADATOK (2026-07-06, telnet :23, ch8, disc=0 mindke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
2026-07-08 feat(experiments): HX711 nyers-olvasó soros teszt C3 SuperMini + S3 devkit
    Két breadboard-teszt a HX711 24 bites nyers érték kiolvasására, könyvtár
    nélküli közvetlen bit-bang megoldással (A csatorna, 128× erősítés, 25.
    impulzussal a következő olvasás beállítva). Nyers érték 200 ms-onként a
    Serial monitorra, 115200 baudon.
    - experiments/hx711_c3_serial_test/ — ESP32-C3 SuperMini, DT=GPIO3, SCK=GPIO4.
    platformio.ini: generikus esp32-c3-devkitm-1 board (nincs dedikált SuperMini
    def, 4 MB flash egyezik). USB CDC a natív USB-Serial-JTAG-on:
    ARDUINO_USB_MODE=1 + ARDUINO_USB_CDC_ON_BOOT=1 (a C3-on csak HWCDC van).
    - experiments/hx711_s3_serial_test/ — ESP32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
2026-07-09 firmware: document master temperature probes
2026-07-09 node: document power debug and sleep handling
2026-07-09 firmware: add final master firmware v1
    Adds the first final master firmware project under wireless_scaling/firmware/master for the ESP32-S3-Zero. The project has PlatformIO ESP-IDF envs for a local baseline build and a cloud build, a 4 MB flash partition table with a large data partition named backup, a gitignored cloud_config.h workflow, and concise README usage notes.
    The firmware implements the master v1 plan: WiFi STA plus ESP-NOW receive pipeline, CRC/seq dedup and gap accounting for node packets, unicast app ACK compatibility, raw HX711 upload semantics, master self-measurement every 20 minutes on unit_id 0, DS18B20 role handling for ds0 hive probe and ds1 scale calibration temperatur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
    [partitions.csv]
2026-07-10 firmware: sync node master handoff
    [partitions.csv]
2026-07-10 firmware: fix node hx711 pins
    [node_config.h, sens_hx711.c, sens_hx711.h]
2026-07-10 firmware: durability hardening — node pending queue state2, master backup ring V2, review+rebuild validálva
    MIT: A d99e0ed utáni megbízhatósági javítások commitja (részletes leírás:
    firmware/FIRMWARE_HANDOFF_2026-07-10.md). Fő elemek:
    - Node: NVS pending queue új state2 állapotgéppel (NBF2 magic, CRC16,
    next-head==count invariáns), power-loss-biztos enqueue/clear sorrend
    (record commit -> state2 commit -> RAM), orphan adopt + FRONT_REPAIR,
    legacy head/next/count migráció fail-closed hibakezeléssel; nodebuf
    partíció 64->80 KiB (512 rekord, ~7,1 nap backlog 20 perces periódussal).
    - Node: mérés + tartós commit MINDIG rádió/HELLO előtt; exact-match DATA
    AC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
    [partitions.csv]
2026-07-10 firmware: review-találatok javítása — master ring wrap-kapacitás, peek read-hiba, HX711 kritikus szekció, node init panic-hurok
    - master.c backup_prepare_head_unlocked: ring wrap után a stale (előző köri,
    konzumált) szektor szektorhatáron pending backlog mellett is törölhető, ha
    a tail nem esik a szektorba. Az orphan-adopt (write_seq == state+1) továbbra
    is ELŐBB fut, így indexeletlen teljes slot nem törölhető; a tail-szektor
    védelme és a mid-sector váratlan slot fail-closed refuse-a változatlan.
    A refuse ág mostantól lépteti a s_backup_full diagnosztikát.
    - master.c backup_peek: az esp_partition_read hibája (transient flash hiba)
    többé NEM p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
    [main.c, master.c]
2026-07-10 firmware(node): tele-queue enqueue-retry drain után + korlátos ESP-NOW NO_MEM retry
    - main.c run_field: ha az ébredés eleji enqueue ESP_ERR_NO_MEM-mel hasalt el
    (512-es pending queue tele), és a drain az ébredésen belül helyet
    szabadított fel, a friss minta enqueue-ja megismétlődik. A payload seq-je
    érvényes marad: a drain/clear a headet lépteti, a s_next változatlan, az
    enqueue szigorú seq==s_next kontraktja teljesül.
    - espnow_tx.c send_bytes_serialized: a korábbi végtelen for(;;) NO_MEM retry
    helyett korlátos ciklus (NODE_NO_MEM_MAX_RETRY=100, node_config.h), utána
    WARN log + false — a hívó oldali drain/sleep út zárja a ciklust.
    - Tele q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
2026-07-10 firmware(master): explicit DS18B20 ROM->szerep mapping infrastruktúra
    MIT: DS18B20_ROM_HIVE / DS18B20_ROM_SCALE config define (master.c, #ifndef —
    -D build flaggel is felülírható). Ha ki van töltve (16 nagybetűs hex a boot
    log "DS<n> ROM=..." formátumában), a ds18b20_apply_role_mapping a keresés
    után az adott ROM-ú szondát a megfelelő indexre cseréli (0 -> hive_c,
    1 -> scale_c). Üres string (default) = a korábbi viselkedés: qsort(memcmp
    ROM) index-sorrend. Ha a konfigurált ROM nincs a buszon: WARN log +
    index-fallback. A boot log mostantól a szerepet is mutatja:
    "DS<n> ROM=... role=hive_c|scale_c|extra".
    MIÉRT: a handoff residual kockázata — a szerep a lexikografiku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
2026-07-11 firmware: preserve sensor diagnostic faults
2026-07-11 firmware(master): local status HTTP-lap ERR_EMPTY_RESPONSE javítása (web_sendf buffer túlcsordulás)
    - web_sendf(): a formázó buffer 640 -> 1600 byte.
    - A csonkolási ág (n < 0 || n >= sizeof(line)) mostantól ESP_LOGE-vel
    hangos: "web_sendf truncated (need %d, buf %d) -> failing request".
    MIÉRT (tünet -> gyökérok -> megoldás):
    - Tünet: http://<master_ip>/ -> ERR_EMPTY_RESPONSE telefonról is, a
    WiFi-re csatlakozva. A master elérhető (TCP connect OK), de válasz
    nélkül bontja a kapcsolatot. Teljesen hálózat-független volt.
    - Serial-bizonyíték minden lapfrissítésnél:
    W httpd_uri: uri handler execution failed
    W httpd_txrx: httpd_sock_err: error in re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
    [master.c]
2026-07-11 firmware(master): local status lap crash javítása — hiányzó % a PRIu32 makrók elől (LoadProhibited)
    - web_status_handler node-soros web_sendf formátumában a 4 db PRIu32
    makró elé bekerült a hiányzó "%":
    "<td>" PRIu32 -> "<td>%" PRIu32
    "<td>" PRIu32 "/" ... "/" -> "<td>%" PRIu32 "/%" PRIu32 "/%" PRIu32
    - Tünet: a nodeok szépen csatlakoznak (serial: NSTAT node=1/2/3, rxcb=6),
    de a local host lap "egyik se csatlakozott"-ot mutat. A master
    ~90-100 s uptime-nal Guru Meditation Error: Core 0 panic'ed
    (LoadProhibited), EXCVADDR=0x8c, A2=0x8e, majd reboot.
    - Backtrace (addr2line, ELF SHA 1e668ace7 == f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
    [master.c]
2026-07-11 firmware(master): local status lap "beragad" javítása — httpd LRU-purge + több socket
    - web_status_start httpd config:
    config.max_open_sockets: 2 -> 4
    config.lru_purge_enable = true (uj)
    - Tünet: a lap node-okkal betolt (crash mar megszunt), de a meta-refresh
    NEM frissul; a tartalom beragad (pl. lekapcsolt node is ONLINE marad,
    age_s nem no). Csak master reset "oldja" atmenetileg.
    - Gyökérok: a bongeszo keep-alive TCP kapcsolatokat tart nyitva idle-ban
    is, ezenfelul /favicon.ico-t is ker (nincs regisztralva -> foglal egy
    slotot). max_open_sockets=2 igy gyorsan betelik. Alapbol
    lru_purge_enable=false (HTTPD_DEFAULT_C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
    [master.c]
2026-07-11 docs(memory): master-firmware éles státusz + flash-workflow/USB üzemeltetési tudás (10. szakasz)
    - MEMORY.md fejléc: 2026-07-11 bejegyzes — master-firmware eles, teljes
    flotta (master + 3 node) terepre flashelve, local host 3 bugja javitva.
    - 1. es 9. szakasz: a korabbi "master-firmware ures/hianyzik" allitas
    frissitve — a firmware/master mostmar eles es tereptesztelt (prod env
    esp32-s3-zero-local-status: cloud + helyi HTTP statuszlap); node env-ek
    felsorolva.
    - Uj 10. szakasz "Firmware flash-workflow + gep-specifikus USB":
    * Deep-sleep node flashelese: USB-JTAG alvas alatt lekapcsol -> port
    eltunik; workflow = bootloader mod + elofordit + port-figyelo azonnali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
2026-07-11 frontend(dashboard): új, multi-telepítéses webapp első verziója — preview channelen
    - Új, önálló dashboard webapp a `dashboard/` alatt (a régi prototype/public live
    frontendet NEM érinti). Vanilla HTML/CSS/JS, build-lépés nélkül, ES-modul CDN-ről
    (Firebase SDK 12.4) + ECharts 5.5.1 (UMD) a chartokhoz.
    - Config-vezérelt adatréteg (`public/config.js`): a hive-ok és mérőegységek
    deklaratívan leírva → multi-telepítésre felkészítve (új hive/node = config-bejegyzés,
    kód-módosítás nélkül). Két telepítés bekötve:
    * hive1 (régi, kalibrált kg): rods/w1,w2 {ts,w}, env {t,h}, temp {t}
    * hive2 (új wireless, nyers): rods/master,node_1..3 {weig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
2026-07-11 frontend(dashboard): fő súly-chart minden mérleggel + placeholder kg + timeline-slider
    MIT (a user visszajelzése alapján teljes nézet-átépítés)
    - A kártya+drill-down koncepció ELVETVE. Helyette a telepítés-nézet fő eleme egy
    nagy SÚLY-CHART, amin az adott telepítés ÖSSZES mérlegének görbéje egyszerre
    látszik (kg-ban), közvetlenül — nem kattintás mögé rejtve.
    - Timeline-slider (ECharts dataZoom 'slider' alul) + kétujjas 'inside' zoom → az
    EGÉSZ betöltött történet böngészhető; "⟲ Teljes nézet" gomb chartonként.
    loadLimit 1000 → 5000 (hosszabb timeline egy lekérésben).
    - hive2 raw → PLACEHOLDER kg-normalizálás egységenként (config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
2026-07-11 fix(dashboard): kétujjas pinch-zoom TÉNYLEGES javítása (belső canvas touch-action + iOS gesture)
    Tünet: mobilon a kétujjas pinch/zoom SOSEM működött (a korábbi verzióban sem);
    az előző commit ráadásul rosszul értelmezve KI is kapcsolta touch-on. Ez rossz volt.
    Gyökérok: az ECharts a chart-divbe egy belső <canvas>-t rak, aminek a
    touch-action-je 'auto' maradt (a CSS-t csak a külső .chart divre tettük). Így a
    kétujjas gesztust a BÖNGÉSZŐ (iOS Safari) elkapta oldal-zoomnak, és sosem jutott
    el az ECharts inside dataZoom-jához. Ráadásul iOS Safari a pinchre 'gesturestart/
    change' eseményt is lő, ami a touch-action mellett is oldal-zoomot csinálhat.
    Megoldás: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
2026-07-11 feat(dashboard): fotó-szerű 2D pinch-zoom (X+Y), csúszka + tooltip törölve
    Felhasználói kérés: a chart úgy nagyítható/mozgatható legyen ujjal, MINT EGY FOTÓ.
    Nem kell alsó csúszka, és nem kell érintésre értéket kiíró tooltip.
    Változás (chartOption):
    - Két inside dataZoom: egy az xAxis-ra, egy az yAxis-ra → kétujjas pinch mindkét
    tengelyen zoomol, egyujjas húzás mindkét tengelyen pan (fotó-szerű 2D roam).
    filterMode:'none' → csak a látható ablak mozog, adatot nem dobunk el.
    - Az alsó 'slider' dataZoom TÖRÖLVE (nincs csúszka). grid bottom 58→24.
    - tooltip.show=false + xAxis/yAxis axisPointer.show=false → érintésre/hoverre
    nincs kereszt é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
2026-07-11 fix(dashboard): zoomnál a vonal mindig a képen marad (X-zoom + auto-Y)
    Tünet: a szabad 2D (X+Y) pinch-zoomnál (filterMode:'none') bele lehetett nagyítani
    egy üres Y-sávba, ahol nincs vonal → "a semmibe" nagyítás, a chartot keresgélni kell.
    Ok: a független Y-zoom egy adat nélküli függőleges tartományra is elvihető.
    Megoldás: az Y NEM szabad-zoomolható többé. Egyetlen inside dataZoom az xAxis-on,
    filterMode:'filter' + yAxis scale:true → a függőleges tengely mindig a LÁTHATÓ
    (kizoomolt) X-ablak adatához igazodik, így a vonal mindig kitölti a képet és nem
    csúszhat ki. Kétujjas pinch = idő-zoom, egyujjas húzás = idő-pan. Csúszka továbbra
    sincs, tooltip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
2026-07-11 feat(dashboard): nagyobb/szélesebb chartok + látható pontok + interpolációs pont-sűrítés
    Három felhasználói kérés:
    1) Nagyobb, szélesebb chart-window (főleg a hőm, ami alacsony volt):
    - style.css: .chart 360→460px, .chart-sm (hőm) 220→340px.
    - Mobil media query (<=640px): .main padding 1rem→.5rem, .panel oldal-padding
    lecsökkentve (.35rem) → a chart majdnem a képernyő széléig ér; magasság
    vh-alapú (62vh / 44vh), hogy kitöltse a képet.
    2) Látható pontok a vonalon (ne csak vonal):
    - lineSeries: showSymbol true, circle, symbolSize 3.5. A downsampling
    (sampling:'lttb') KIVÉVE, mert eldobta volna a beszúrt pontokat.
    3) Interpoláci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
2026-07-11 docs(dashboard): README — az új webapp teljes dokumentációja
    Hol dolgoztunk (dashboard/, dev_02 branch, Firebase preview channel, PROD
    érintetlen), stack (vanilla + Firebase SDK 12.4.0 + ECharts 5.5.1, build nélkül),
    fájlszerep-táblázat, config-vezérelt adatmodell (hive1 legacy kg / hive2 wireless raw).
    Rögzíti a session kulcs-döntéseit és a hozzájuk tartozó "miért"-eket:
    - súly = telepítésenként EGY interpolált össz-vonal;
    - hive2 placeholder "becsült kg" (valódi kalibráció a felhőben, később);
    - hőm-chart = csak AHT20 + szonda (node temp_c / scale_c kalibrációs adat, nem rajzoljuk);
    - fotó-szerű navigáció (X-pinch-zoom, auto-Y, nincs csúszka/toolti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
2026-07-11 feat(calib): HX711 node kalibrációs firmware — súly-stream + off-grid hő-log
    Új önálló kísérleti firmware (experiments/CAL_hx711_calib/, ESP-IDF + PlatformIO,
    board esp32-c3-devkitm-1, env `cal_node`) a felhő-oldali kalibrációhoz szükséges
    NYERS adat kinyerésére. A prod flottát NEM cseréljük: a kalibráció idejére ezt
    flasheljük, majd az éles firmware visszakerül. A prod kódhoz nem nyúltunk — a
    sens_hx711.{c,h} és sens_ds18b20.{c,h} MÁSOLVA a firmware/node/main-ból, csak az
    #include "node_config.h" -> "cal_config.h" cserével (define-nevek megtartva, a
    másolt olvasók változtatás nélkül fordulnak).
    Egy firmware, RUNTIME-vezérelt két móddal (nem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
    [partitions.csv]
2026-07-11 feat(calib): PC-oldali capture/illesztő script (cal_capture.py) + README workflow
    tools/cal_capture.py — a CAL_hx711_calib firmware PC-oldali párja: a soros porton érkező
    nyers adatot gyűjti, illeszti, és cellánként egy közös calibration.json-be írja a felhő-oldali
    konverzió paramétereit. Argparse-alparancsok:
    - weight --port --unit : élő súly-capture. `w` stream, interaktív kg-címkézés (üres=0),
    pontonként `--settle` (4s) alatt medián(count) + mean(scale_c) -> <unit>_weight.csv.
    - temp --port --unit : `d` dump beolvasása a `# DUMP END`-ig -> <unit>_temp.csv.
    - fit --unit : a két CSV OLS-illesztése -> calibration.json (adott unit frissí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
2026-07-12 feat(calib): master-variáns kalibrációs firmware (CAL_hx711_calib_master, S3-Zero, 2 DS18B20)
    Új önálló kísérleti firmware: experiments/CAL_hx711_calib_master/ — a node CAL_hx711_calib
    MASTER-variánsa (ESP32-S3-Zero), env `cal_master`, board esp32-s3-devkitc-1. A keret (soros
    protokoll, callog nyers append-log, boot-listen ablak + AUTOSTART, w/g/d/s/e parancsok,
    USB-Serial-JTAG non-blocking konzol) a node-éval AZONOS; a HW-eltérések alább. A prod
    firmware/master kódhoz NEM nyúltunk — a HX711 olvasó MÁSOLVA a node CAL-ból, a DS18B20 olvasó
    a prod master.c bit-bang + ROM-search logikájából ÁTEMELVE (nem a monolit master.c-t include-oljuk).
    ELTÉRÉSEK A NODE-VA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
    [partitions.csv]
2026-07-13 docs(calib): hőkalibráció végső eredmények + recept (4 cella)
    MIT: új dok experiments/CAL_hx711_calib/data/HOKALIBRACIO_eredmenyek.md —
    a 4 cella (node1/2/3 + master) hőkalibrációjának tanulságai, végső
    paraméterei és a felhő-oldali kalibrációs recept. Semmi kódváltozás
    (a felhasználó kifejezetten csak dokumentálást kért).
    MIÉRT / A FŐ TANULSÁG: TERHELVE kell hőkalibrálni.
    - Terheletlenül (no_load) a node-ok raw(T) görbéje kaotikus
    hiszterézis-hurok: a vízálló gumi membrán dominál (hidegben
    megkeményedik, beragad→elenged), illeszthetetlen.
    - 1 kg előterheléssel a membrán a monoton munkapontra feszül, és
    előjön a load cell tiszta LOG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
2026-07-13 data(calib): súlykalibráció — 4 cella (node1/2/3 + master) count_per_kg + zero_count
    MIT: mind a 4 mérleg-cella súly-kalibrációja lefutott (cal_capture.py weight+fit).
    Új fájlok: 4× *_weight.csv + calibration.json (units: node1, node2, node3, master).
    MODELL: kg = (raw - zero_count - tempCorr) / count_per_kg. A súly-tag (count_per_kg,
    zero_count, refTemp) mostantól VÉGLEGES; a tempCorr külön kezelt (l. hő-nyitottság lent).
    MÉRÉSI RECEPT: terhelt lépcső, a 0 pont KIHAGYVA (üres platform mechanikailag instabil,
    és a kaptár amúgy is mindig terhelt → a zero_count az illesztés interceptje). Kis súlyok
    (~1/3/5/10 kg kombinálva), fel-le, ismétléssel; a 0-10 kg me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
2026-07-13 data(dashboard): súly-kalibráció végleges paraméterei a config.js-be — valódi kg élesítve
    - A 4 hive2 cella calib-blokkjában a súly-paraméterek (eddig null + TODO) kitöltve
    a súly-kalibráció végleges eredményeivel (forrás: experiments/CAL_hx711_calib/
    calibration.json, commit d9896bf):
    node_1: zero_count=20301.43 count_per_kg=-39503.5691 refTemp=27.837
    node_2: zero_count=-186914.47 count_per_kg=-39127.5917 refTemp=28.927
    node_3: zero_count=6298.8 count_per_kg=-40104.2897 refTemp=27.594
    master: zero_count=-660656.85 count_per_kg=-46267.227 refTemp=26.121
    - weightEstimated: true → false (a UI "⚠ becsült kg" jelzése "kalibrált k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
2026-07-13 fix(calib): cal_capture.py — félrevezető operatív node-tempCoef kivezetése a JSON-ból
    - calibration.json / cal_capture.py `cmd_fit`: megszűnt az operatív top-level
    `"tempCoef"` mező (node ÉS master unit_entry-ből is). Helyette:
    - `temp_model` objektum minden unit_entry-ben: HIVATKOZÁS az operatív hő-
    modellre (forrás: data/HOKALIBRACIO_eredmenyek.md, alkalmazva:
    dashboard/public/config.js), a node (log: a*ln((scale_c+c)/(refTemp+c)))
    és a master (lineáris: tempCoef*(scale_c-refTemp), +318 c/°C) leírásával —
    KONKRÉT a/c/tempCoef SZÁM NÉLKÜL, hogy ne legyen 3. másolat a log a/c-ből.
    - `fit.temp` átalakítva: a korábbi `tempCoef`/`ref_1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
    [cal_capture.py]
2026-07-13 docs(memory): hive2 kg-számítás élesítés rögzítése a MEMORY.md-ben (11. szakasz)
    MIT: a 11. (Dashboard) szakasz két pontja frissítve, mert a valóság megelőzte a
    korábbi tervet:
    - A "becsült kg placeholder + felhős kalibráció (Cloud Function) később" pont
    lecserélve a tényleges, ÉLES megoldásra: nincs Cloud Function (Spark tier) →
    a kg-számítás a frontenden (config.js calib=ADAT, app.js unitWeightKg=KÓD),
    node=log / master=lineáris hőkorrekció, hő-param a hőkalibrációból, súly-param
    a súly-kalibrációból (calibration.json, R²>0.9998), weightEstimated:false,
    weightUnit marad "raw". Rögzítve a felelősség-szétválasztás és hogy a
    cal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
2026-07-13 refactor(master): hive2 RTDB séma tisztázása — boards/ + board-szintű temp_c, hive_c az env-be
    MIT (firmware/master/main/master.c + firebase_hive2_rules.md):
    - RTDB-út `hives/hive2/rods/...` → `hives/hive2/boards/...` (node ÉS master upload path).
    - `build_hive2_master_rod_json`: a master board-rekord mostantól `temp_c`-t is ír
    (a DS1/scale_c értékből, REC_VALID_DS1 mellett) — így minden board (node ÉS
    master) EGYSÉGESEN a saját rekordjában viszi a kalibrációs cella-hőjét.
    - `build_hive2_master_env_json`: az env-rekord kap `hive_c` mezőt (DS0, kaptár-szonda,
    KÖRNYEZETI hő) — a levegő/pára/nyomás/eső mellé.
    - A külön `temp` ág MEGSZŰNT: `build_hi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
2026-07-13 feat(dashboard): boards-modell + env-dropdown + 24h eső-csempe (tiszta hive2 sémára)
    MIT (dashboard/public/* + README):
    - config.js: `units`→`boards`; a hive2 board-utak `rods/`→`boards/`; a master
    innerTempFrom path-os (temp/scale_c) helyett a saját rekordból {field:"temp_c"};
    a `weather:{env,temp}`+`tempPlot` helyett `env:{ rainTile, sensors[] }` — minden
    hive2 környezeti adat az `env/readings` ágból (a hive_c=kaptár-szonda is). A
    board-ok `calib` blokkja (súly-kalib) VÁLTOZATLAN. hive1 is `boards`-ra állt, de
    legacy marad (rods/temp utak érintetlenek, nincs firmware-változás nála).
    - app.js: teljes átigazítás az új sémára:
    - loadHive: path→sorozat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
2026-07-13 fix(dashboard): össz-súly ZOH-aggregáció a lineáris interpoláció helyett
    MIT (dashboard/public/app.js):
    - totalKgSeries: a board-ok async pontjainak közös idővonalra való LINEÁRIS
    interpolációját (interpAt) lecseréltem ZOH-ra ("tartott utolsó érték"): minden
    board a legutóbbi VALÓS mintáját tartja a következő valós mintájáig, és a total
    ezek összege. A total csak akkor keletkezik, ha MINDEN board-nak van már mintája
    az adott időig (nincs alulösszegzés a felfutásnál) — ez a korábbi "csak átfedésen
    összegzünk" invariáns ZOH-változata.
    - interpAt függvény TÖRÖLVE (csak a totalKgSeries használta → holt kód lett).
    - renderWeightChart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
2026-07-13 fix(dashboard): össz-súly = körönkénti VALÓS összeg + felső csempe; plot marad interpolált
    - totalKgSeries teljesen átírva KÖRÖS aggregációra (a ZOH/lépcsős kísérlet helyett,
    amit a felhasználó elvetett): a ~egyszerre (±2-3 perc) feltöltött mintákat KÖRÖKBE
    csoportosítja (egy kör = az első mintájától ROUND_WINDOW_MS=8 percen belüli minták),
    és körönként a board-ok VALÓS mért kg-értékeit adja össze. Így a total minden pontja
    tényleg MÉRT összeg, nem interpolált kompozit. Total-pont csak akkor születik, ha a
    körben MIND a board képviselve van → egy körből SEMMI súly nem vész el (hiányos kör
    k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
2026-07-14 felesleg törlése
    [PCB_layout.kicad_pcb, PCB_layout.kicad_sch]
2026-07-14 fix(dashboard): egyujjas függőleges húzás = oldalgörgetés (mobil), pinch marad zoom
    Mit: a chartok mobilon "elnyelték" a tiszta fel-le húzást (plot-pan lett
    belőle), így telefonon a lap görgetése nagyon nehéz volt az ábák miatt.
    A gesztusokat szétválasztottam:
    - egyujjas FÜGGŐLEGES húzás → OLDALGÖRGETÉS (a böngésző natívan),
    - egyujjas VÍZSZINTES húzás → idő-pan (ECharts inside dataZoom, változatlan),
    - kétujjas pinch → idő-zoom (változatlan).
    Miért/hogyan (gyökérok → megoldás):
    - Gyökérok: touch-action:none volt a konténeren ÉS a belső canvason (CSS
    !important + a hardenTouch JS is none-t tett rá). Ez MINDEN érintést az
    ECharts-na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
2026-07-14 feat(dashboard): eső a Környezet-legördülőben (visszanézhető idősor)
    Mit: az esőszenzor (rain_mm) mostantól a "Környezet" panel legördülőjében is
    választható, így az eső időben visszanézhető (időszakonkénti mm-delta idősor).
    Eddig az eső CSAK a felső sáv 24h csapadék-összeg csempéjeként (rainTile)
    létezett, plotolható nem volt.
    Hogyan:
    - config.js (hive2 env.sensors): új bejegyzés field:"rain_mm", label:"Eső
    (időszak)", unit:"mm", icon:🌧. A rain_mm eleve INTERVALLUM-DELTA (a rainTile
    ezeket összegzi 24h-ra), így a plot időszakonkénti esőmennyiséget mutat.
    - Új opcionális kapcsoló: chip:false. A sensors[] minden eleme eddig KÉT helyen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
2026-07-14 feat(dashboard): eső = lépcsős (nem interpolált) + folytonos idősorok enyhén simítva
    Két kérés a chart-vonalakra:
    1) Eső → LÉPCSŐS, nem interpolált:
    - Gyökérindok: a densify() lineárisan interpolál a pontok közé, ami az eső
    0→spike deltáinál rámpát húz → "folyamatos esőnek" tűnik. Rossz.
    - Megoldás: config rain_mm-re step:true. A drawEnvSeries a step-szenzoroknál
    a NYERS pontokat adja (NINCS densify), és step:"end" vonalat rajzol → minden
    időszak a saját mm-delta értékét tartja, éles lépcsőkkel.
    2) Folytonos idősorok (súly, hőm, pára, nyomás) → enyhén SIMÍTOTT, kevésbé
    szögletes:
    - Új LINE_SMOOTH=0.3 kon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
2026-07-14 feat(dashboard): hive1 spike-szűrés (gördülő medián) az éles prototípus-appból
    Mit: a hive1 (prototípus) súly-görbéjéből eltűnnek a HW-eredetű random tüskék —
    átültettem az éles app (prototype/public/app.js) spike-szűrőjét: rúdankénti
    CENTRÁLT gördülő medián (k=5), az összegzés/rajzolás ELŐTT.
    Miért/hogyan:
    - Forrás: prototype/public/app.js medianSmooth(rows,k) + MEDIAN_K=5. Ott a w1/w2
    rúdakra KÜLÖN, a pairTotal ÖSSZEGZÉS előtt fut → a total és a per-rúd nézet is
    tiszta. A HX711/mechanikai 1-2 mintás ±pár kg tüskéket a medián kiüti, a valós
    tömegtrendet és finom dinamikát megőrzi.
    - Új app megfelelője: a boardWeightKg a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
2026-07-14 feat(dashboard): dátum-tengely "nap-sáv" (date band) a középső felirat helyett
    A felhasználó a korábbi "egy középső dátum-felirat" helyett a napváltásos
    megjelenítést kéri: MINDEN nap alá a saját dátuma, a nap szakaszának közepére
    igazítva; sok nap esetén a zsúfolás kezelve. (public/app.js, chartOption grid.)
    Váltás (visszavont: xAxis.name középső felirat + rangeDateLabel/updateDateLabel):
    - A tick-ek TOVÁBBRA is csak óra:perc (hmLabel formatter — változatlan).
    - Új updateDayBands(chartId): a látható tengely-extentből (currentXExtent) napról
    napra lépked (DST-helyes: new Date + setDate(+1), nem fix 86.4e6), minden naphoz
    a szakasz [start,end]-j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
2026-10-06 feat(dashboard): gyors időtáv-gombok (1 nap / 1 hét / 1 hónap / teljes) mindkét charton
    - index.html: a súly- és a környezet-panel fejlécében a korábbi egyetlen
    "⟲ Teljes nézet" gomb helyett gombcsoport (.chart-actions): 1 nap, 1 hét,
    1 hónap, Teljes nézet (data-range-days + data-chart attribútumok, aria-label).
    - app.js: setQuickRange(chartId, days) — a chartban ténylegesen jelen levő
    adatpontok min/max idejéből számol dataZoom start-%-ot, az ablak vége az
    UTOLSÓ adatpont (nem a falióra), rövidebb történetnél a teljes tartomány.
    - style.css: .panel-head wrap, .panel-label, .chart-actions; mobilon (<640px)
    a gombsor új sorba törik, kisebb gom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
2026-10-06 feat(dashboard): össz-súly = ciklus-párosítás (weight-total.js) a fix 8 perces kör-ablak helyett
    - Új public/weight-total.js (tiszta, böngésző-független ESM):
    - estimateSamplePeriod(perBoard): boardonkénti medián mintaköz → flotta-medián.
    - totalKgSeries(perBoard): "anchor" board (mintaszáma a flotta-mediánhoz
    legközelebb) mintái adják a ciklusokat; a többi board minden mintája a
    LEGKÖZELEBBI anchor-ciklushoz kerül, ha 0,55·periódusnál közelebb van.
    Egy minta max. egy ciklusba; félciklus-döntetlen → a korábbi ciklus.
    Total csak ott, ahol MINDEN board képviselve van; a total = valós minták
    összege (nincs board-szintű interpo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
2026-10-06 docs: terepi felhő-diagnózis (2026-07-31) + utóirat, hogy elavult
    Mit: docs/field_cloud_diagnosis_2026-07-31.md verziózása (korábban
    untracked). Tartalma: a 2026-07-31-i RTDB/Auth ellenőrzés — hive1 07-24-én,
    a hive2 master 07-30 09:14 UTC-kor állt le; auth/rules/séma/dashboard-path
    kizárva; helyszíni ellenőrző lista.
    Utóirat a fájl tetején (2026-10-06): a pillanatkép elavult — az RTDB szerint
    a master 08-01 07:46-kor újraindult (új boot-ID) és helyreállt; a 46,5 órás
    master-lyuk alatt a node_1 rekordjai folyamatosak (a master saját mérése
    esett ki, nem a vétel). A hive1 visszajött, majd 09-20-án újra leállt.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
2026-10-06 feat(dashboard): részösszeg kiesett board esetén (24 h hallgatás után), külön szaggatott sorozatként
    - weight-total.js:
    - retiredBoards(perBoard, retireAfterMs): egy board "kiesett", ha az utolsó
    mintája a telepítés legfrissebb mintájánál retireAfterMs-nél régebbi
    (üres board is, de csak ha a retire be van kapcsolva).
    - totalKgSeries(perBoard, { retireAfterMs }) : az idővonalat a kiesett boardok
    utolsó mintáinál szegmensekre vágja; szegmensenként a még aktív boardokra
    fut a (pairCycles-be kiemelt, változatlan) ciklus-párosítás. Pont-formátum
    [ts, kg, aktívBoardSzám]. Alapértelmezés (Infinity) = a régi viselkedés.
    - densifyTo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
2026-10-06 docs(memory): terepi állapot (2026-10-06) + dashboard prodon + részösszeg rögzítése
    Mit (MEMORY.md, a felhasználóval egyeztetve):
    - Fejléc: új "Utolsó frissítés: 2026-10-06" bejegyzés.
    - 11. szakasz:
    - A "PROD érintetlen, csak preview v2" állítás javítva: az új dashboard
    2026-07-15 óta a terrarium1.web.app live csatornán fut (a v2 lejárt);
    deploy-recept: preview channel → nézés → `firebase deploy --only hosting`.
    - Össz-súly leírása: ciklus-párosítás (weight-total.js) + részösszeg
    kiesett boardnál (>24 h).
    - Új "Terepi állapot" alszakasz (RTDB-ből ellenőrizve): master él, de 2 db
    hosszú saját-mérés-kiesés (07-30→08-01,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
